timopieters6-spec/Autonome-zepplin-BLIMP-/README.md

# Autonome Zeppelin BLIMP

This repository serves as the central knowledge base for project-related files, reports, notes, and supporting materials connected to the Autonome Zeppelin BLIMP work.

## Purpose

The goal of this repository is to provide a single organized location for:
- project reports and findings
- supporting documentation
- reference files and templates
- notes and internal documentation
- data, assets, and related artifacts
- anything connected to the project’s development and documentation

## Repository Role

This repository is intended to act as a structured hub where all project information can be stored, reviewed, and accessed centrally. It helps keep materials organized and easy to find as the project evolves.

## Suggested Structure

A clean project structure may look like this:

```text
.
├── README.md
├── docs/
│   ├── reports/
│   ├── notes/
│   └── references/
├── data/
├── assets/
├── scripts/
├── templates/
├── exports/
└── misc/
