timopieters6-spec/Autonome-zepplin-BLIMP-/Software/Readme

Blimp_Ws = pepper herman, autonoom systeem van de blimp
