timopieters6-spec/Autonome-zepplin-BLIMP-/3d print files (stl,3mf)/STL/V2/PLT_MAIN_TOT_V2_CF-LESS_2025-2-20.stl

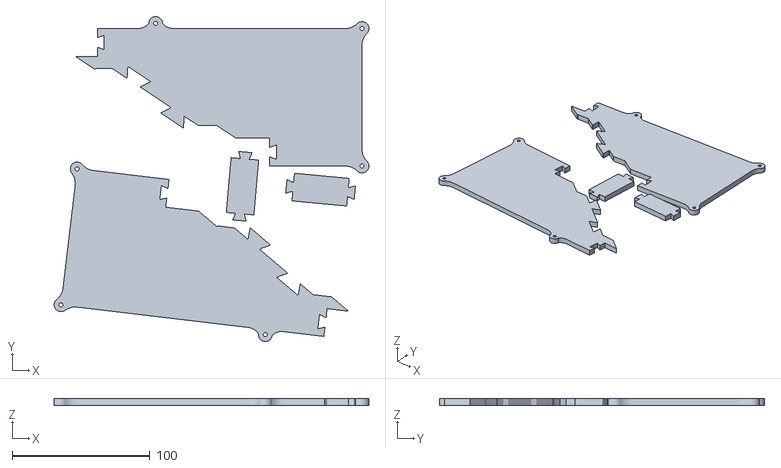
[picture p66: CAD file, 2026-09-20]
3d print files (stl,3mf)/STL/V2/PLT_MAIN_TOT_V2_CF-LESS_2025-2-20.stl
228.8 x 236.2 x 5.00
