timopieters6-spec/Autonome-zepplin-BLIMP-/3d print files (stl,3mf)/STL/V2/BLIMP_FULL_V2_3MF.3mf

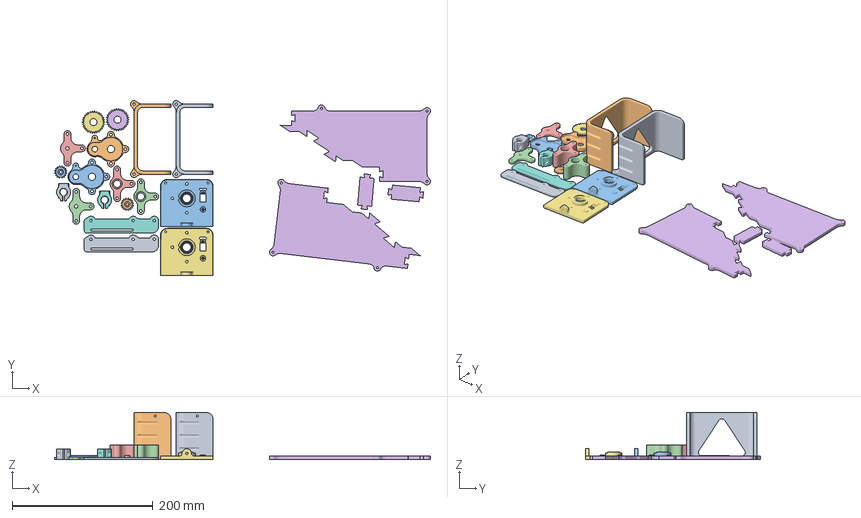
[picture p67: CAD file, 2026-09-20]
3d print files (stl,3mf)/STL/V2/BLIMP_FULL_V2_3MF.3mf
534.3 x 248.4 x 67.0 mm
BOX_FRONT_REAR_V4_CF_LESS_2025-2-20 - Copy.stl x 2
BOX_SIDE_V4_CF_LESS_2025-2-20 - Copy.stl x 2
BEAR_GEAR_HOUSING_SPACER_V1_2025-2-21 - Copy.stl x 2
PLT_MAIN_TOT_V2_CF-LESS_2025-2-20 - Copy.stl
ENV_ATTACH_V3_2025-2-20 - Copy.stl x 2
GEAR_HOUSING_SIDE_V1_2025-2-20 - Copy.stl x 2
GEAR_HOUSING_CAP_V1_2025-2-21 - Copy.stl x 2
GEAR_M1_Z30_FW3_V1_2025-2-20 - Copy.stl x 2
MNT_MOTOR_ARM_V2_2025-2-5.stl x 2
GEAR_M1_Z16_FW3_V1_2025-2-20 - Copy.stl x 2
