timopieters6-spec/Autonome-zepplin-BLIMP-/3d print files (stl,3mf)/3MF/BOX_TOT_v1_2025-02-01.3mf

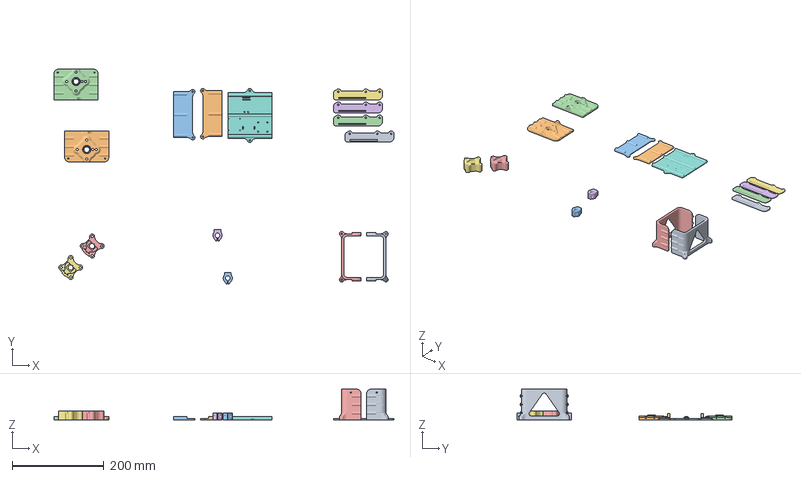
[picture p68: CAD file, 2026-09-20]
3d print files (stl,3mf)/3MF/BOX_TOT_v1_2025-02-01.3mf
739.7 x 467.2 x 67.0 mm
(1-2-25) Envelope attachments v2.STL x 4
(1-2-25) Box main v3.STL_A_B_B
(2-5-25) Motor mount v2.STL x 2
(1-2-25) Box main v3.STL_A_B_A
(1-2-25) inner bearings holder.STL x 2
(1-2-25) bottom plate v2.STL_B_A
(1-2-25) Box main v3.STL_A_A
(1-2-25) bottom plate v2.STL_B_B
(1-2-25) bottom plate v2.STL_A
(1-2-25) Box main v3.STL_B
