timopieters6-spec/Autonome-zepplin-BLIMP-/3d print files (stl,3mf)/STL/MNT_MOTOR_ARM_V2_2025-2-5.stl

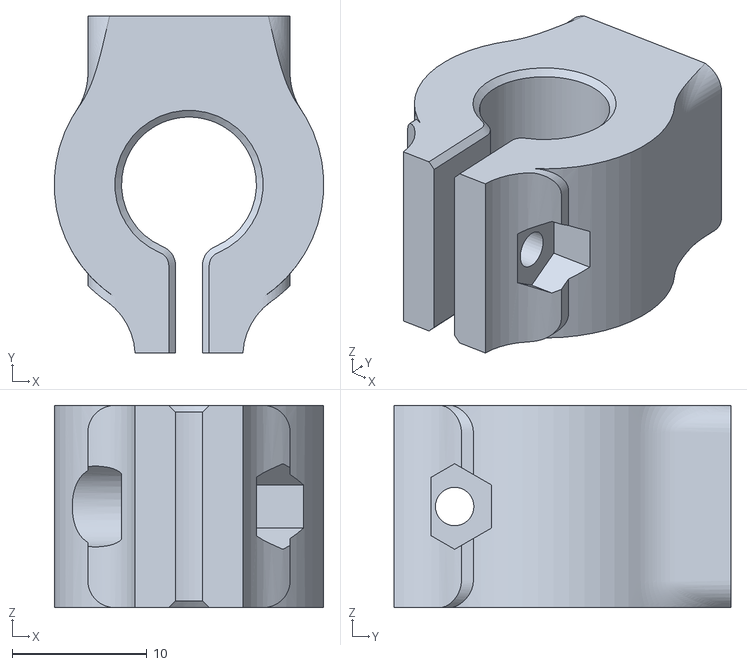
[picture p69: CAD file, 2026-09-20]
3d print files (stl,3mf)/STL/MNT_MOTOR_ARM_V2_2025-2-5.stl
20.0 x 25.0 x 15.0
