timopieters6-spec/Autonome-zepplin-BLIMP-/CAD files/Zepplin Frame v3.stl

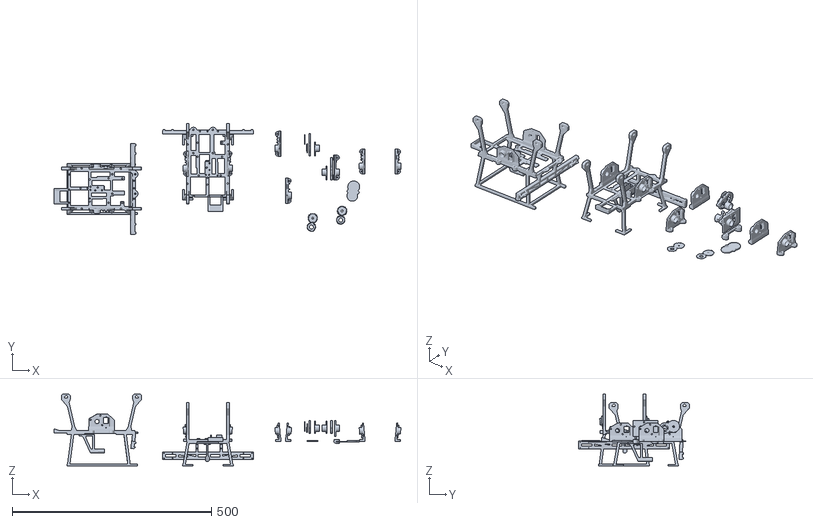
[picture p70: CAD file, 2026-09-20]
CAD files/Zepplin Frame v3.stl
871.8 x 278.4 x 180.7
