timopieters6-spec/Autonome-zepplin-BLIMP-/3d print files (stl,3mf)/3MF/BOX_TOT_v3_2025-04-09.3mf

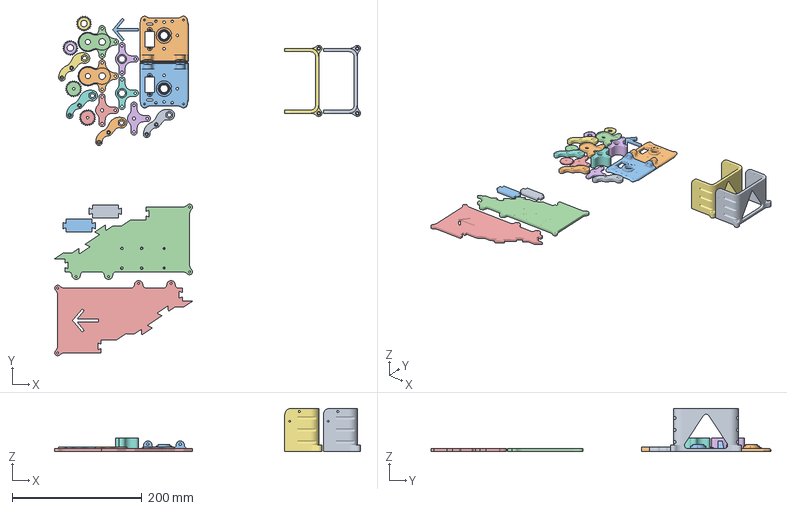
[picture p71: CAD file, 2026-09-20]
3d print files (stl,3mf)/3MF/BOX_TOT_v3_2025-04-09.3mf
472.1 x 524.1 x 67.0 mm
(2-24-25) Box main v4 front.stl x 2
(2-24-25) Box main v4_cf-less_MIR.stl
(2-24-25) Box main v4_cf-less.stl
(19-4-25) lower part bottom plate.stl
(19-4-25) Upper part bottom plate.stl
(2-22-25) Bearing spacer.STL x 2
Bowtie v3.stl x 2
(2-24-25) Gear housing side.STL x 2
(2-22-25) Bearing spacer cap.STL x 2
(1-24-25) Envelope attachments v3.stl x 4
Arrow.stl
(2-22-25) Spur Gear z23 m1 fw3.STL x 2
(2-22-25) Spur Gear z21 m1 fw3.STL x 2
