timopieters6-spec/Autonome-zepplin-BLIMP-/3d print files (stl,3mf)/STL/PLT_MIDDLE_V2_2025-2-1.stl

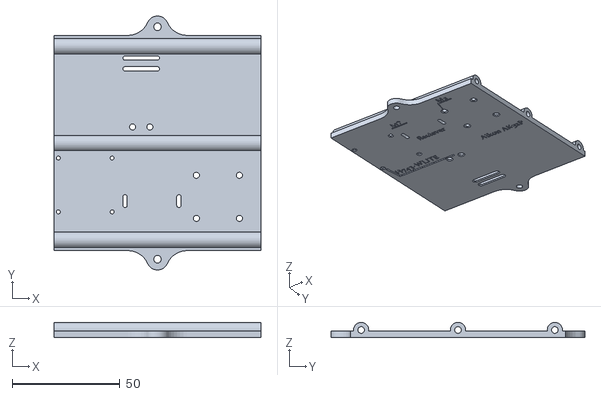
[picture p72: CAD file, 2026-09-20]
3d print files (stl,3mf)/STL/PLT_MIDDLE_V2_2025-2-1.stl
96.1 x 118.0 x 7.10
