timopieters6-spec/Autonome-zepplin-BLIMP-/3d print files (stl,3mf)/STL/V2/BEAR_HOUSING_CAP_V1_2025-2-21.stl

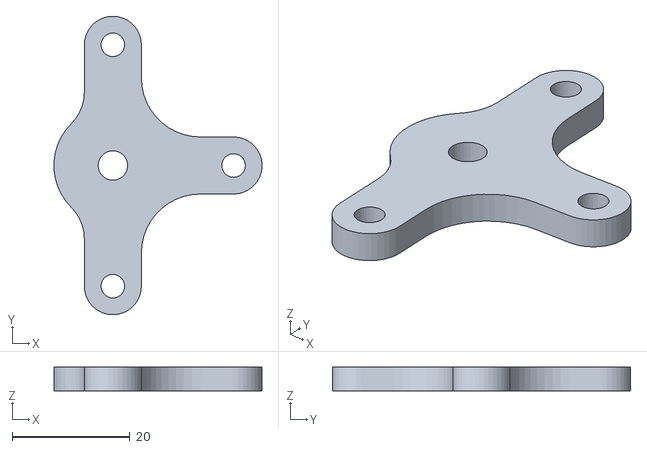
[picture p73: CAD file, 2026-09-20]
3d print files (stl,3mf)/STL/V2/BEAR_HOUSING_CAP_V1_2025-2-21.stl
35.3 x 50.7 x 4.00
