timopieters6-spec/Autonome-zepplin-BLIMP-/3d print files (stl,3mf)/3MF/BOX_TOT_v2_CF_2025-02-20.3mf

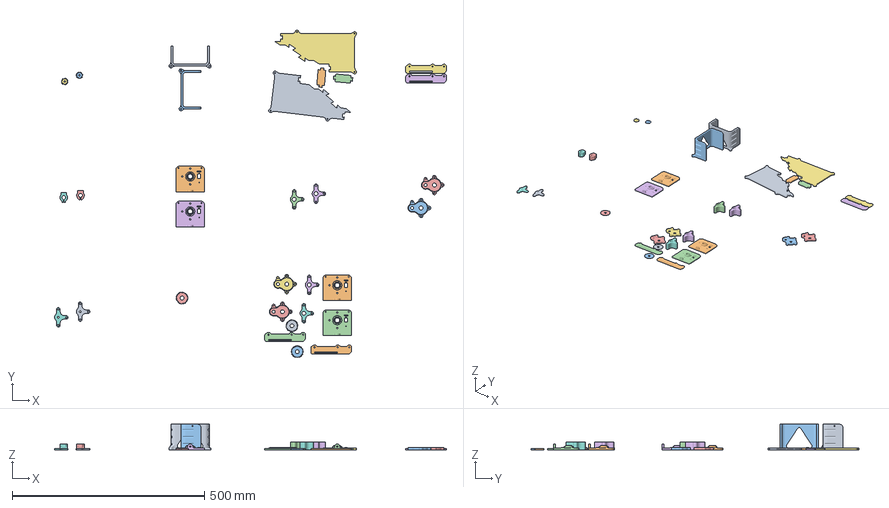
[picture p74: CAD file, 2026-09-20]
3d print files (stl,3mf)/3MF/BOX_TOT_v2_CF_2025-02-20.3mf
1020.0 x 852.3 x 67.0 mm
(20-2-25) Box main v4 cf-less.STL_A_A
(20-2-25) Box main v4 cf-less.STL_A_B_A x 4
Gear 1, m1 z16 fw3.STL x 2
(2-20-25) Gear housing side.STL x 4
(2-21-25) Bearing spacer.STL x 4
(2-21-25) Bearing spacer cap.STL x 2
(1-24-25) Envelope attachments v2.STL x 4
Gear 2, m1 z30 fw3 hub 10.2.STL x 3
MNT_MOTOR_ARM_V2_2025-2-5.stl x 2
(2-23-25) Bottom platre v3.STL_B
(2-23-25) Bottom platre v3.STL_A_B_B
(2-23-25) Bottom platre v3.STL_A_B_A
(20-2-25) Box main v4 cf-less.STL_B
(2-23-25) Bottom platre v3.STL_A_A
