timopieters6-spec/Autonome-zepplin-BLIMP-/3d print files (stl,3mf)/STL/HOLD_BEAR_SERVO_V1_2025-2-1.stl

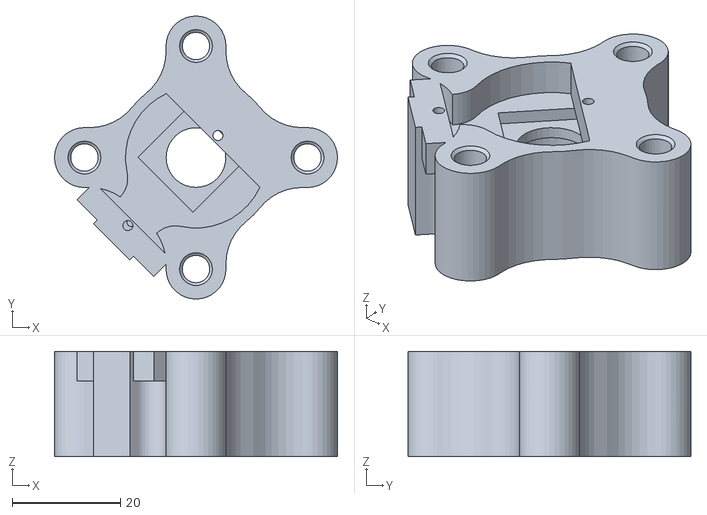
[picture p75: CAD file, 2026-09-20]
3d print files (stl,3mf)/STL/HOLD_BEAR_SERVO_V1_2025-2-1.stl
52.2 x 52.2 x 19.4
