timopieters6-spec/Autonome-zepplin-BLIMP-/3d print files (stl,3mf)/STL/V2/BOX_SIDE_V4_CF_LESS_2025-2-20.stl

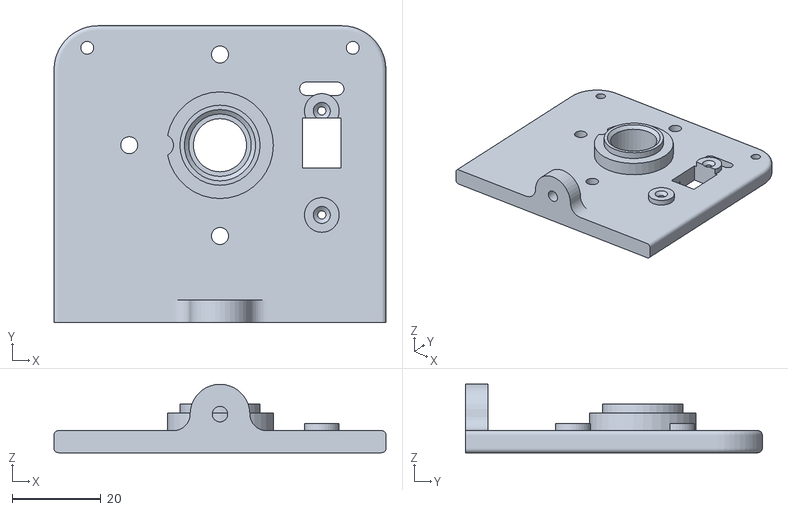
[picture p76: CAD file, 2026-09-20]
3d print files (stl,3mf)/STL/V2/BOX_SIDE_V4_CF_LESS_2025-2-20.stl
75.0 x 67.0 x 15.5
