timopieters6-spec/Autonome-zepplin-BLIMP-/3d print files (stl,3mf)/STL/PLT_OUTTER_V2_2025-2-1.stl

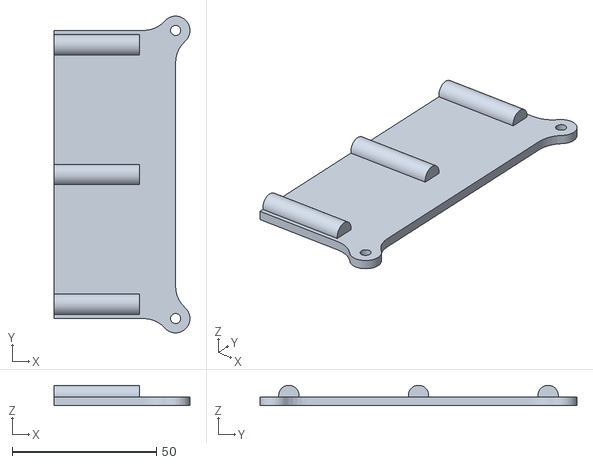
[picture p77: CAD file, 2026-09-20]
3d print files (stl,3mf)/STL/PLT_OUTTER_V2_2025-2-1.stl
47.2 x 110.0 x 7.10
