timopieters6-spec/Autonome-zepplin-BLIMP-/3d print files (stl,3mf)/STL/V2/GEAR_M1_Z30_FW3_V1_2025-2-20.stl

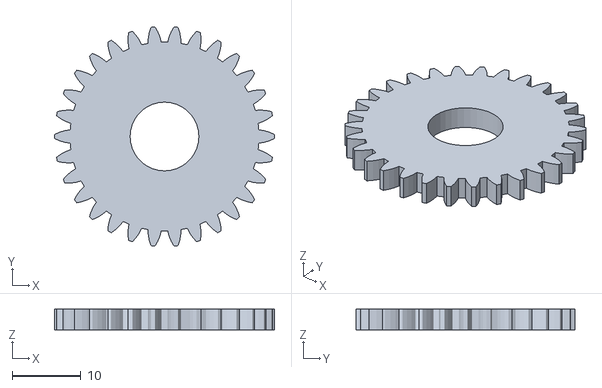
[picture p78: CAD file, 2026-09-20]
3d print files (stl,3mf)/STL/V2/GEAR_M1_Z30_FW3_V1_2025-2-20.stl
32.0 x 31.9 x 3.00
