timopieters6-spec/Autonome-zepplin-BLIMP-/3d print files (stl,3mf)/STL/ENV_ATTACH_V3_2025-2-20.stl

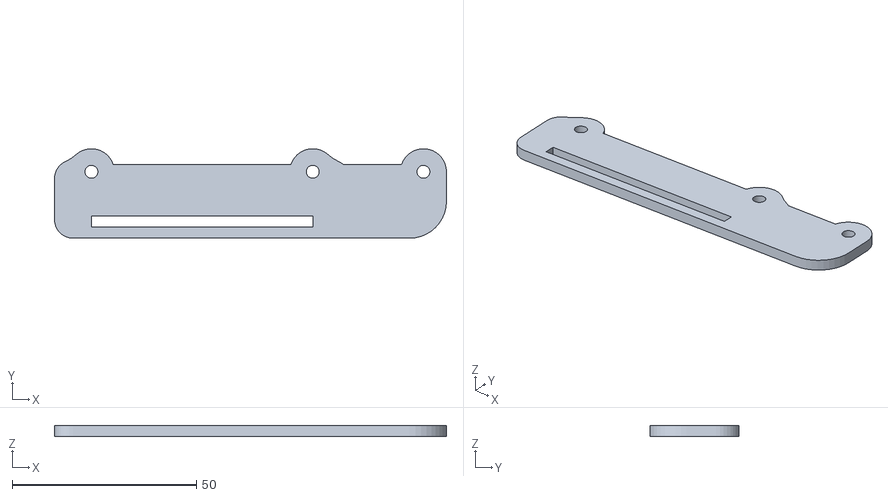
[picture p79: CAD file, 2026-09-20]
3d print files (stl,3mf)/STL/ENV_ATTACH_V3_2025-2-20.stl
106.2 x 24.2 x 3.00
