timopieters6-spec/Autonome-zepplin-BLIMP-/3d print files (stl,3mf)/STL/V2/GEAR_M1_Z16_FW3_V1_2025-2-20.stl

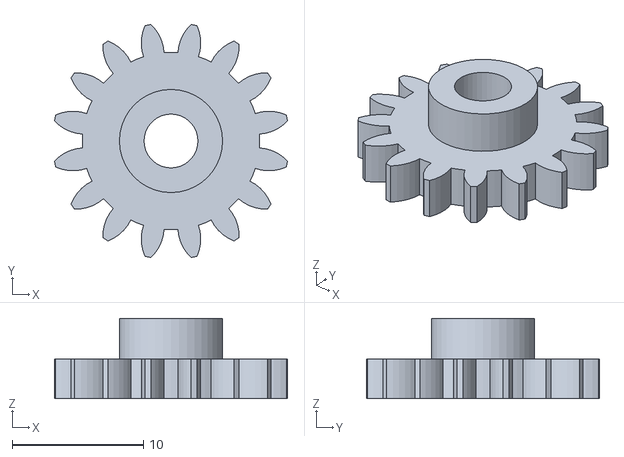
[picture p80: CAD file, 2026-09-20]
3d print files (stl,3mf)/STL/V2/GEAR_M1_Z16_FW3_V1_2025-2-20.stl
17.7 x 17.7 x 6.10
