timopieters6-spec/Autonome-zepplin-BLIMP-/3d print files (stl,3mf)/STL/PLT_BOTTOM_V2_2025-1-24.STL

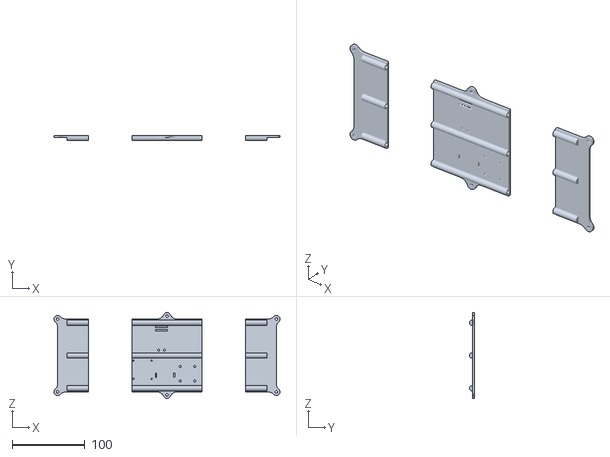
[picture p81: CAD file, 2026-09-20]
3d print files (stl,3mf)/STL/PLT_BOTTOM_V2_2025-1-24.STL
310.0 x 7.10 x 118.0
