timopieters6-spec/Autonome-zepplin-BLIMP-/3d print files (stl,3mf)/STL/BOX_SIDE_V3_2025-2-1.STL

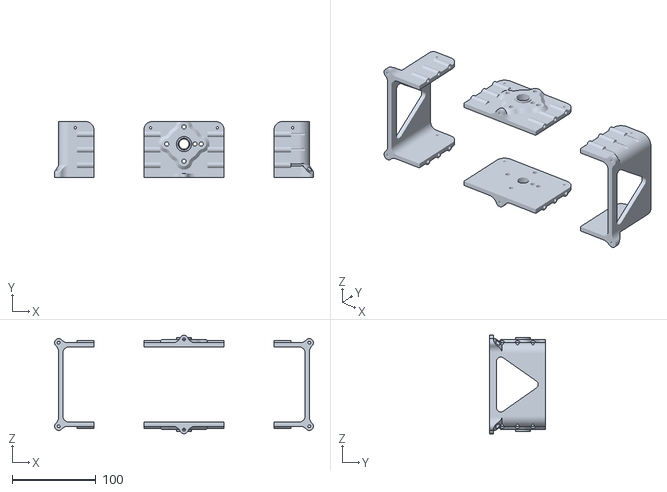
[picture p82: CAD file, 2026-09-20]
3d print files (stl,3mf)/STL/BOX_SIDE_V3_2025-2-1.STL
310.0 x 67.0 x 118.0
