timopieters6-spec/Autonome-zepplin-BLIMP-/3d print files (stl,3mf)/STL/V2/GEAR_HOUSING_SIDE_V1_2025-2-20.stl

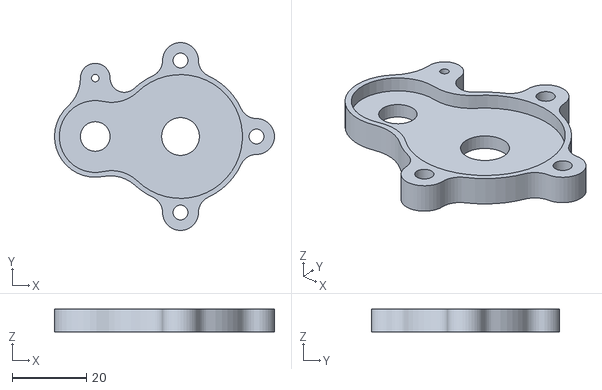
[picture p83: CAD file, 2026-09-20]
3d print files (stl,3mf)/STL/V2/GEAR_HOUSING_SIDE_V1_2025-2-20.stl
59.3 x 50.7 x 6.10
