timopieters6-spec/Autonome-zepplin-BLIMP-/3d print files (stl,3mf)/STL/V2/BOX_FRONT_REAR_V4_CF_LESS_2025-2-20.stl

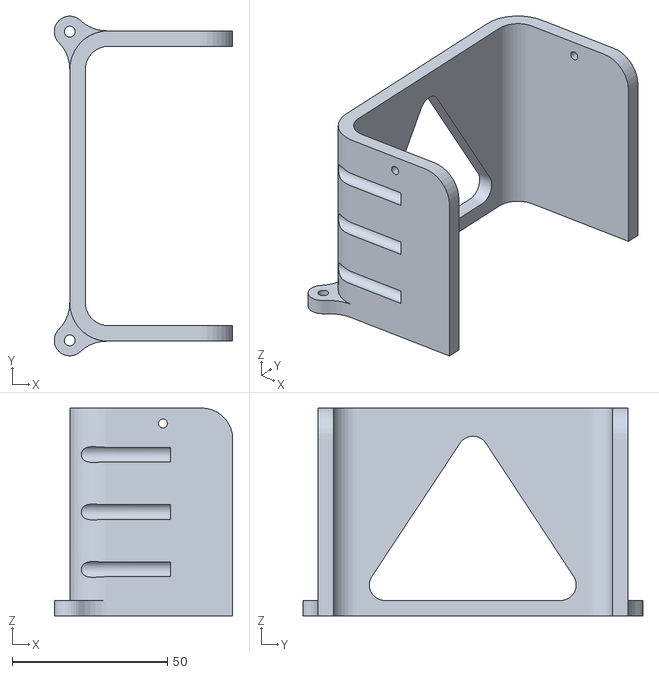
[picture p85: CAD file, 2026-09-20]
3d print files (stl,3mf)/STL/V2/BOX_FRONT_REAR_V4_CF_LESS_2025-2-20.stl
57.5 x 109.4 x 67.0
