timopieters6-spec/Autonome-zepplin-BLIMP-/(list of files, cad)

Other CAD files:
3d print files (stl,3mf)/STL/ENV_ATTACH_V2_2025-2-1.stl
3d print files (stl,3mf)/STL/V2/BEAR_GEAR_HOUSING_SPACER_V1_2025-2-21 - Copy.3mf
