timopieters6-spec/Autonome-zepplin-BLIMP-/Documentatie/HvAirship_Design_report.1pdf.pdf

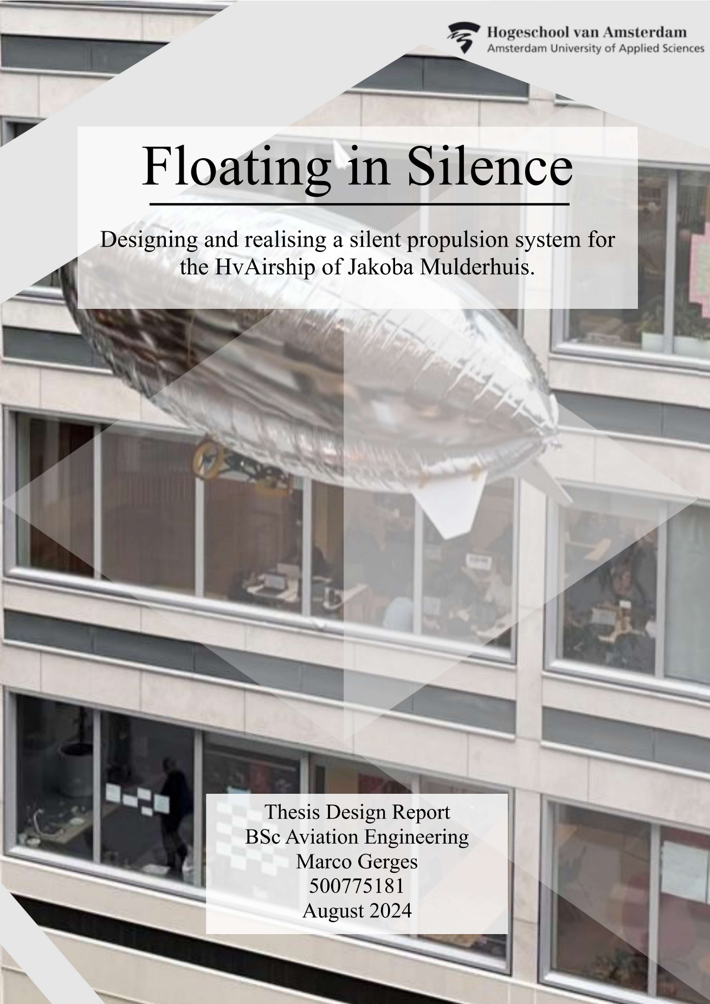
[picture p86: page 1]

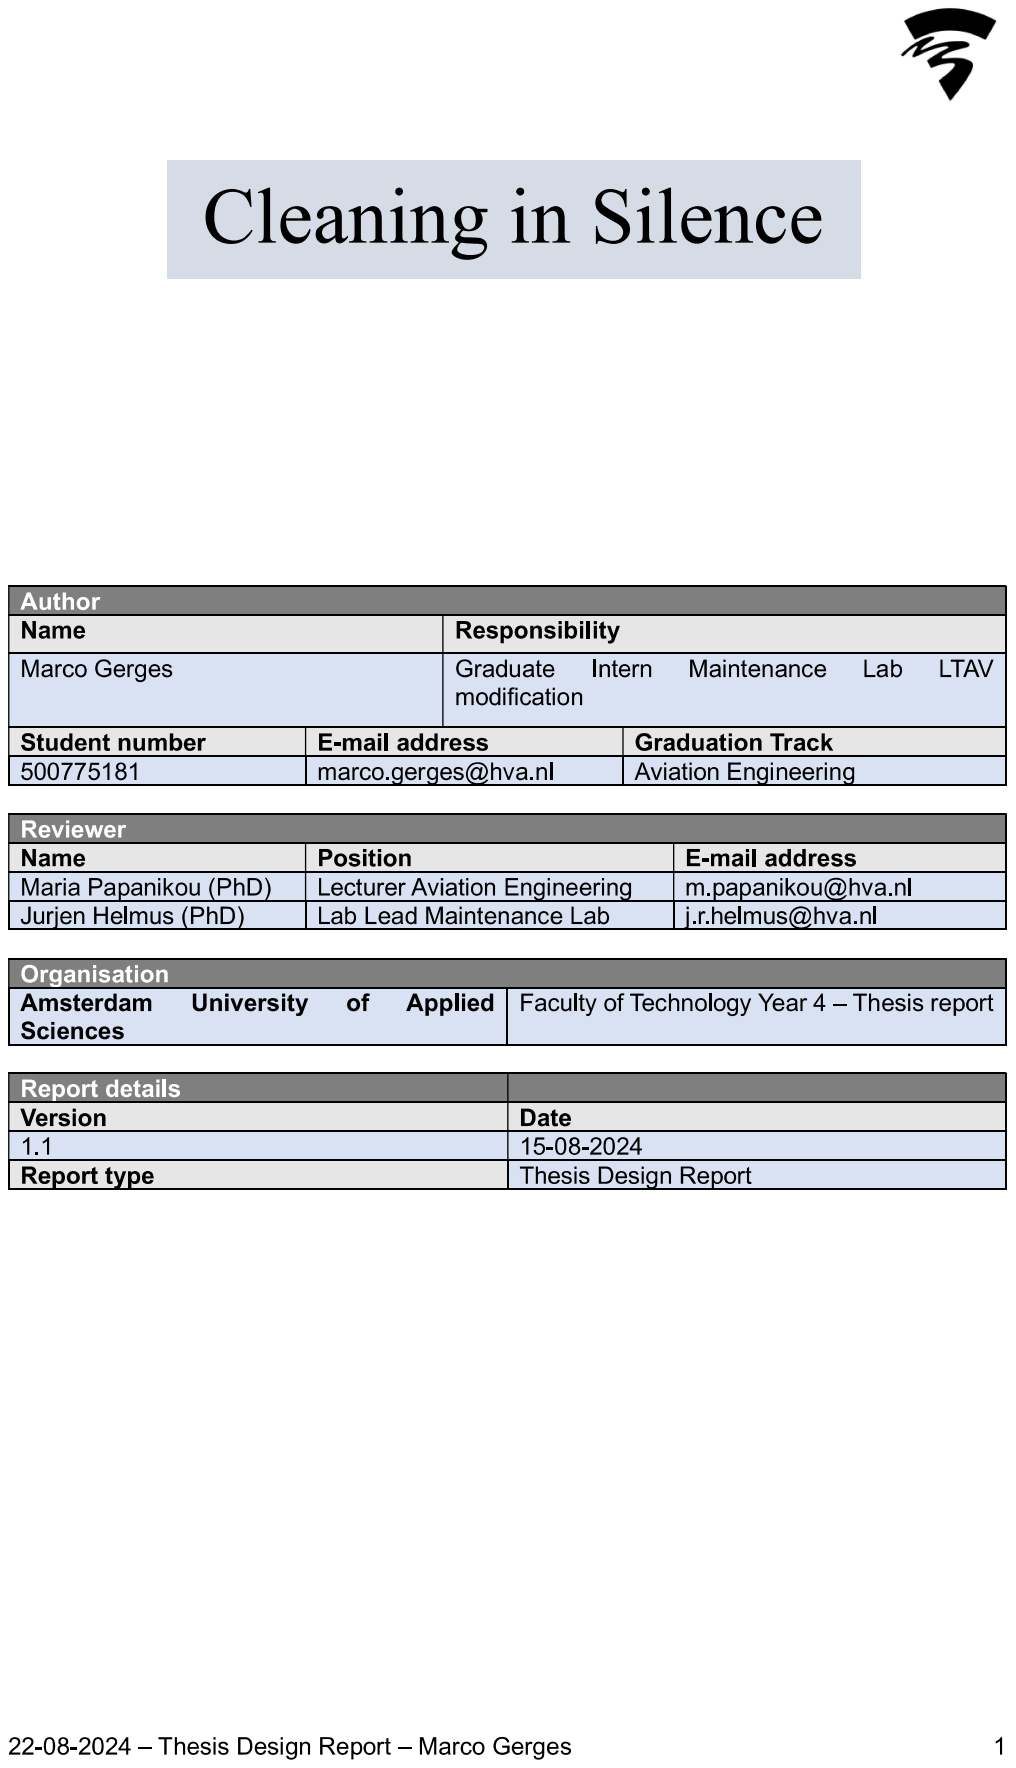
[picture p87: page 2]

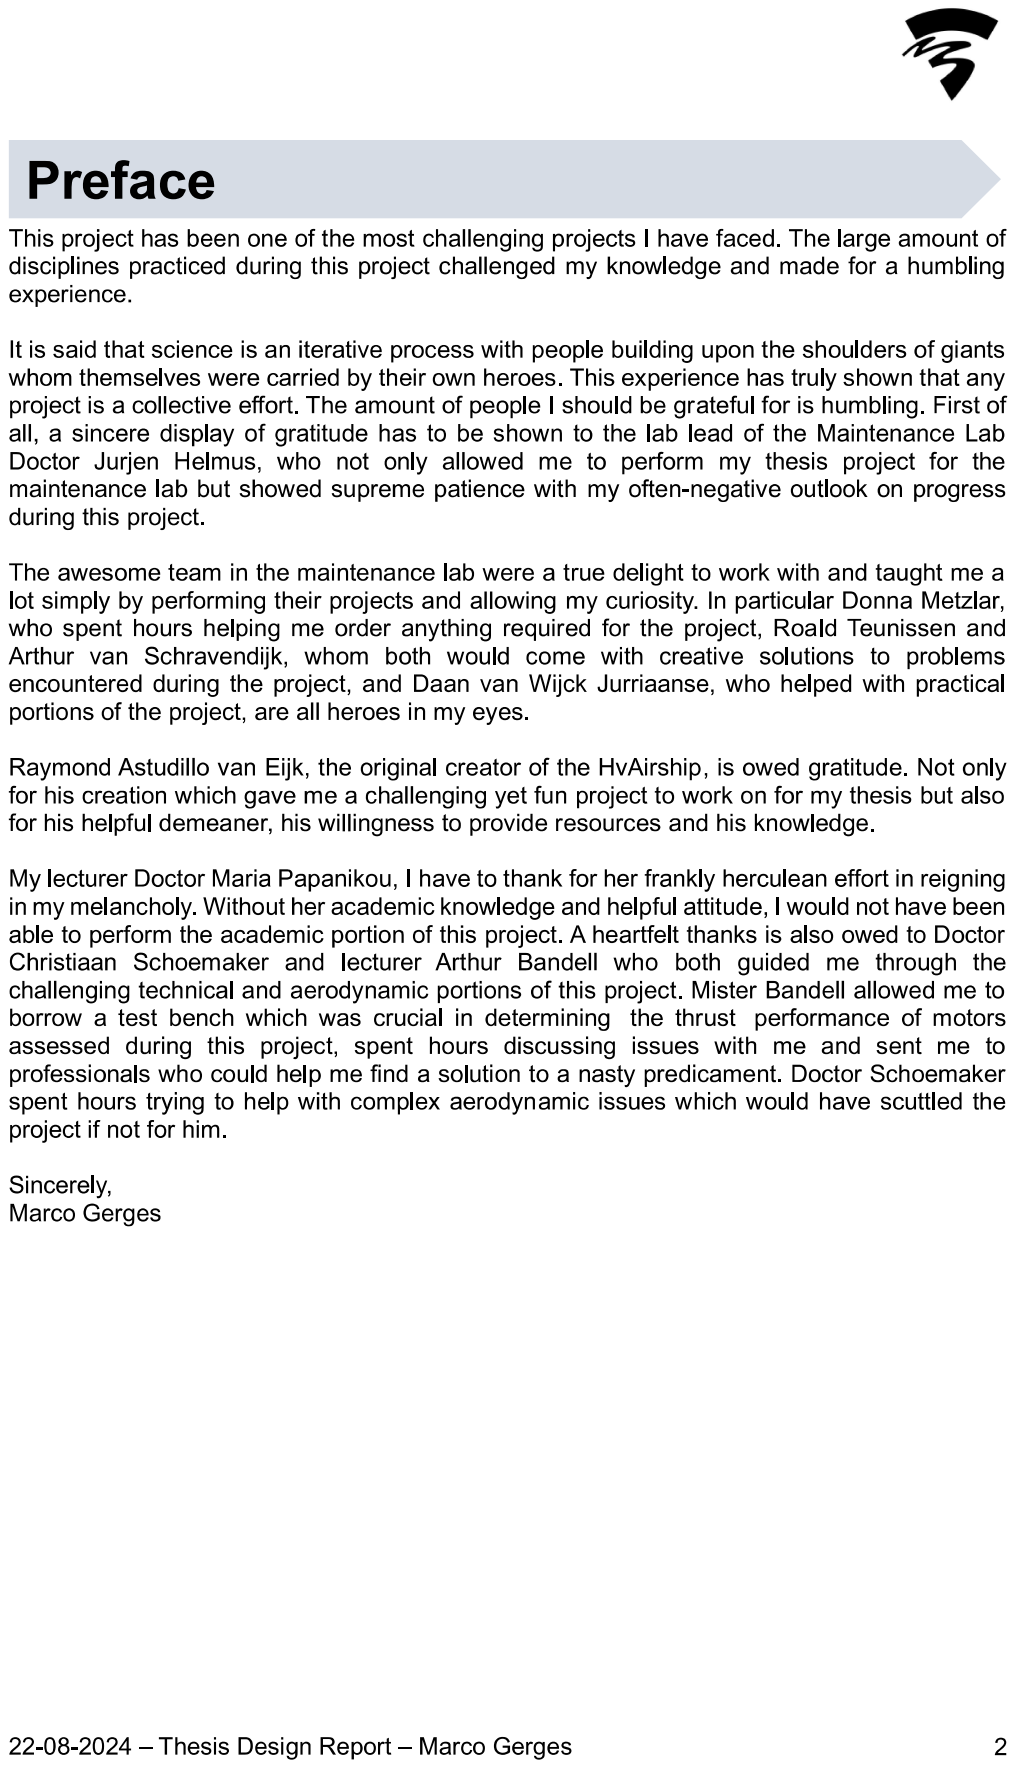
[picture p88: page 3]

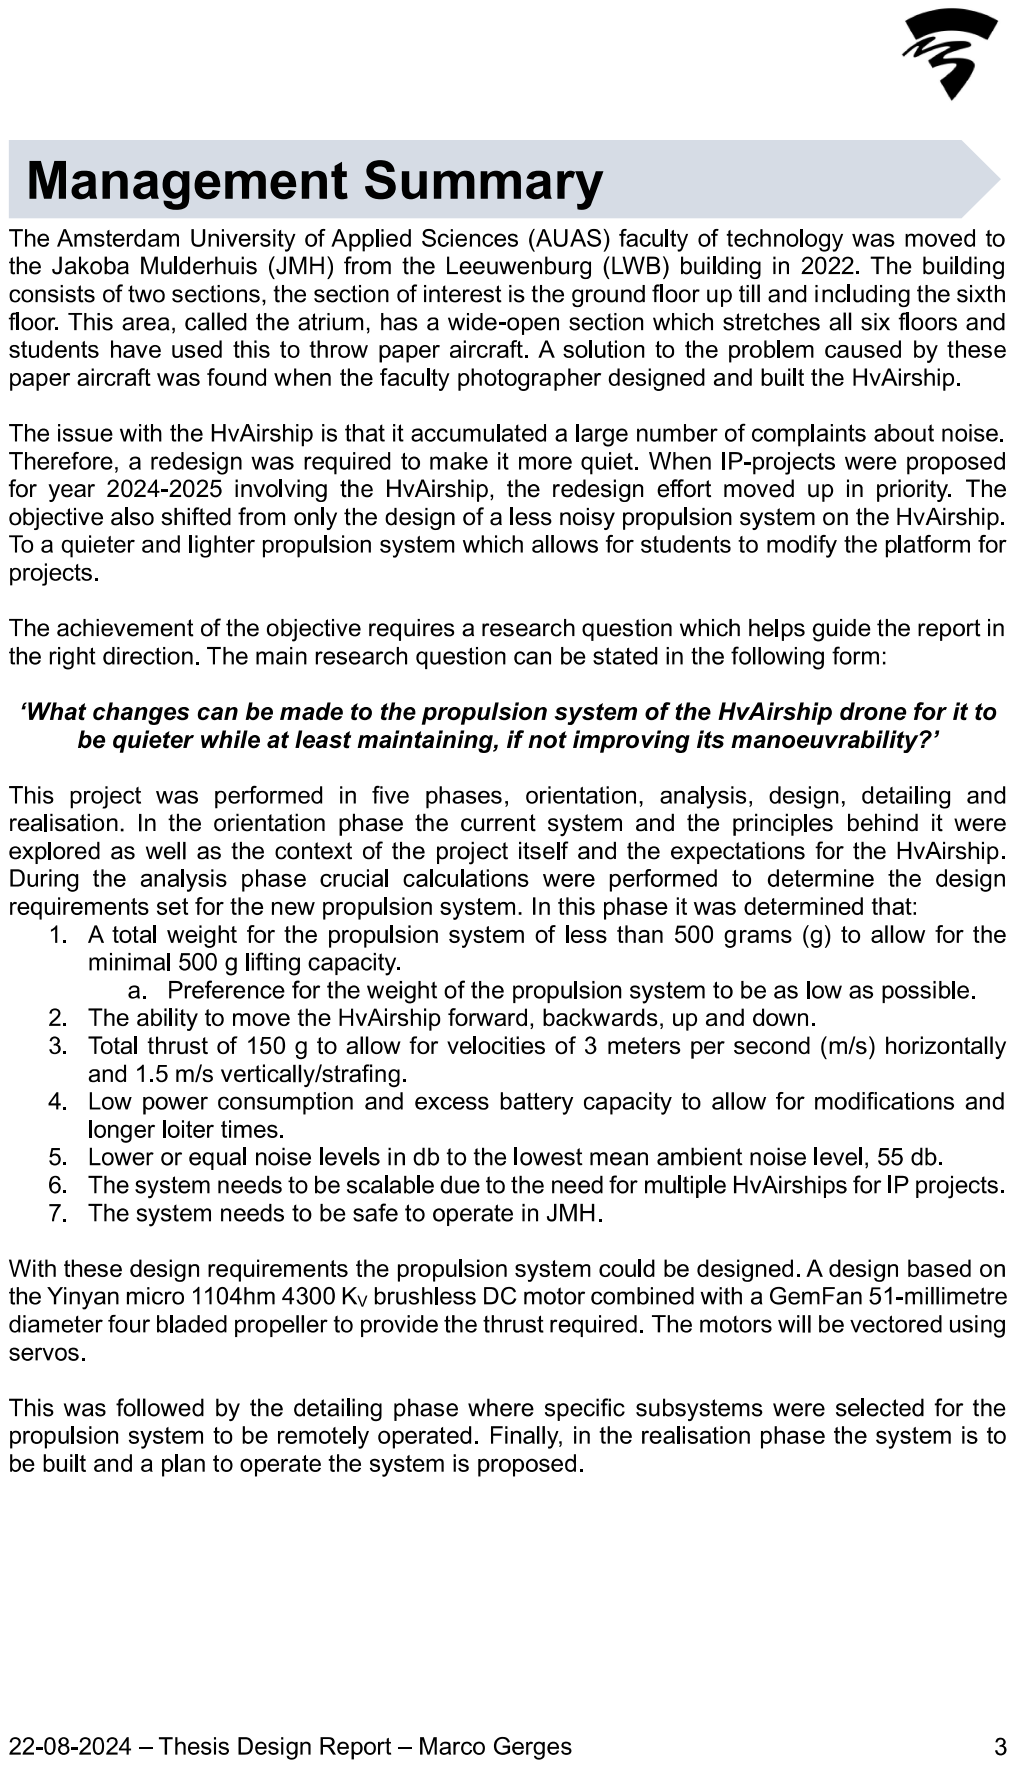
[picture p89: page 4]

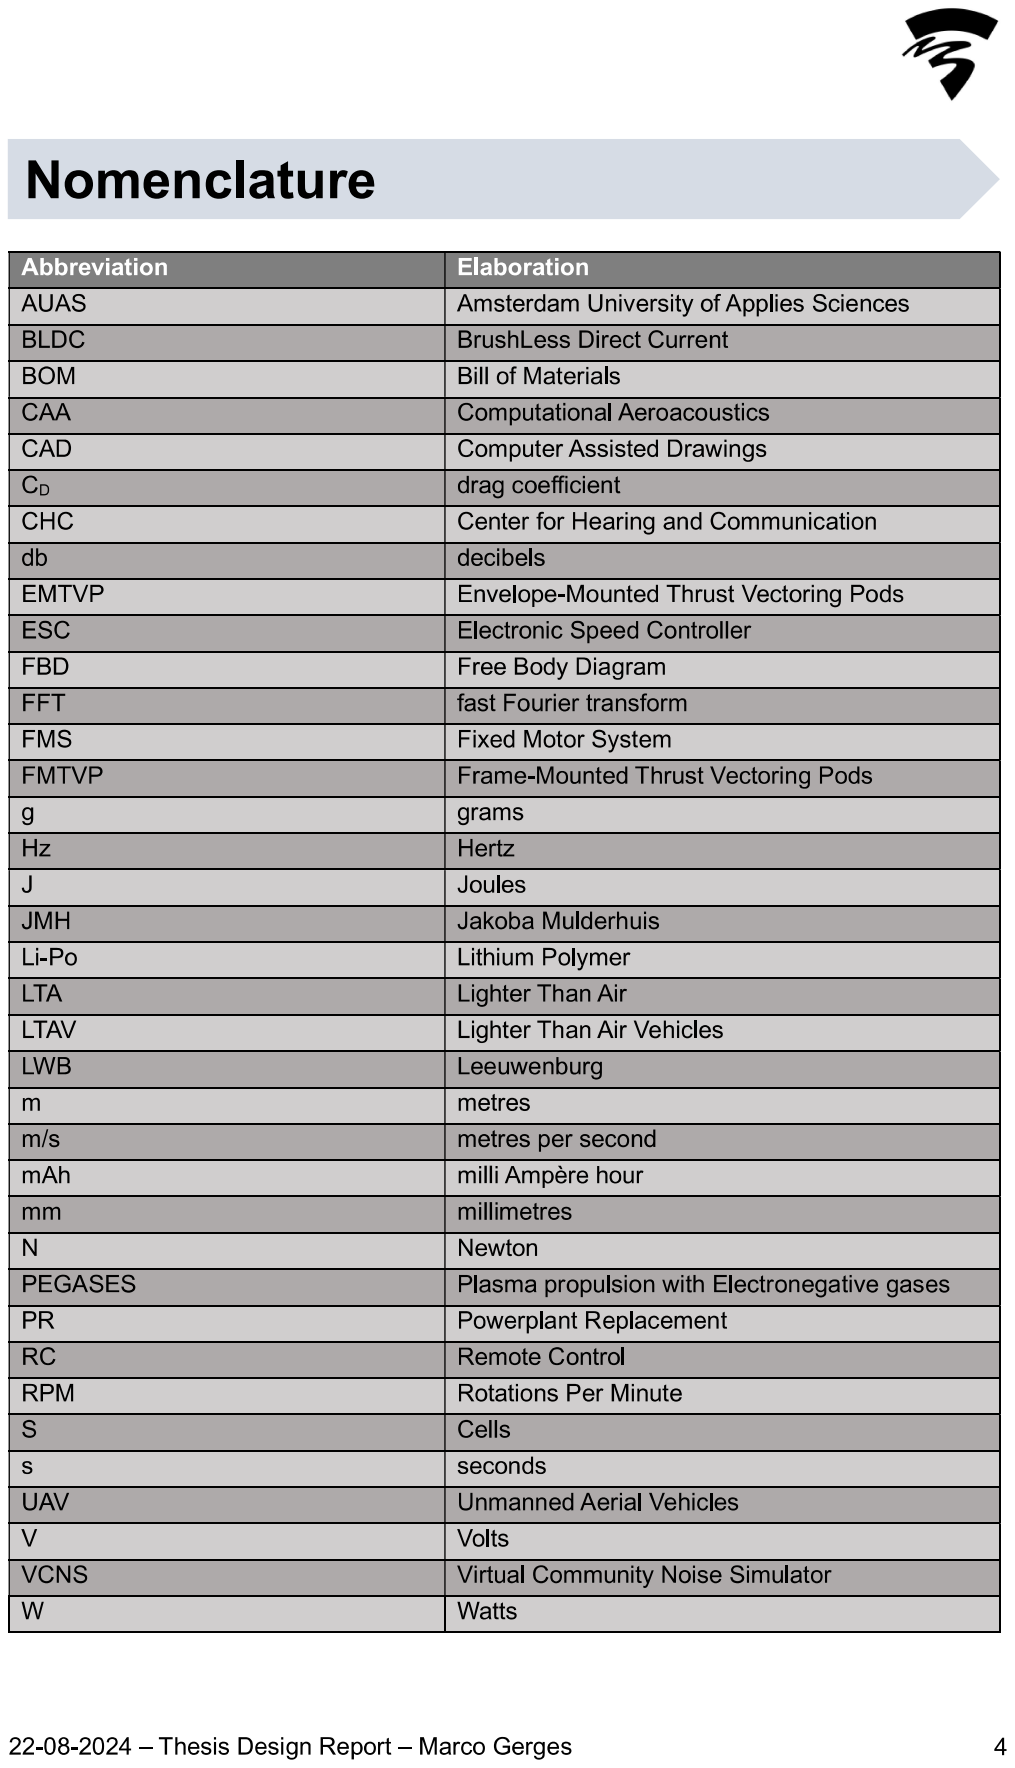
[picture p90: page 5]

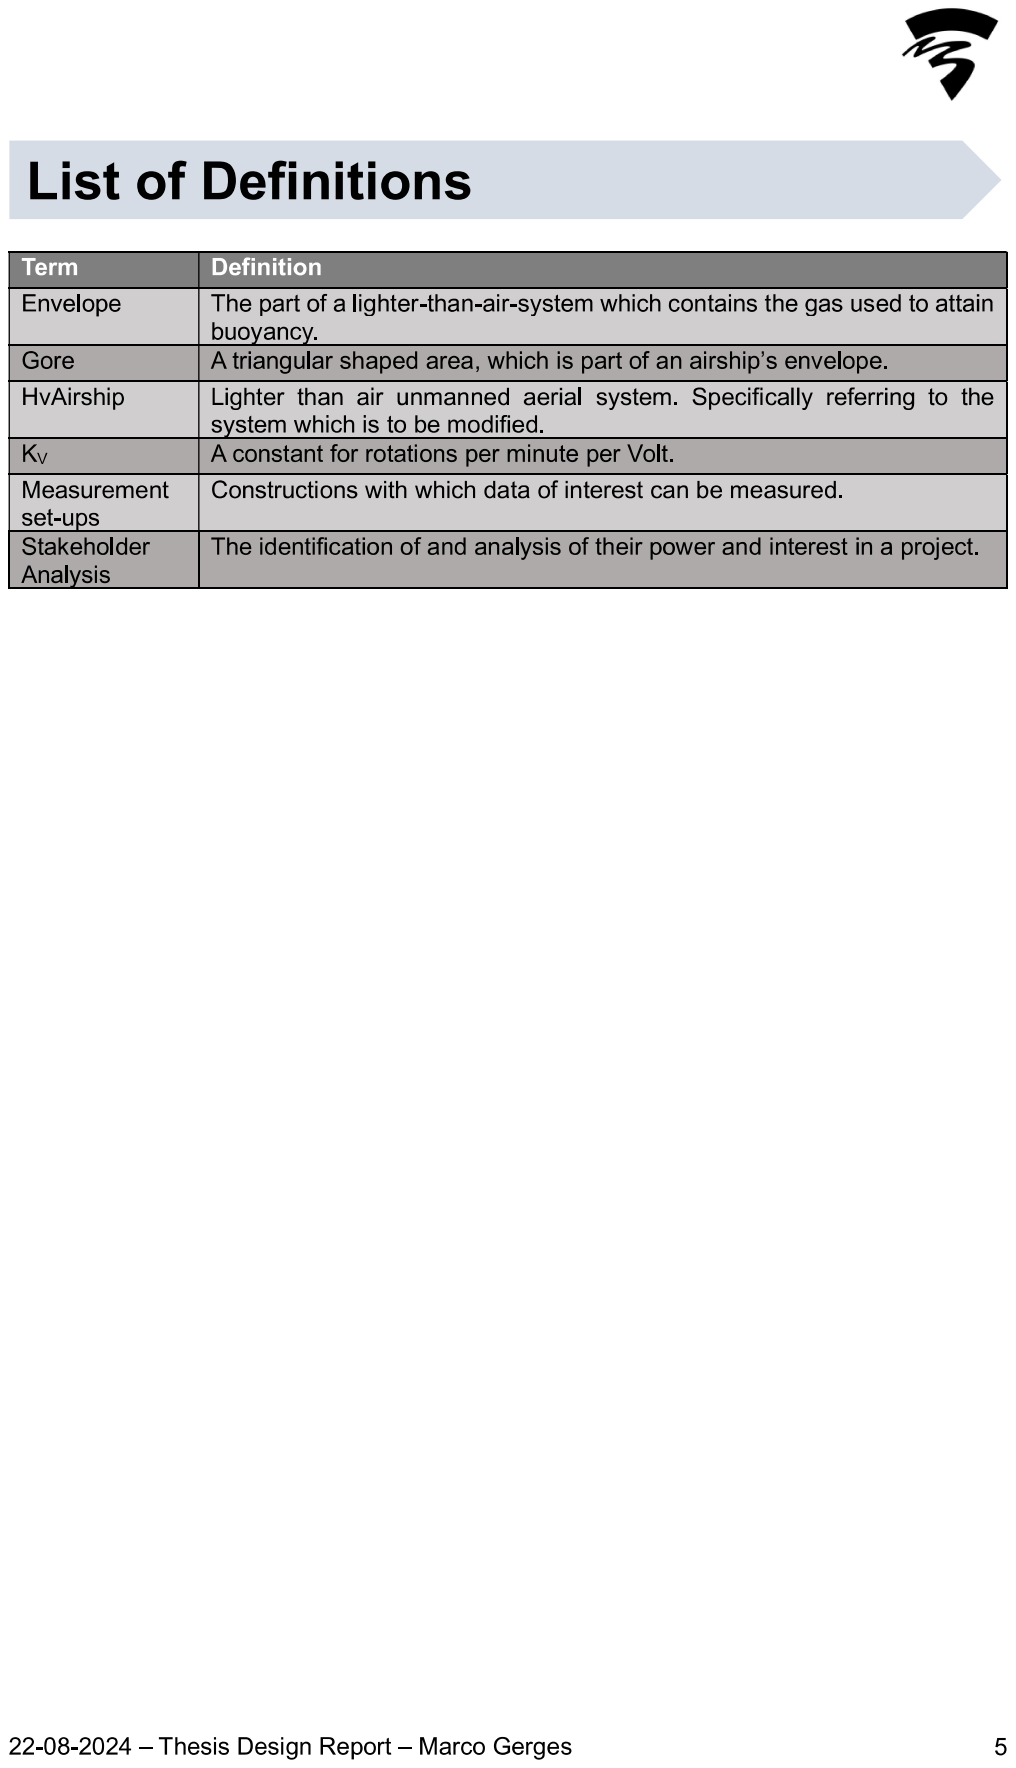
[picture p91: page 6]

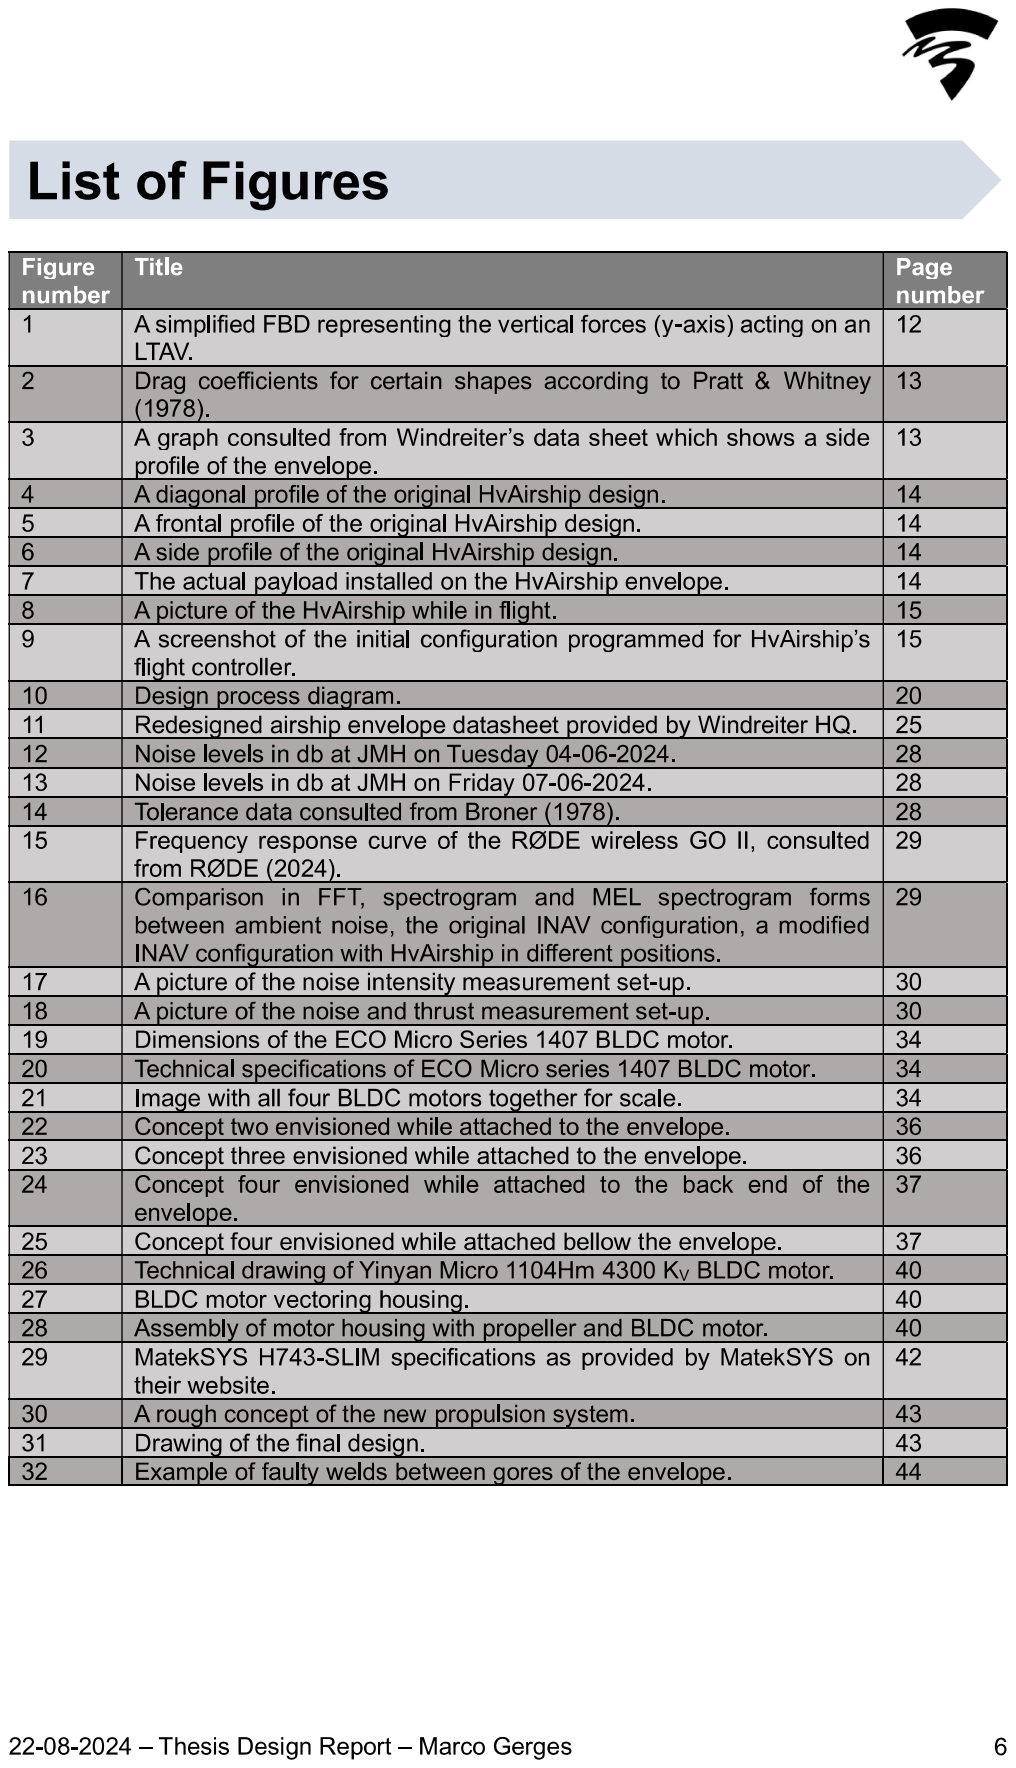
[picture p92: page 7]

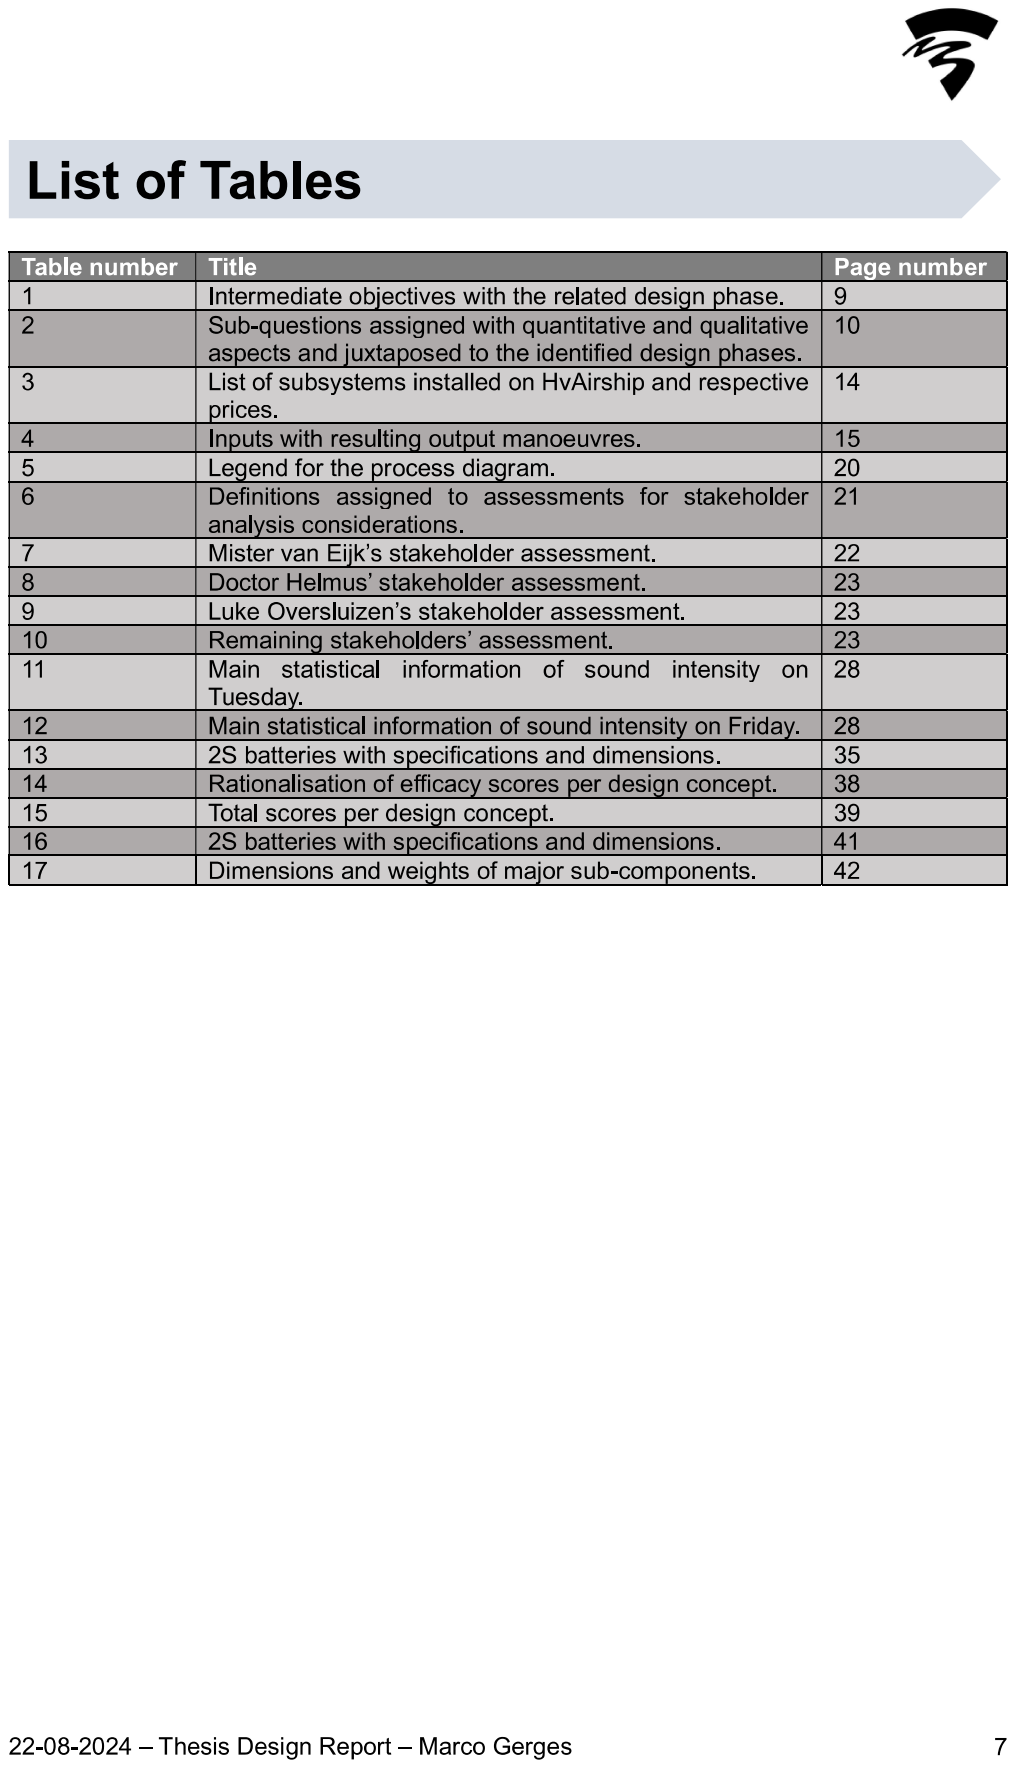
[picture p93: page 8]

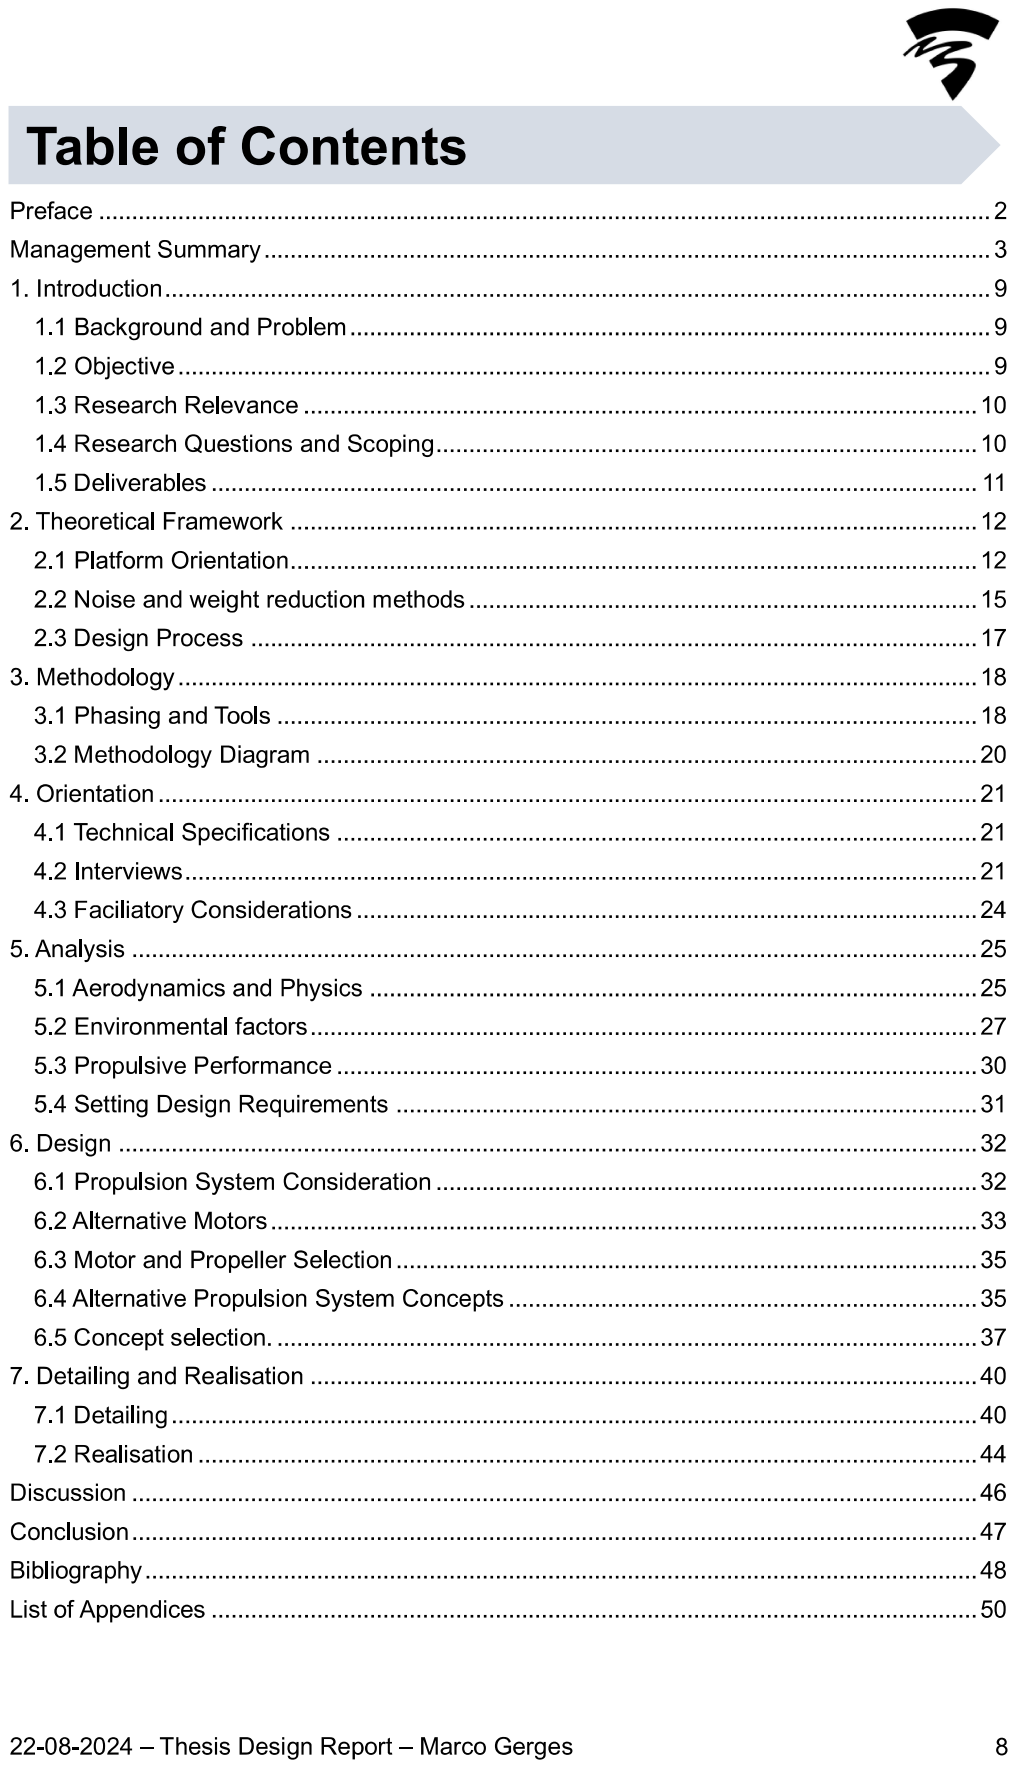
[picture p94: page 9]

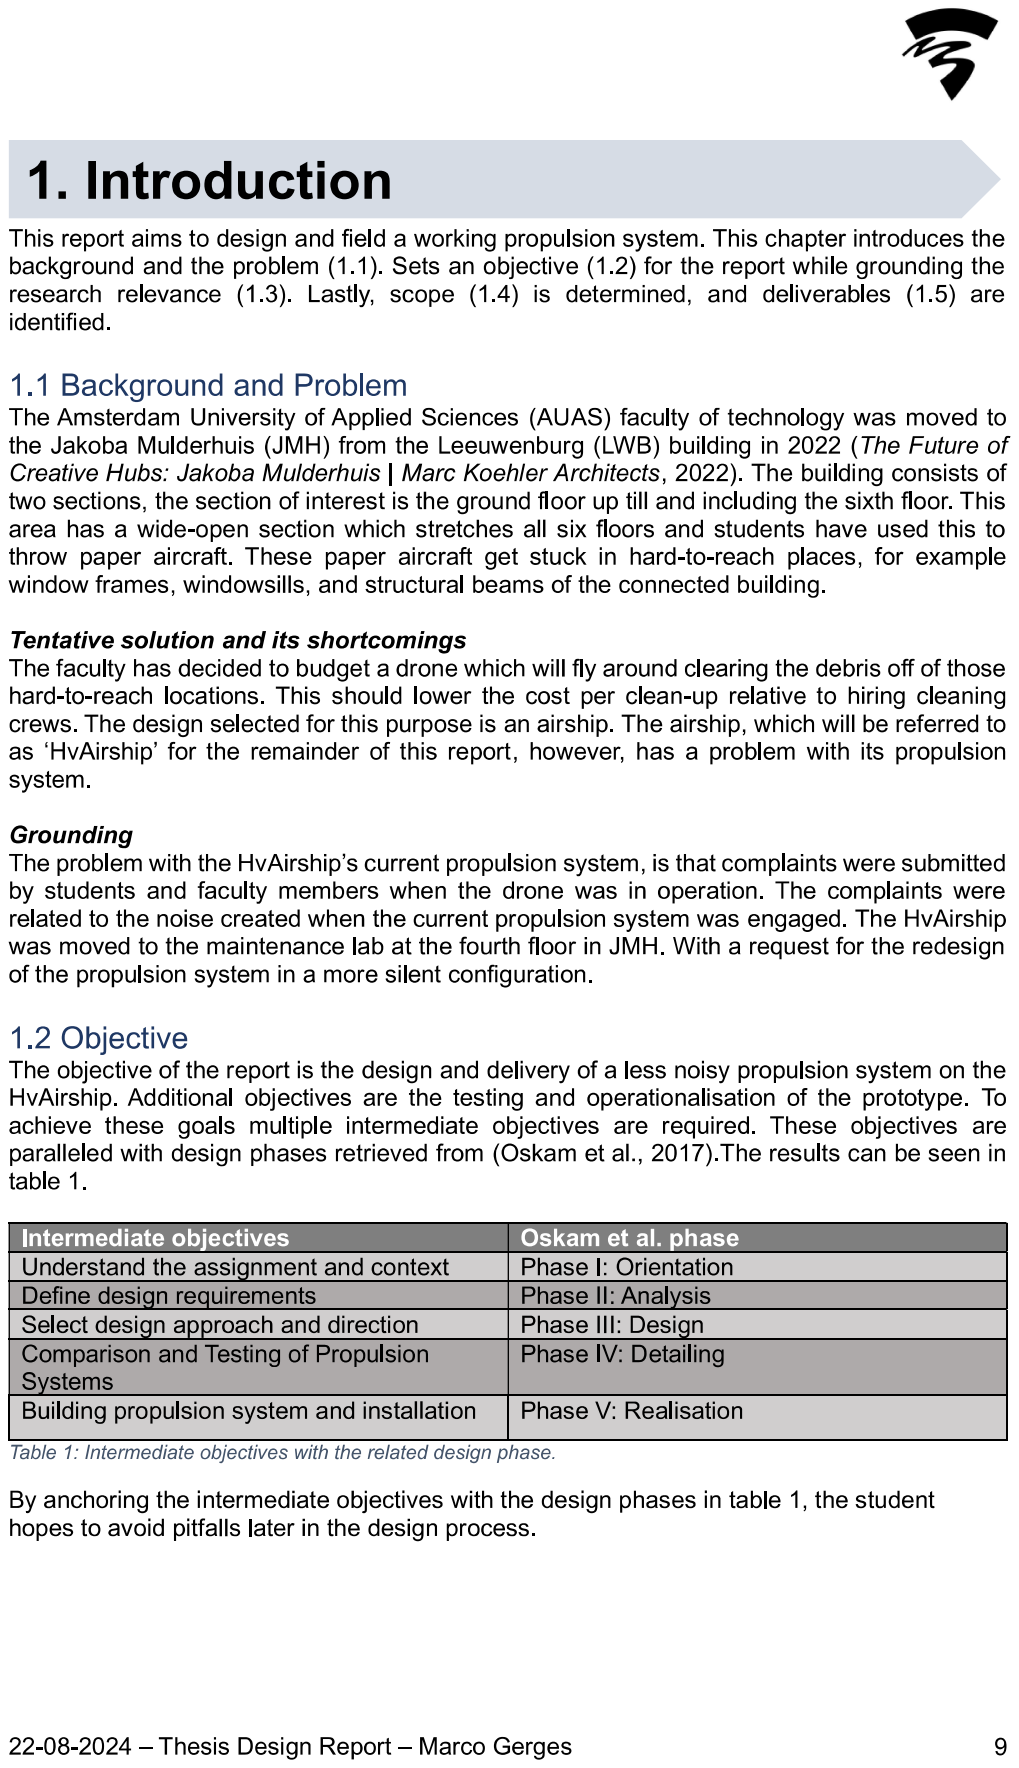
[picture p95: page 10]

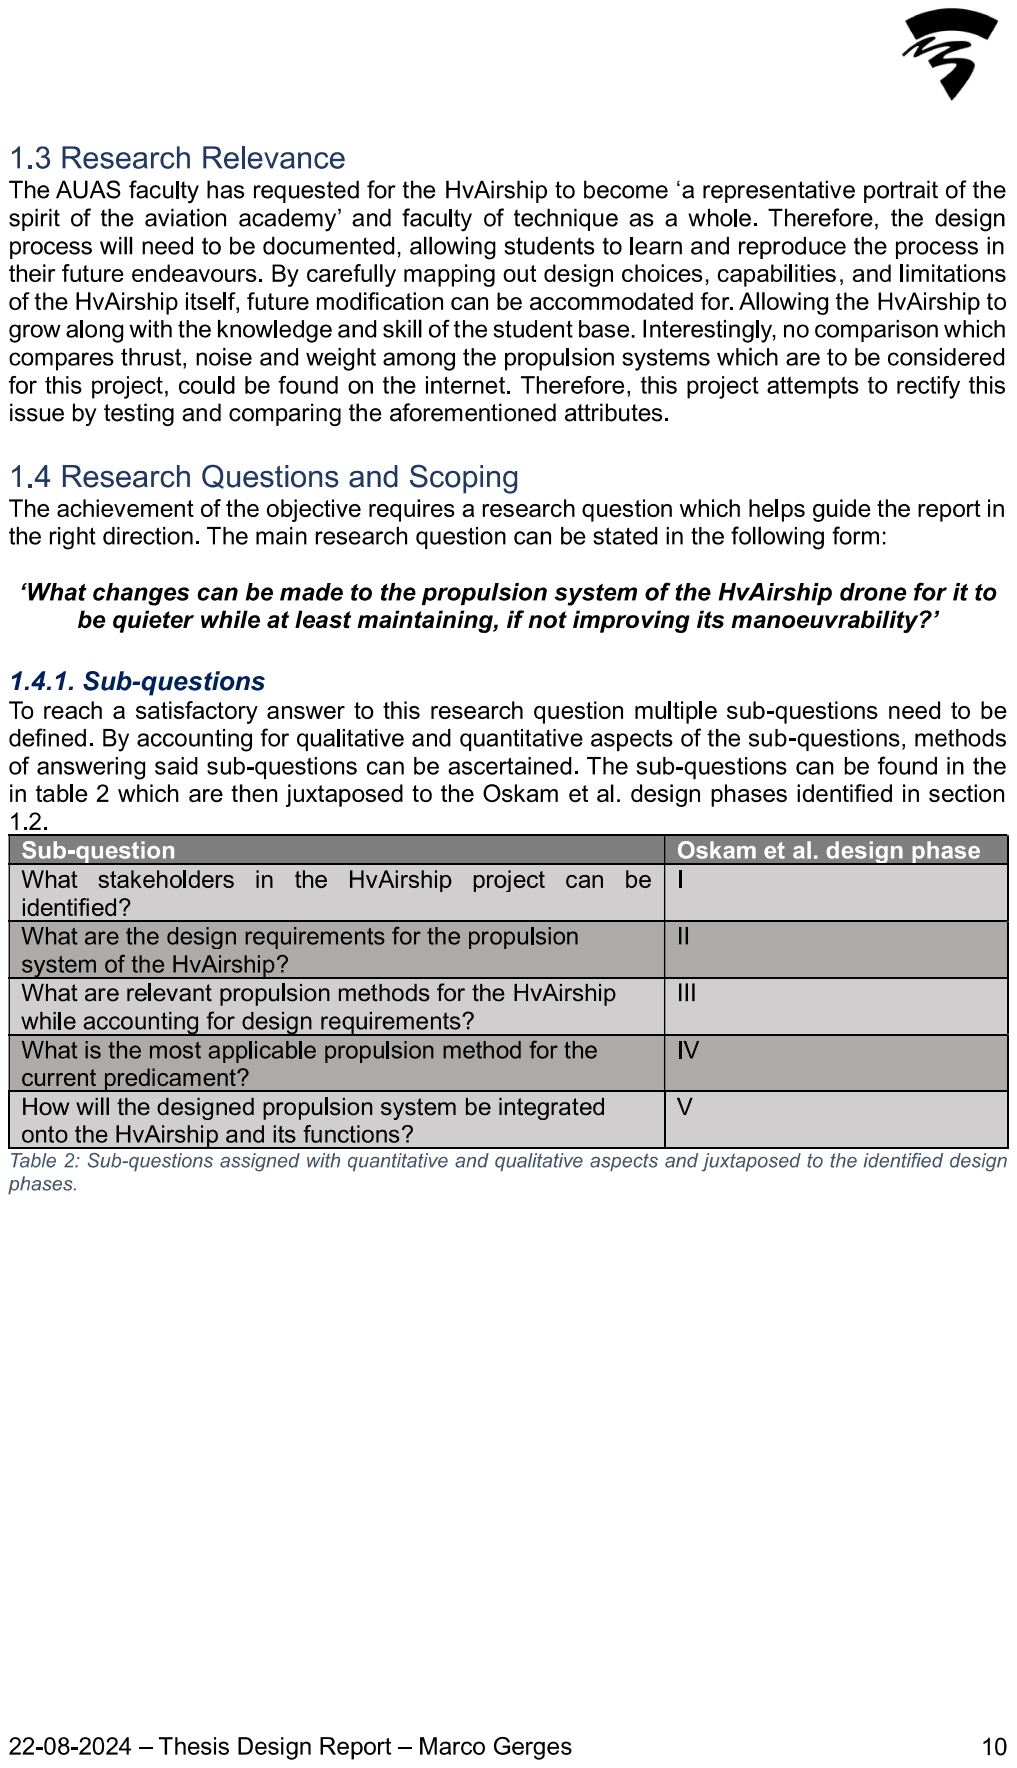
[picture p96: page 11]

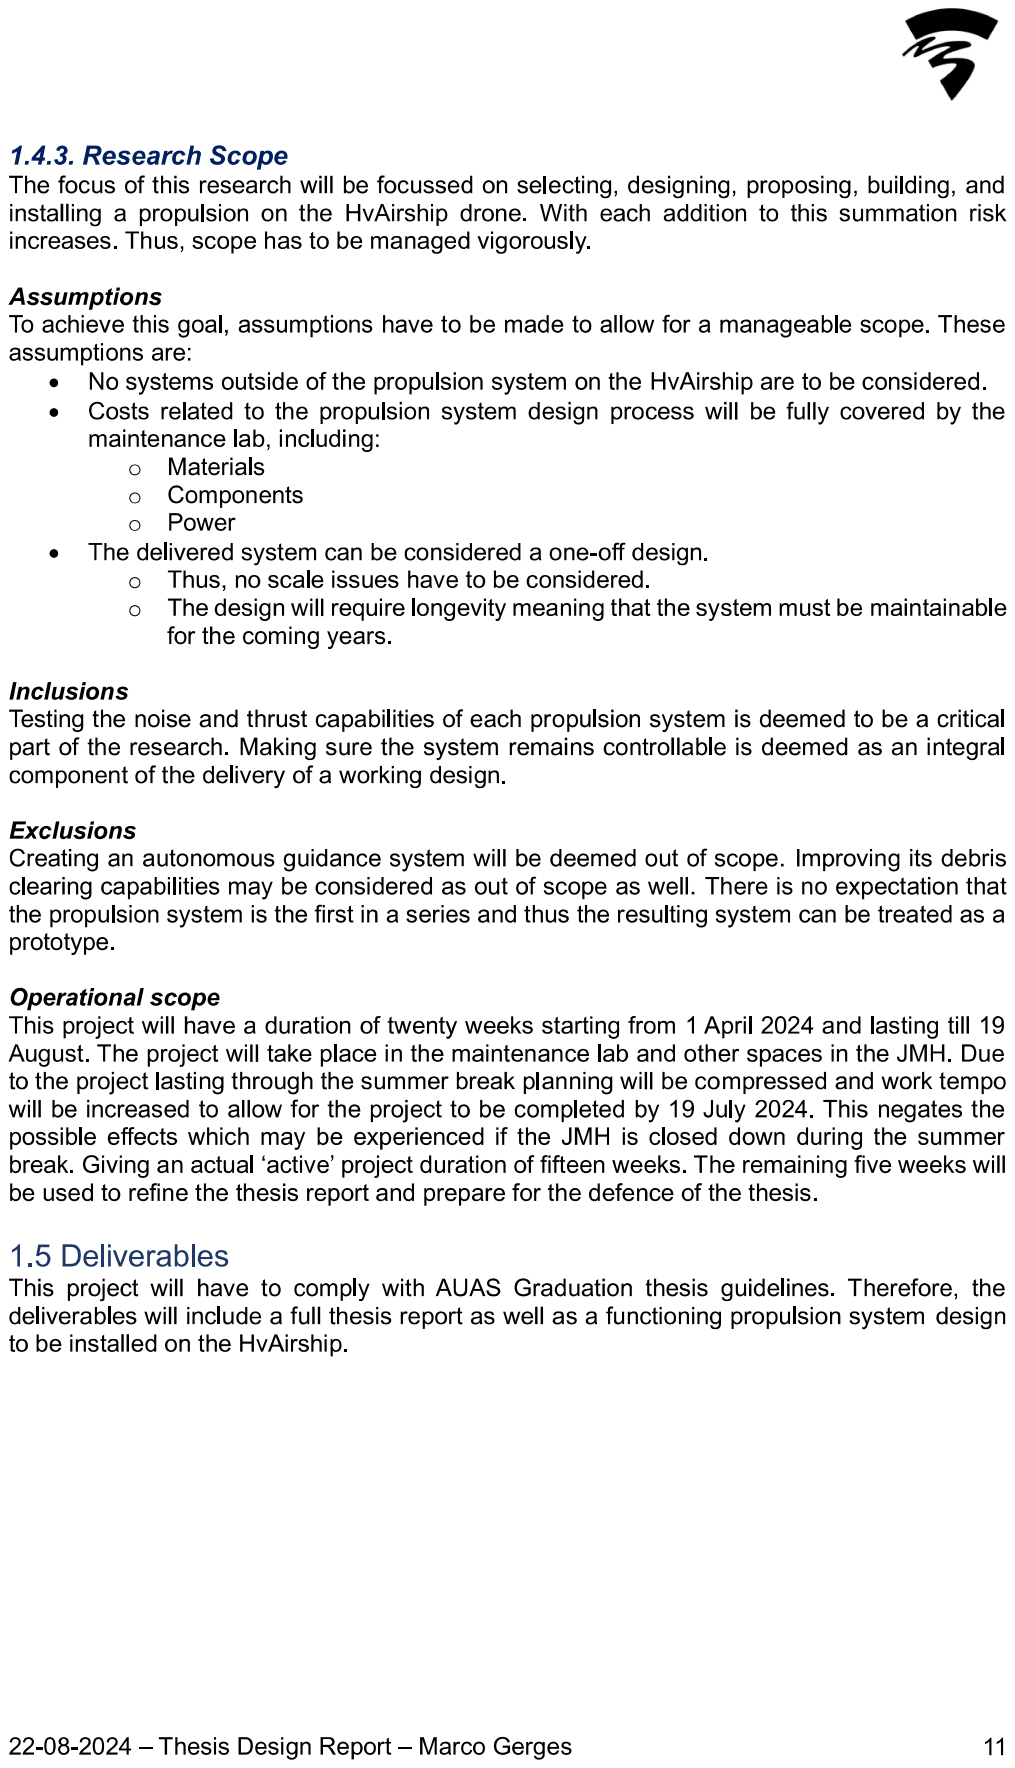
[picture p97: page 12]

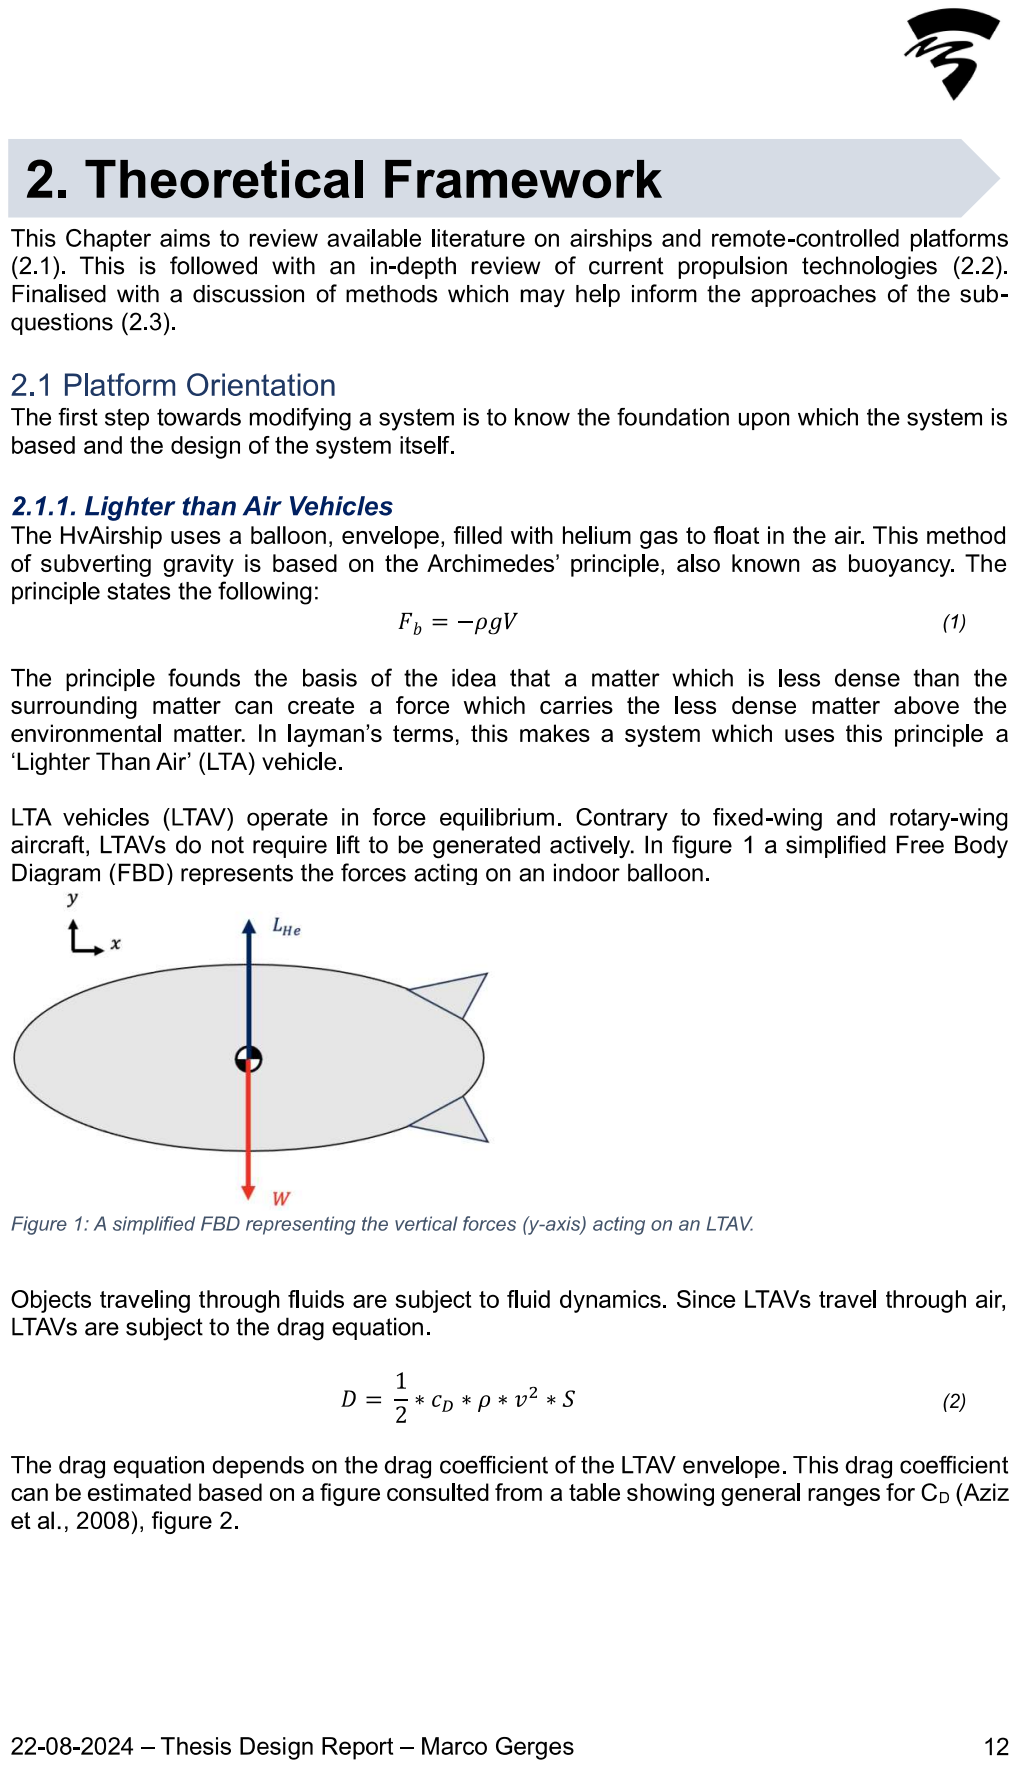
[picture p98: page 13]

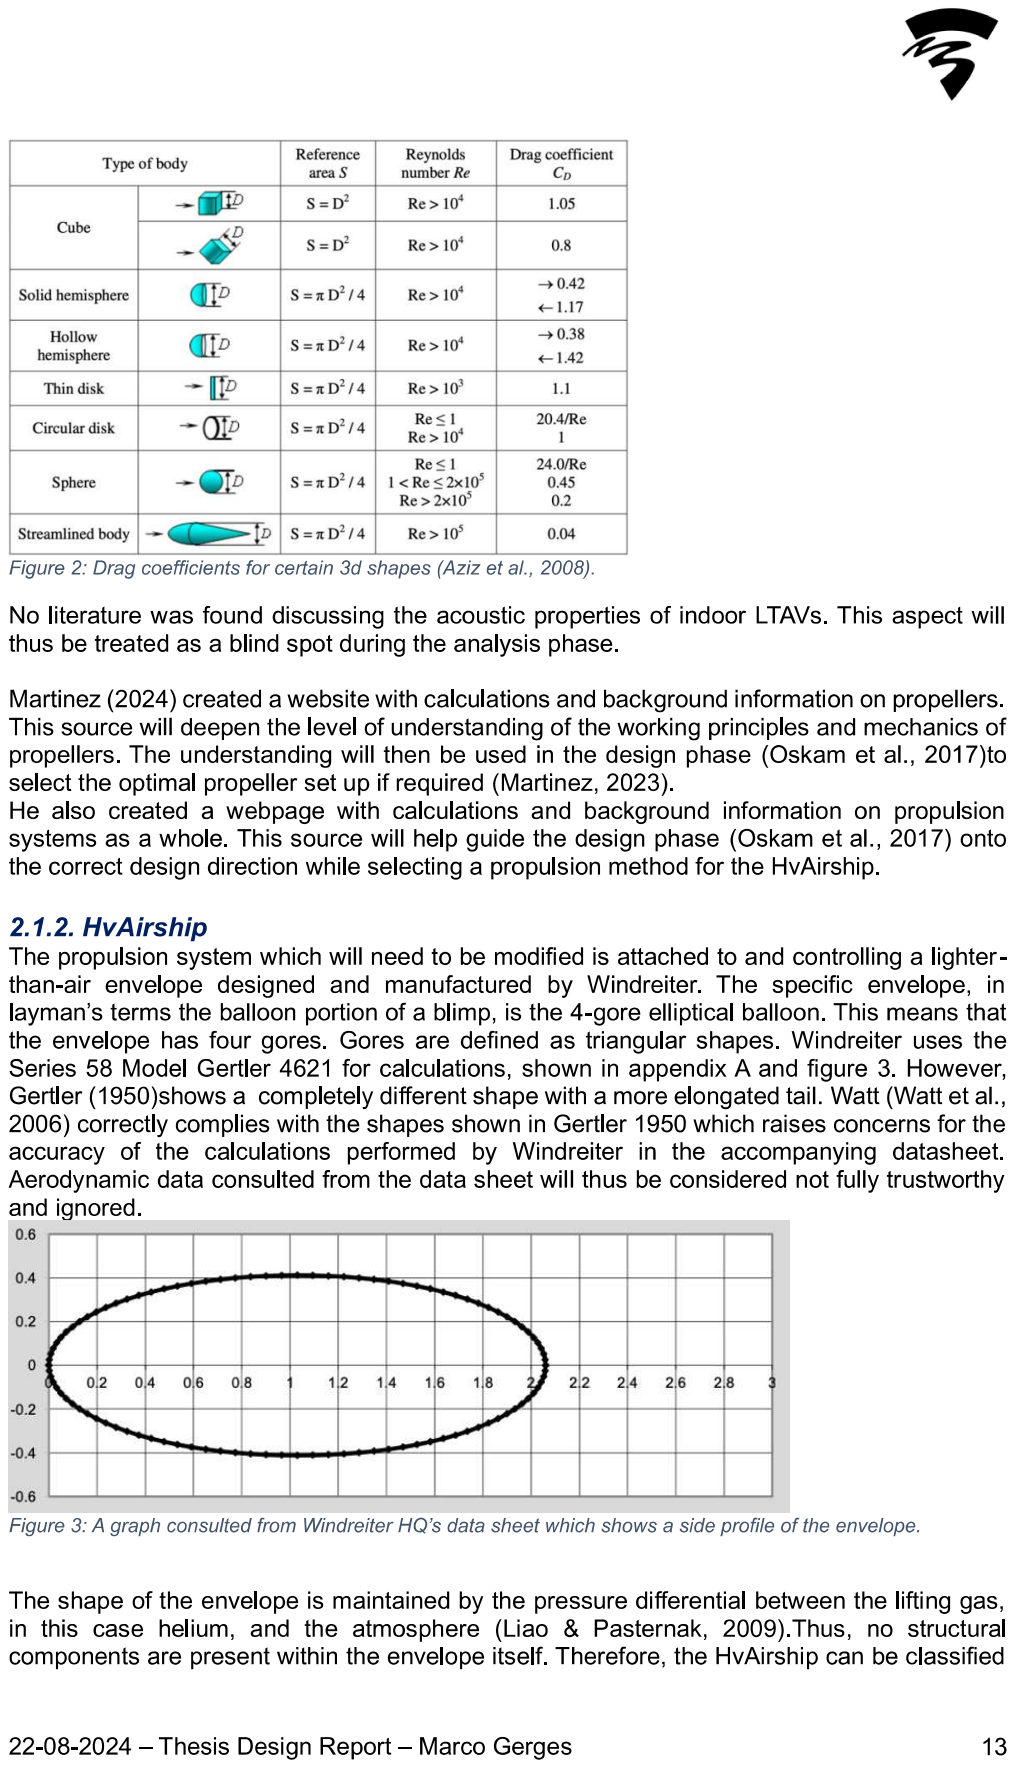
[picture p99: page 14]

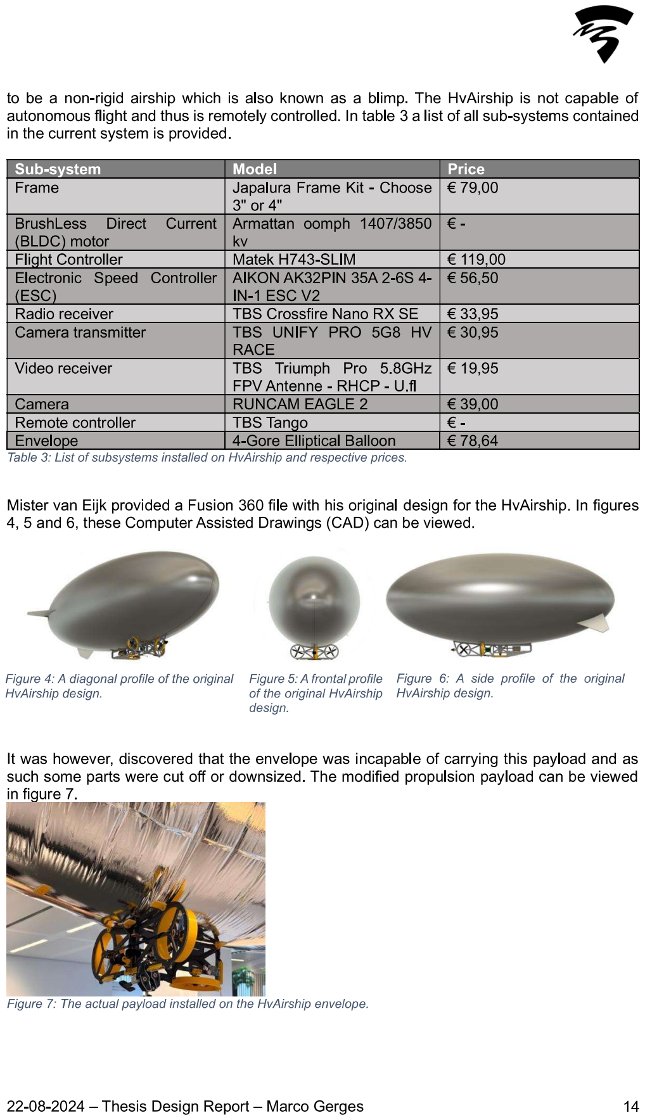
[picture p100: page 15]

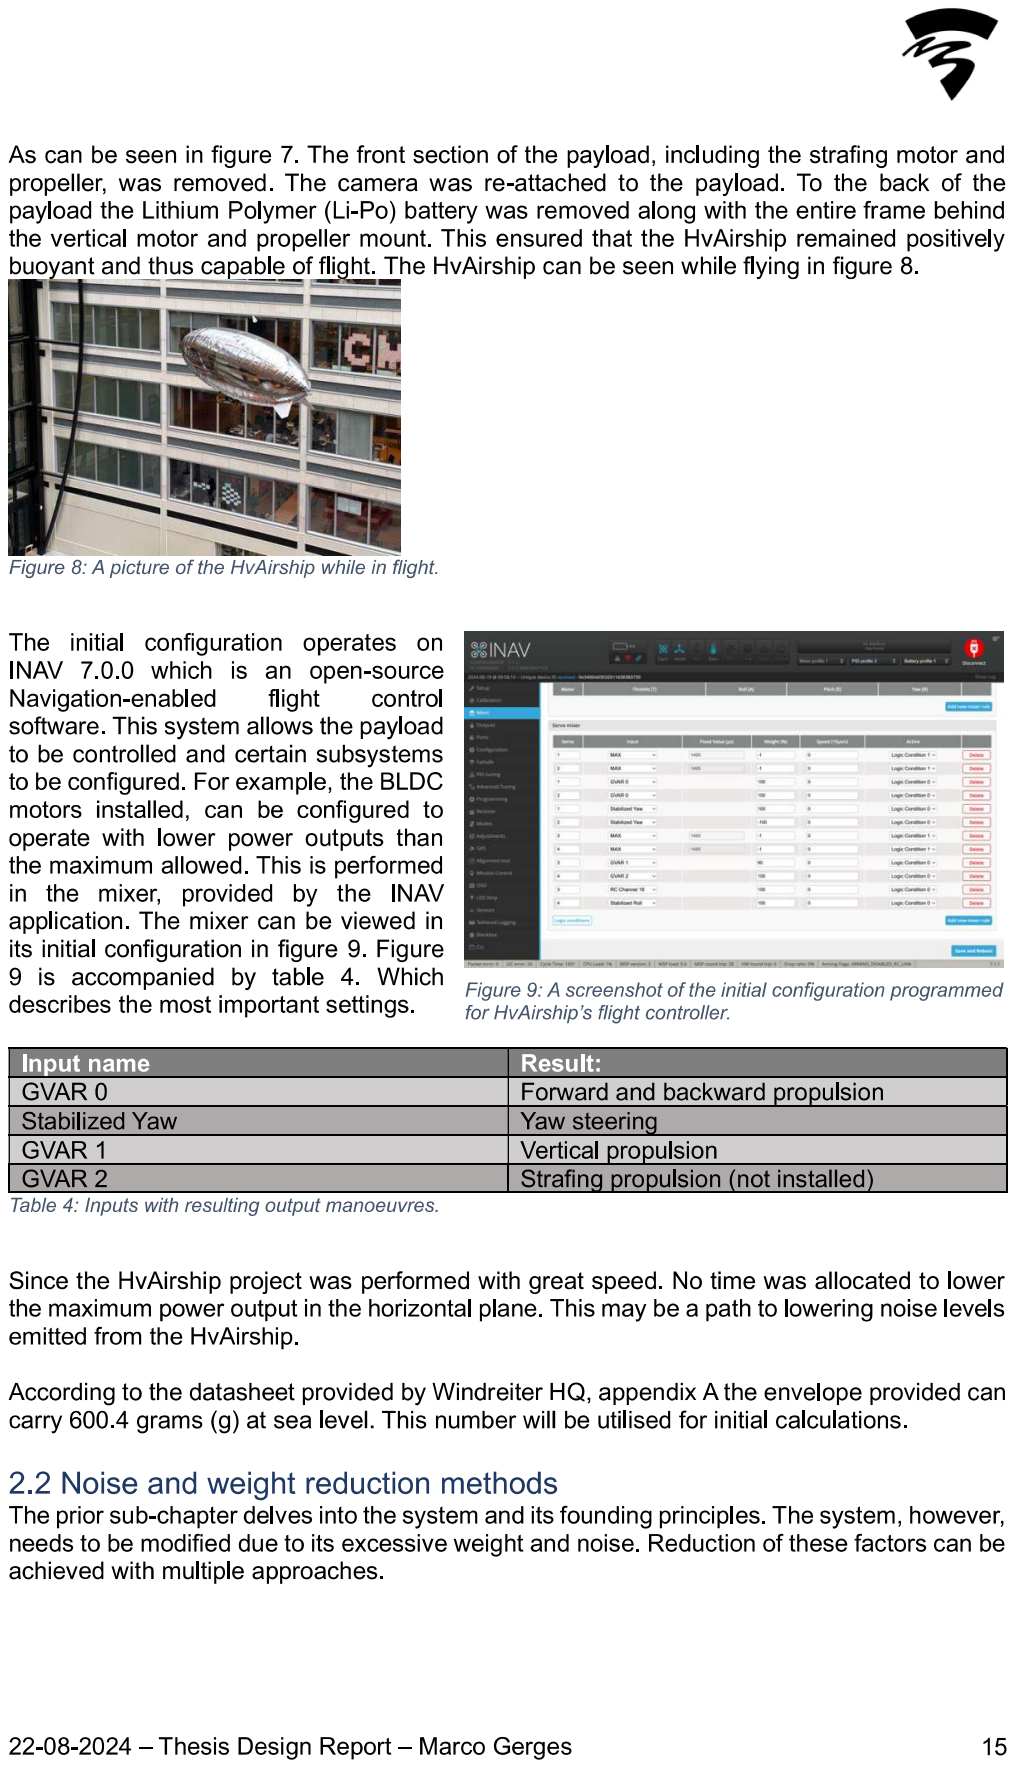
[picture p101: page 16]

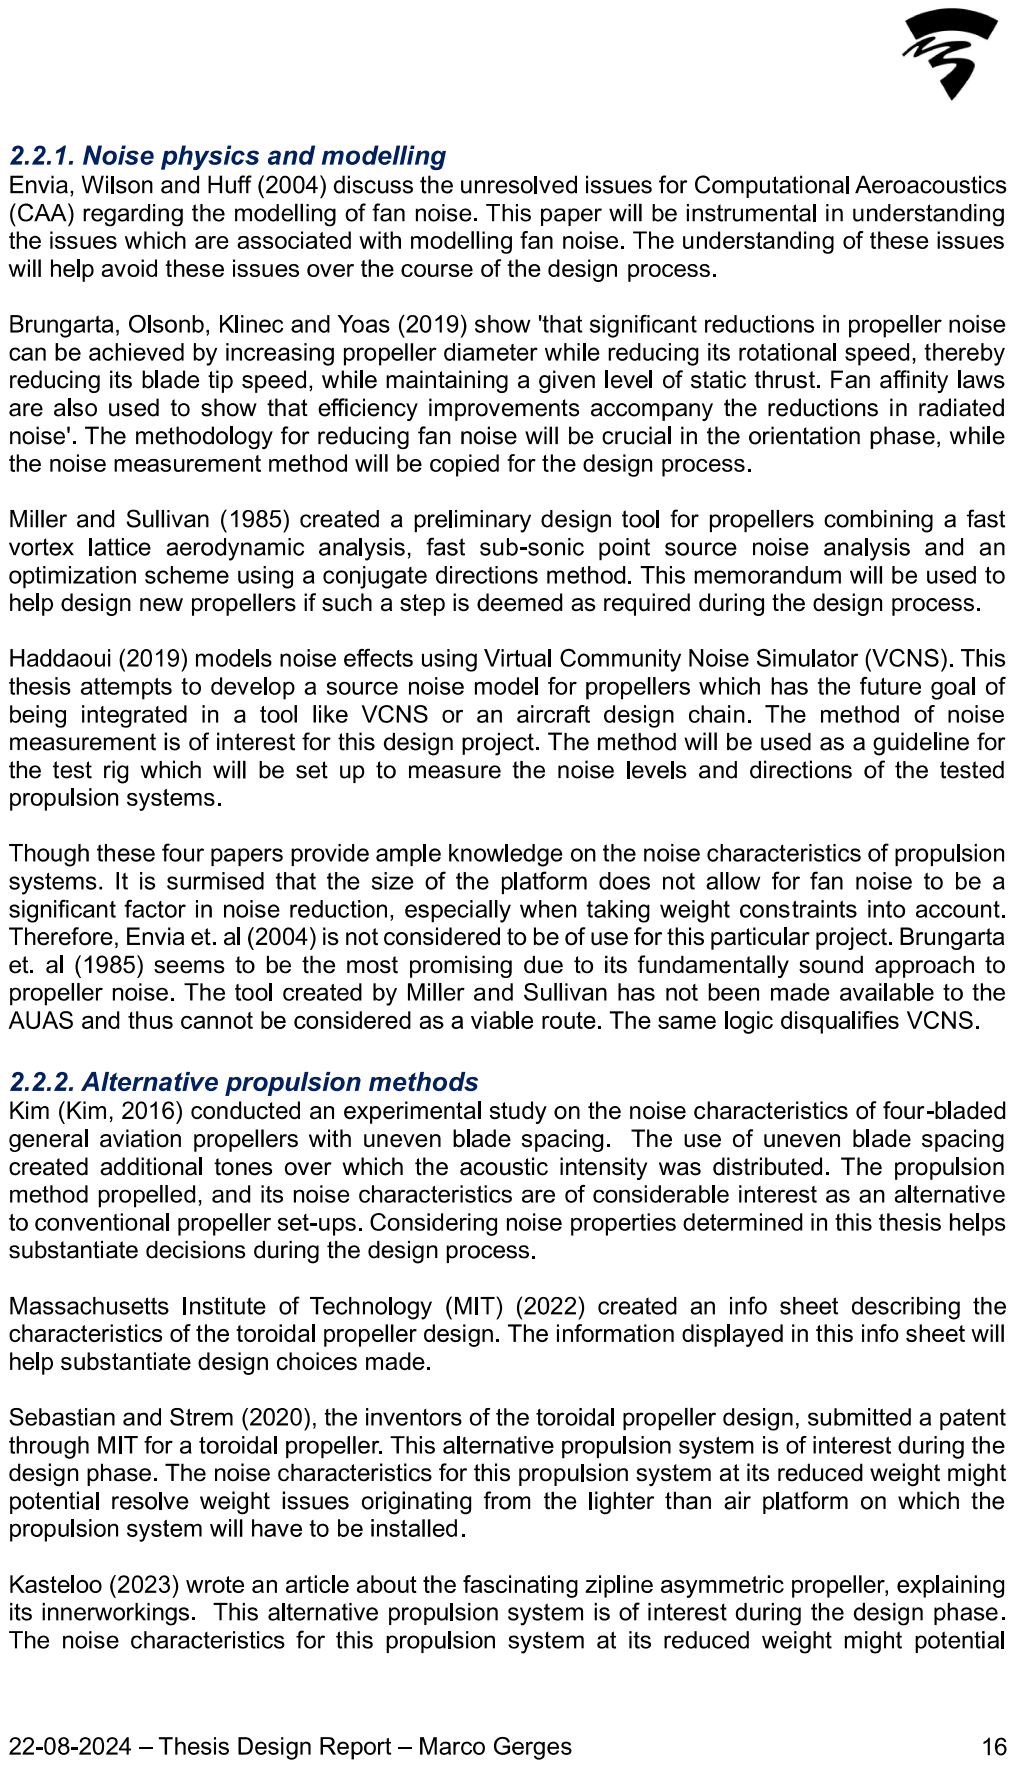
[picture p102: page 17]

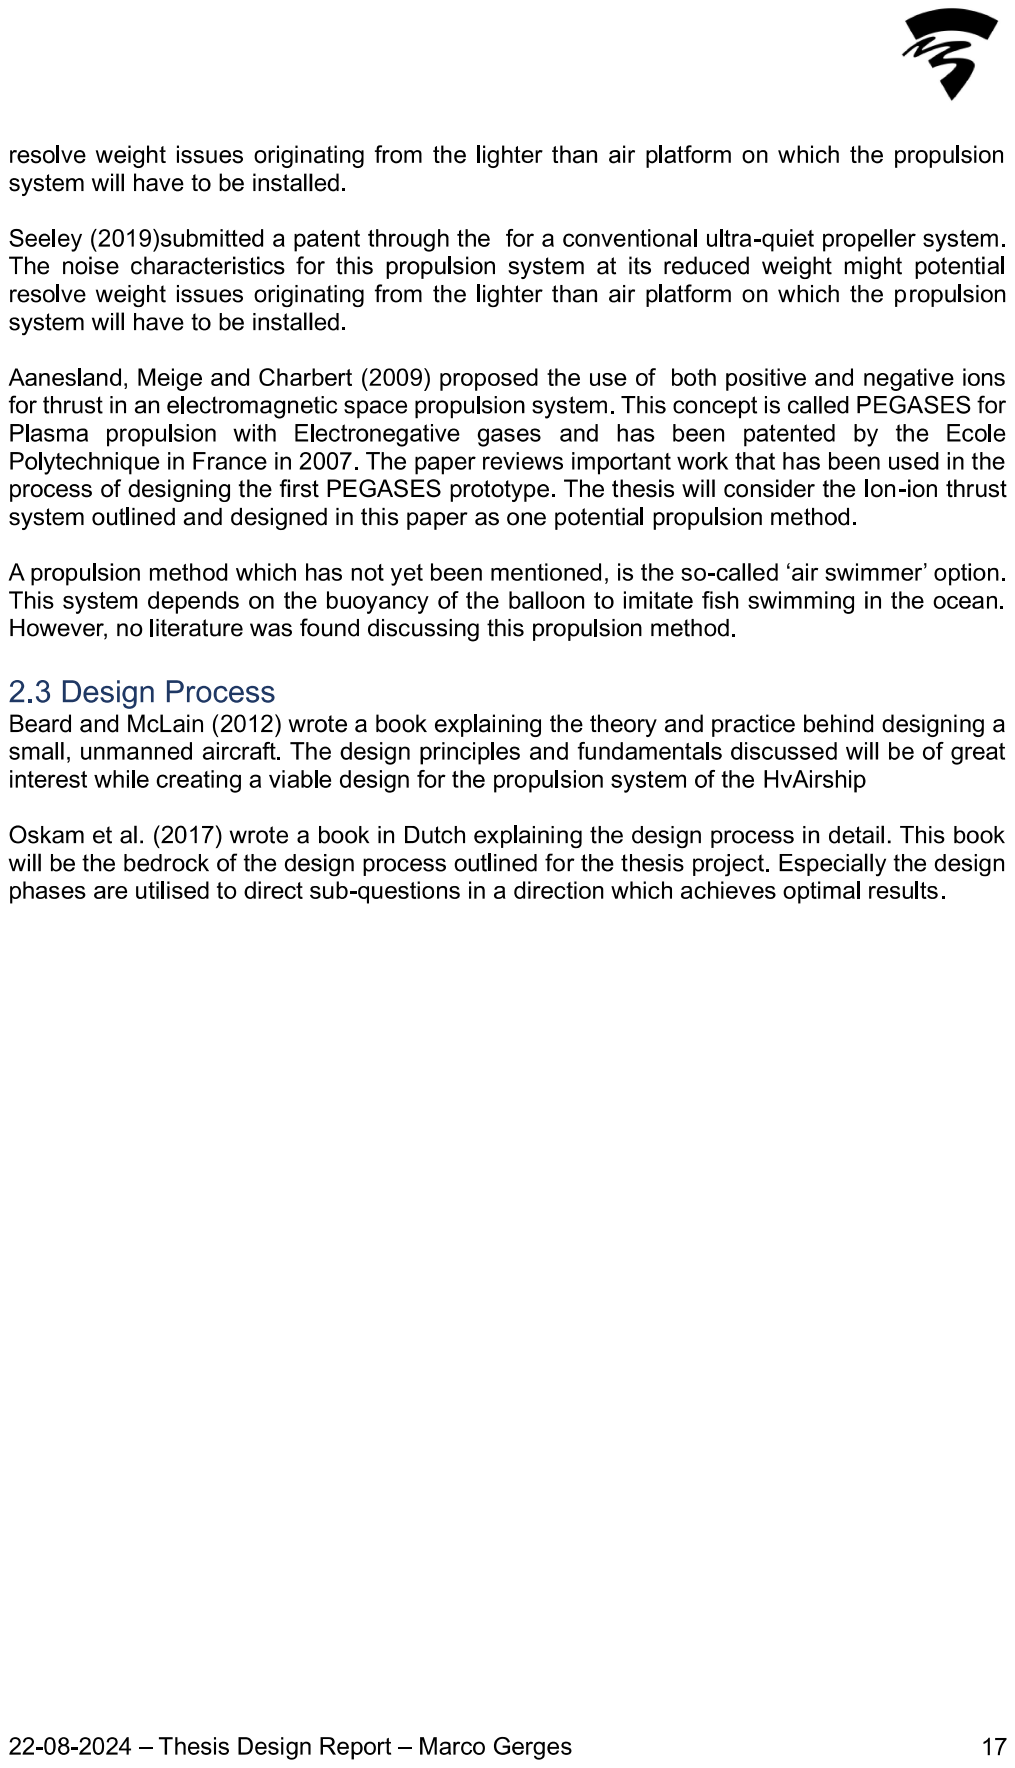
[picture p103: page 18]

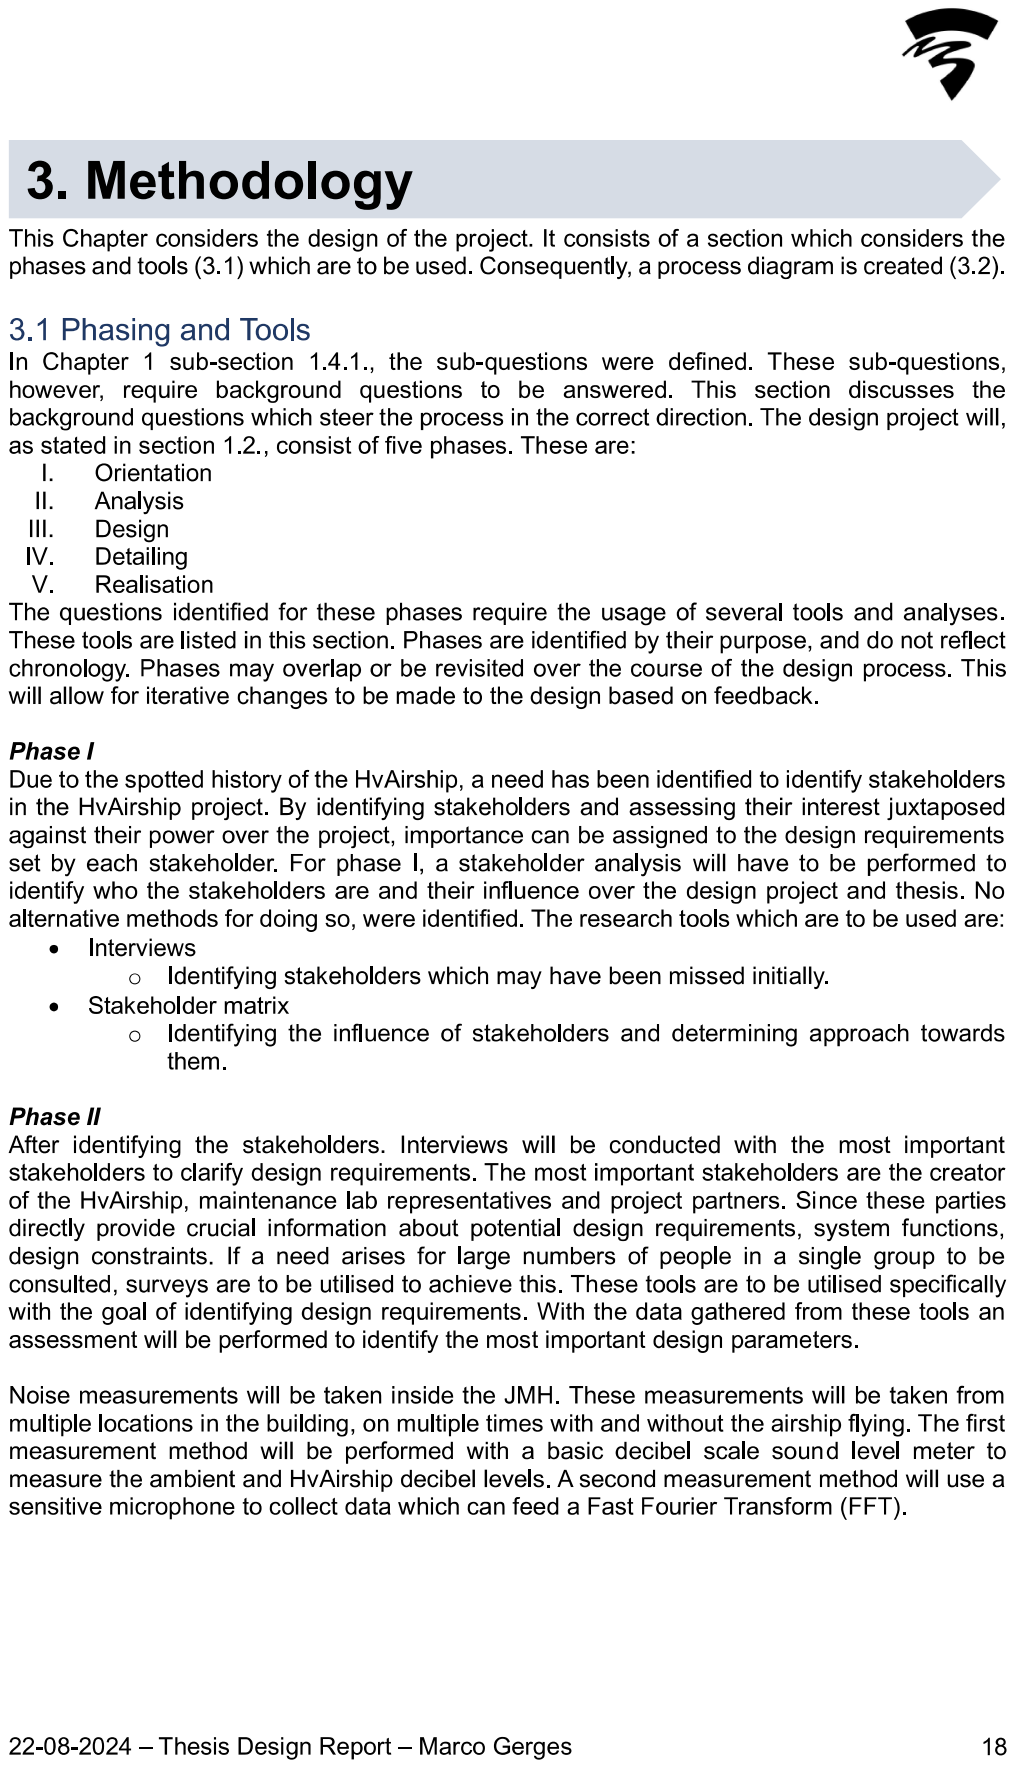
[picture p104: page 19]

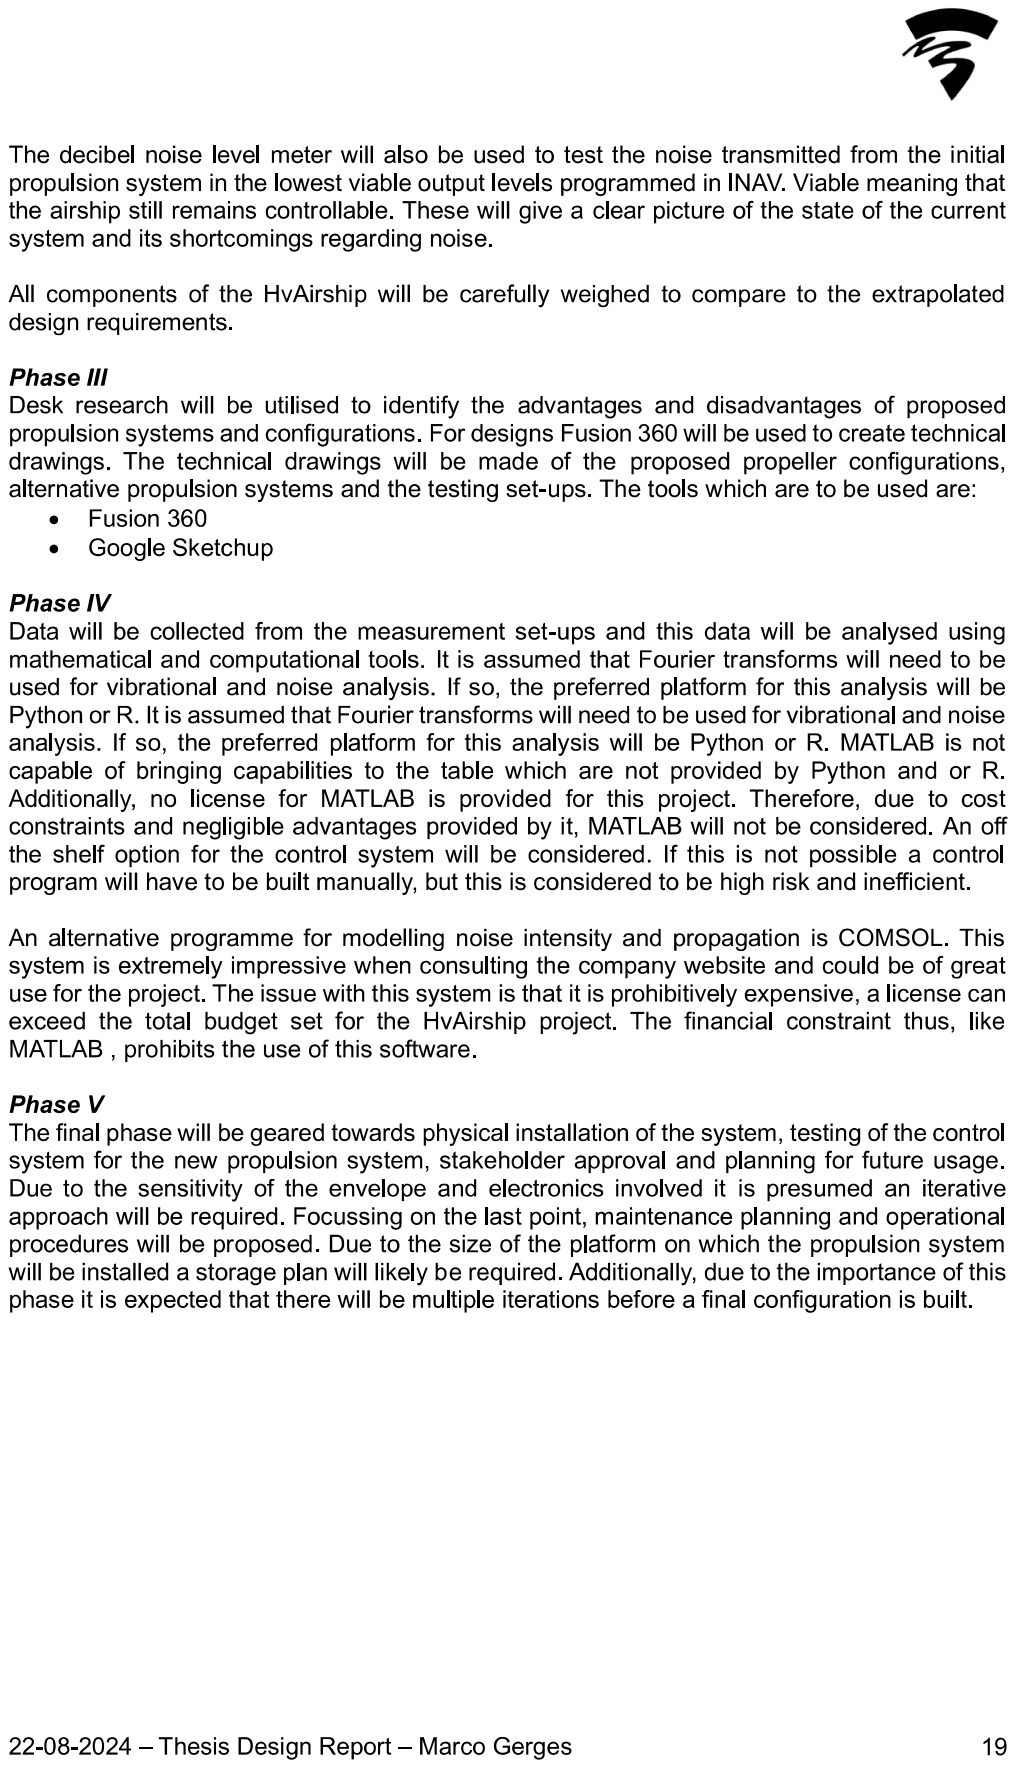
[picture p105: page 20]

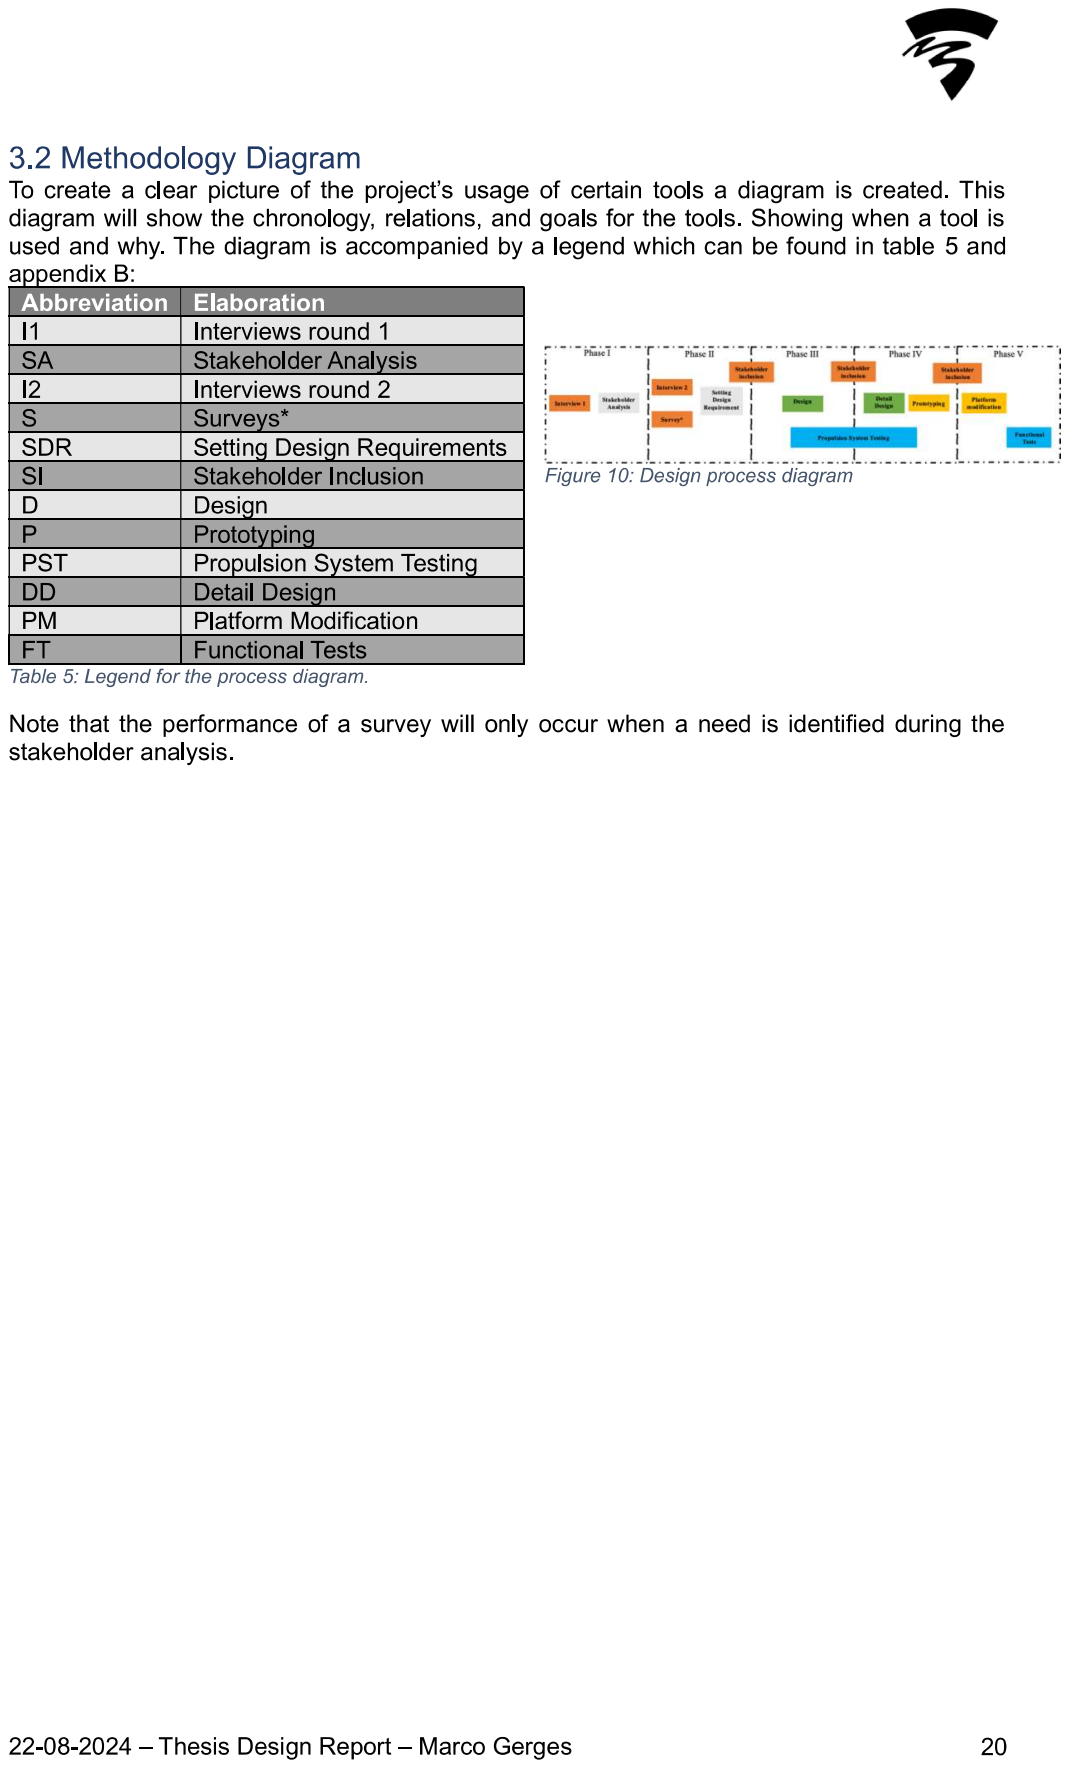
[picture p106: page 21]

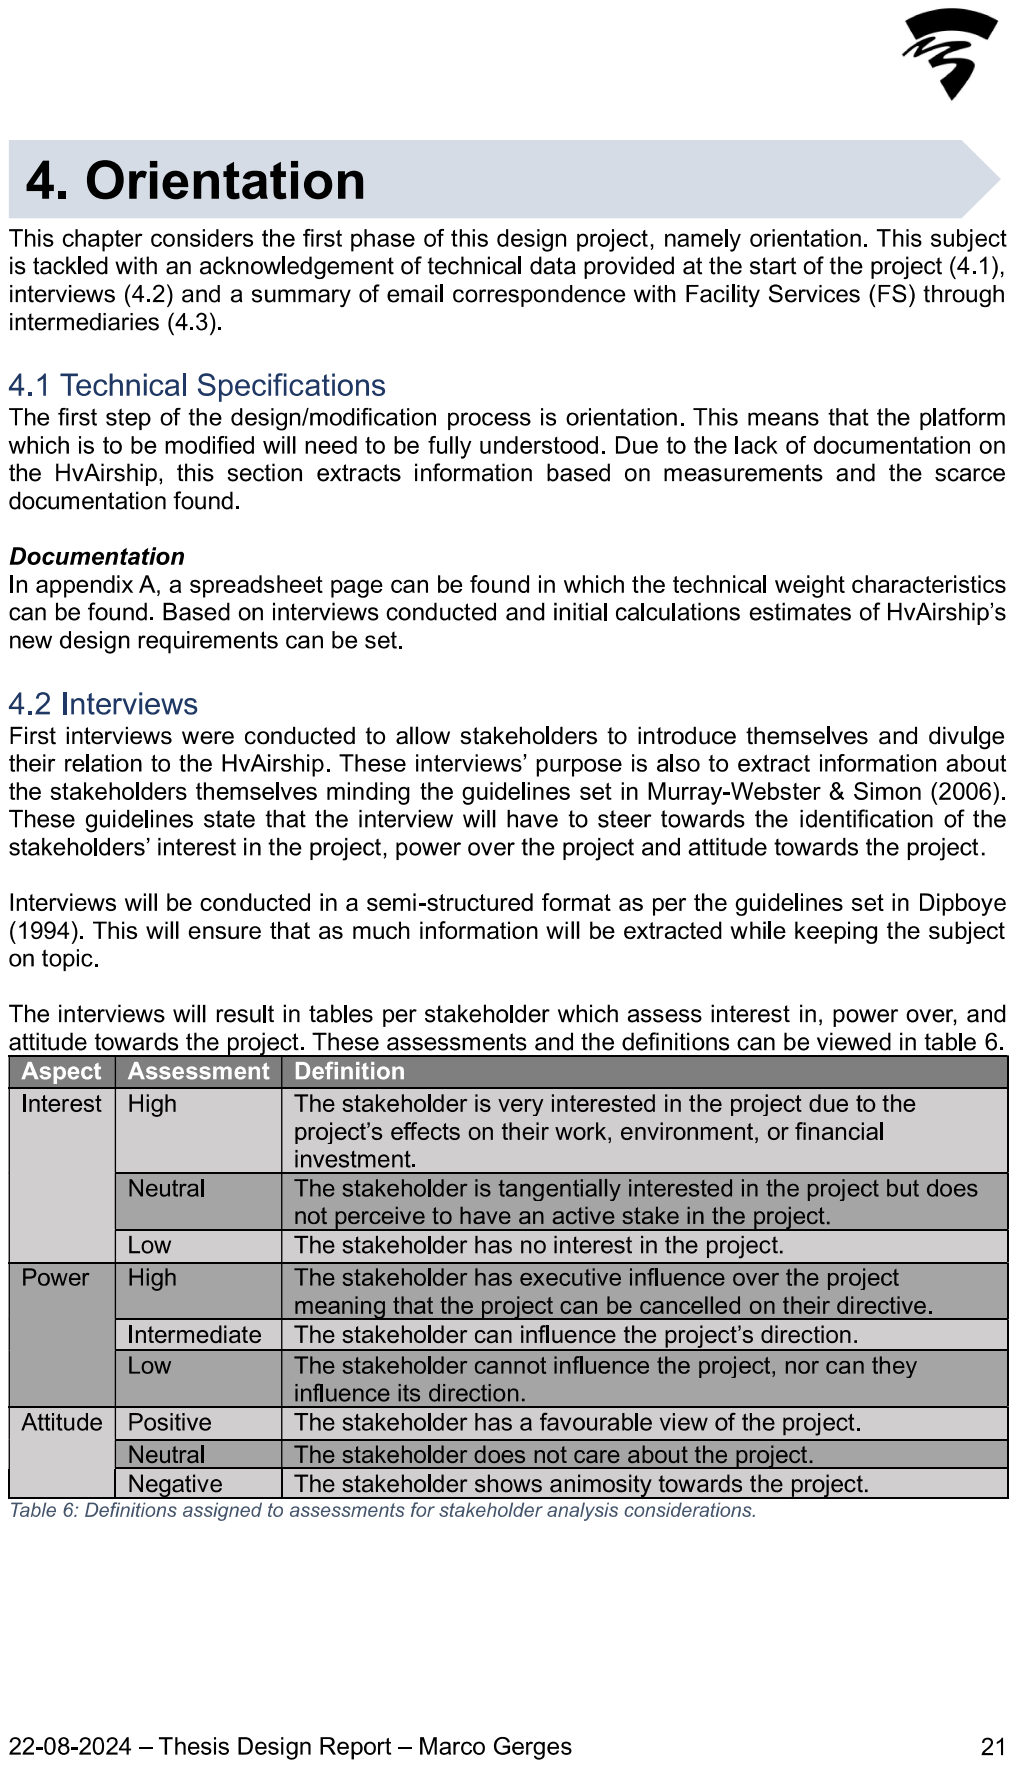
[picture p107: page 22]

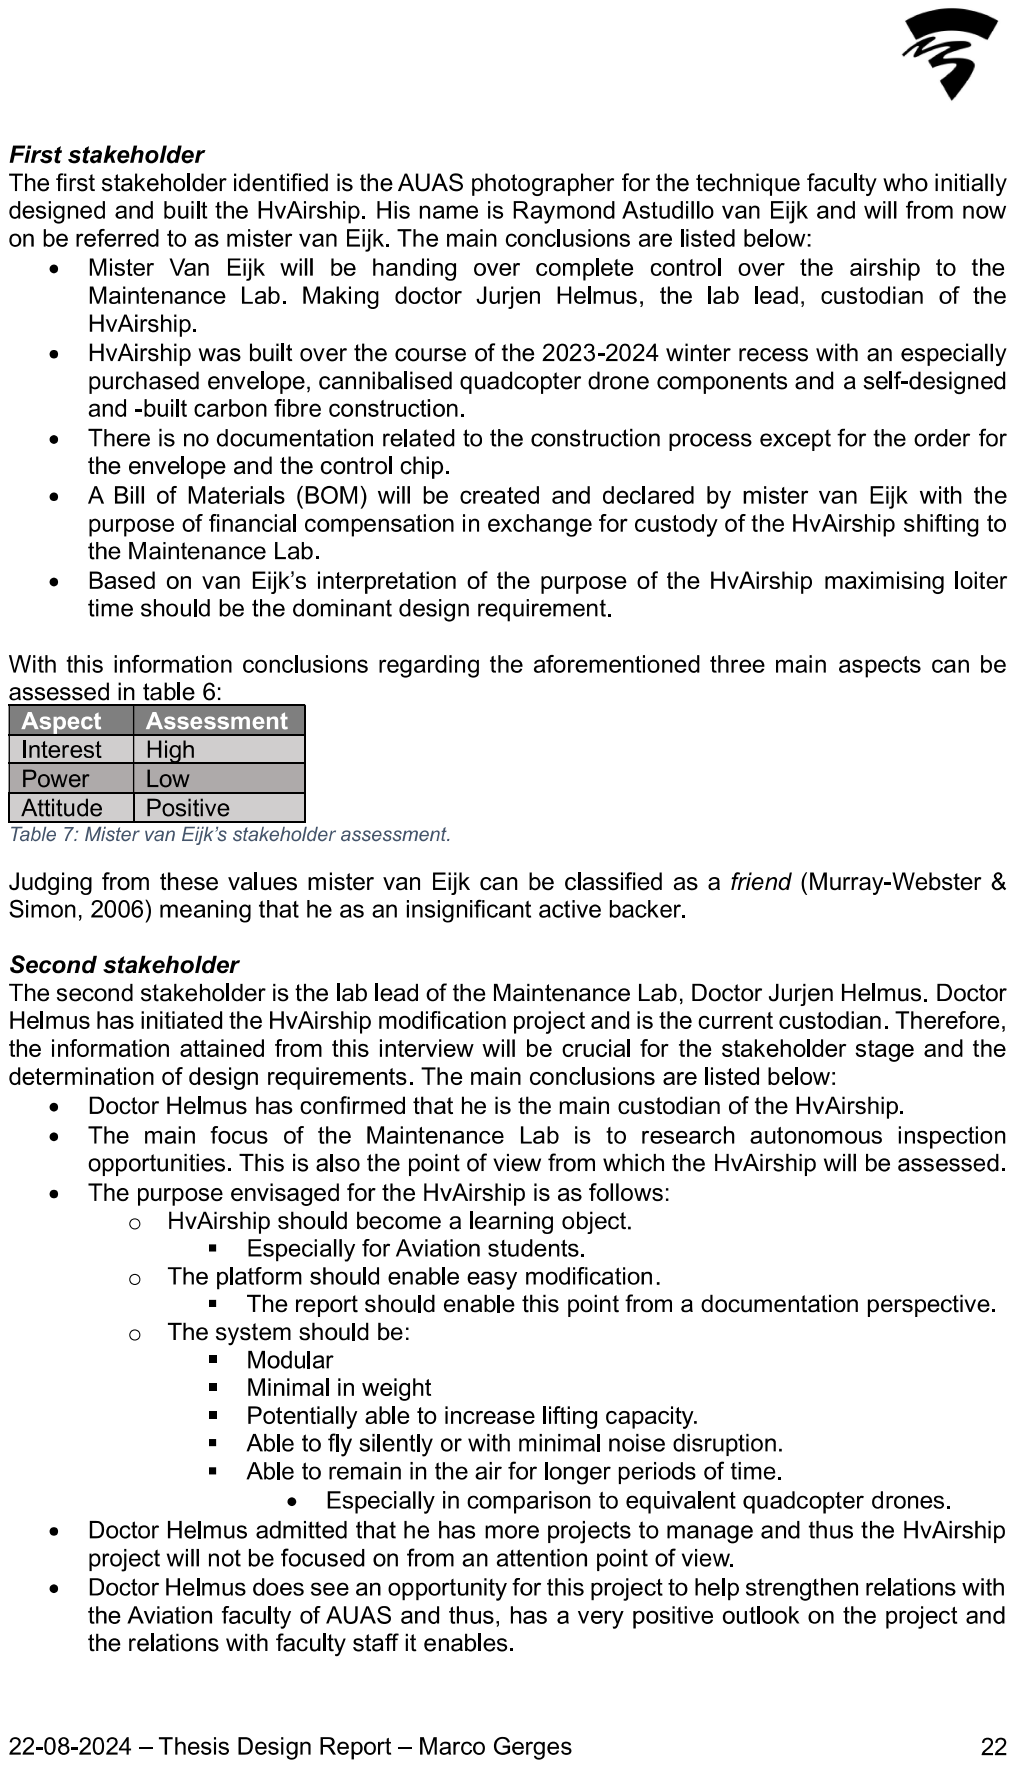
[picture p108: page 23]

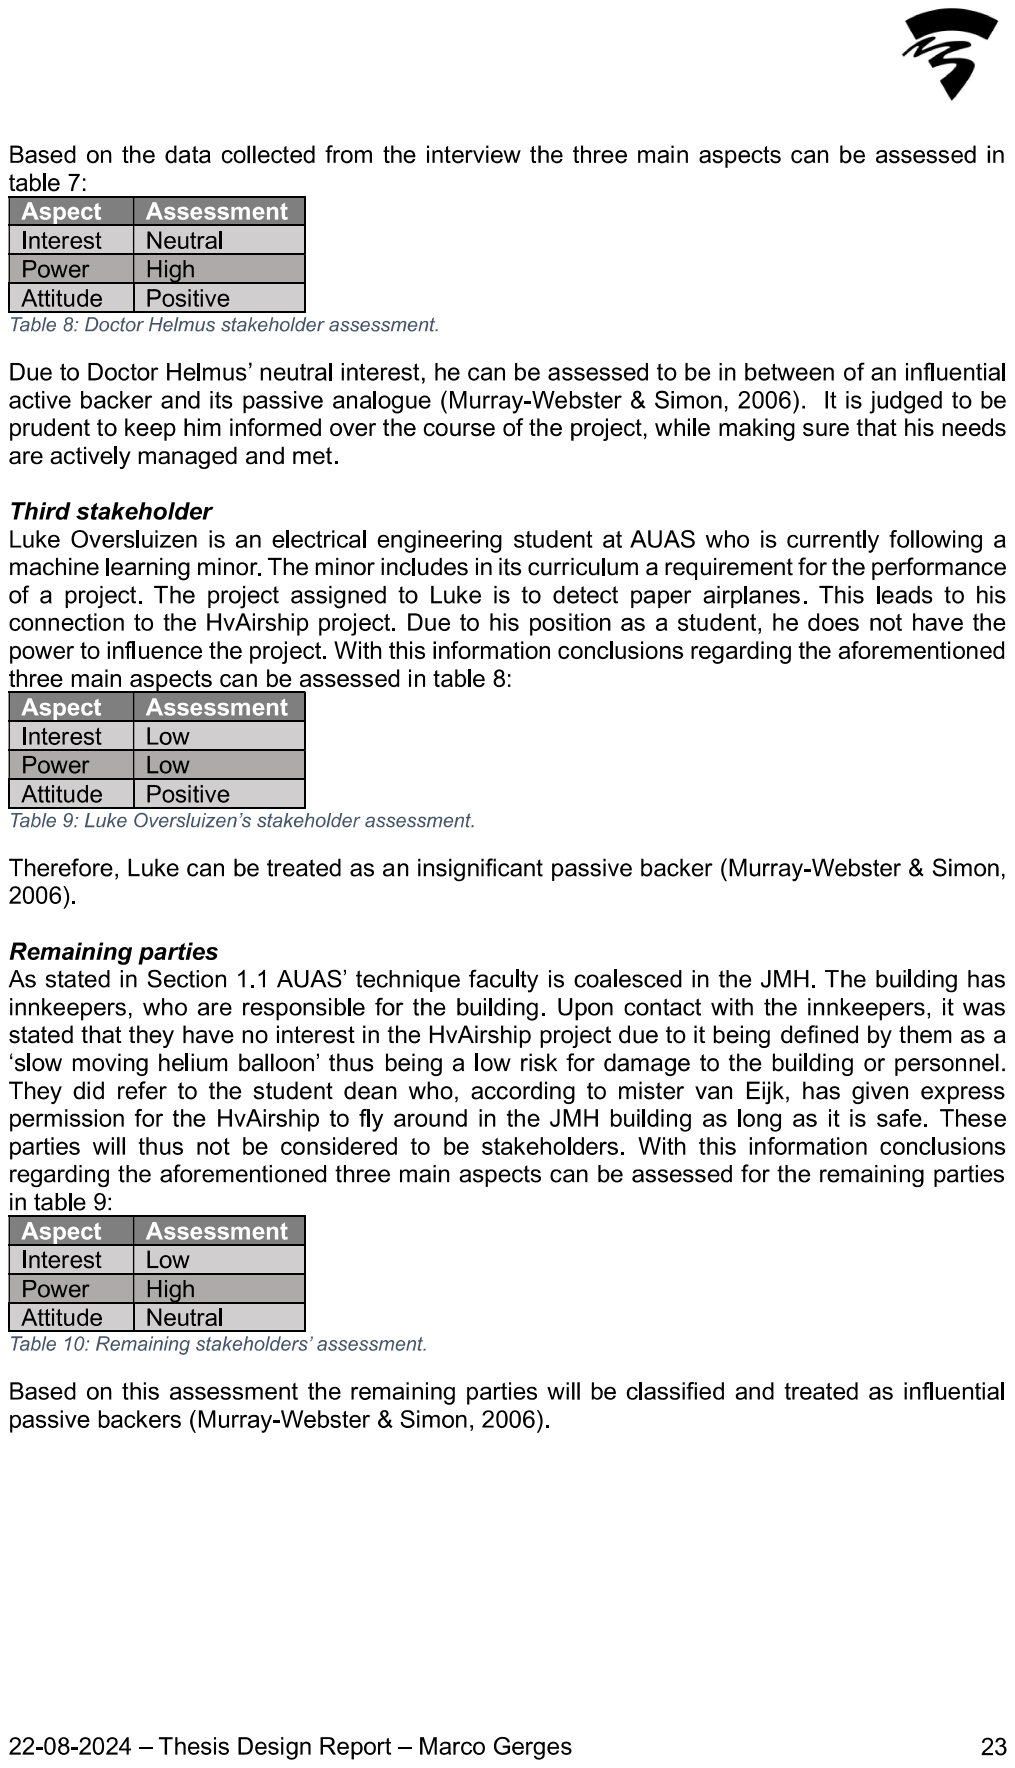
[picture p109: page 24]

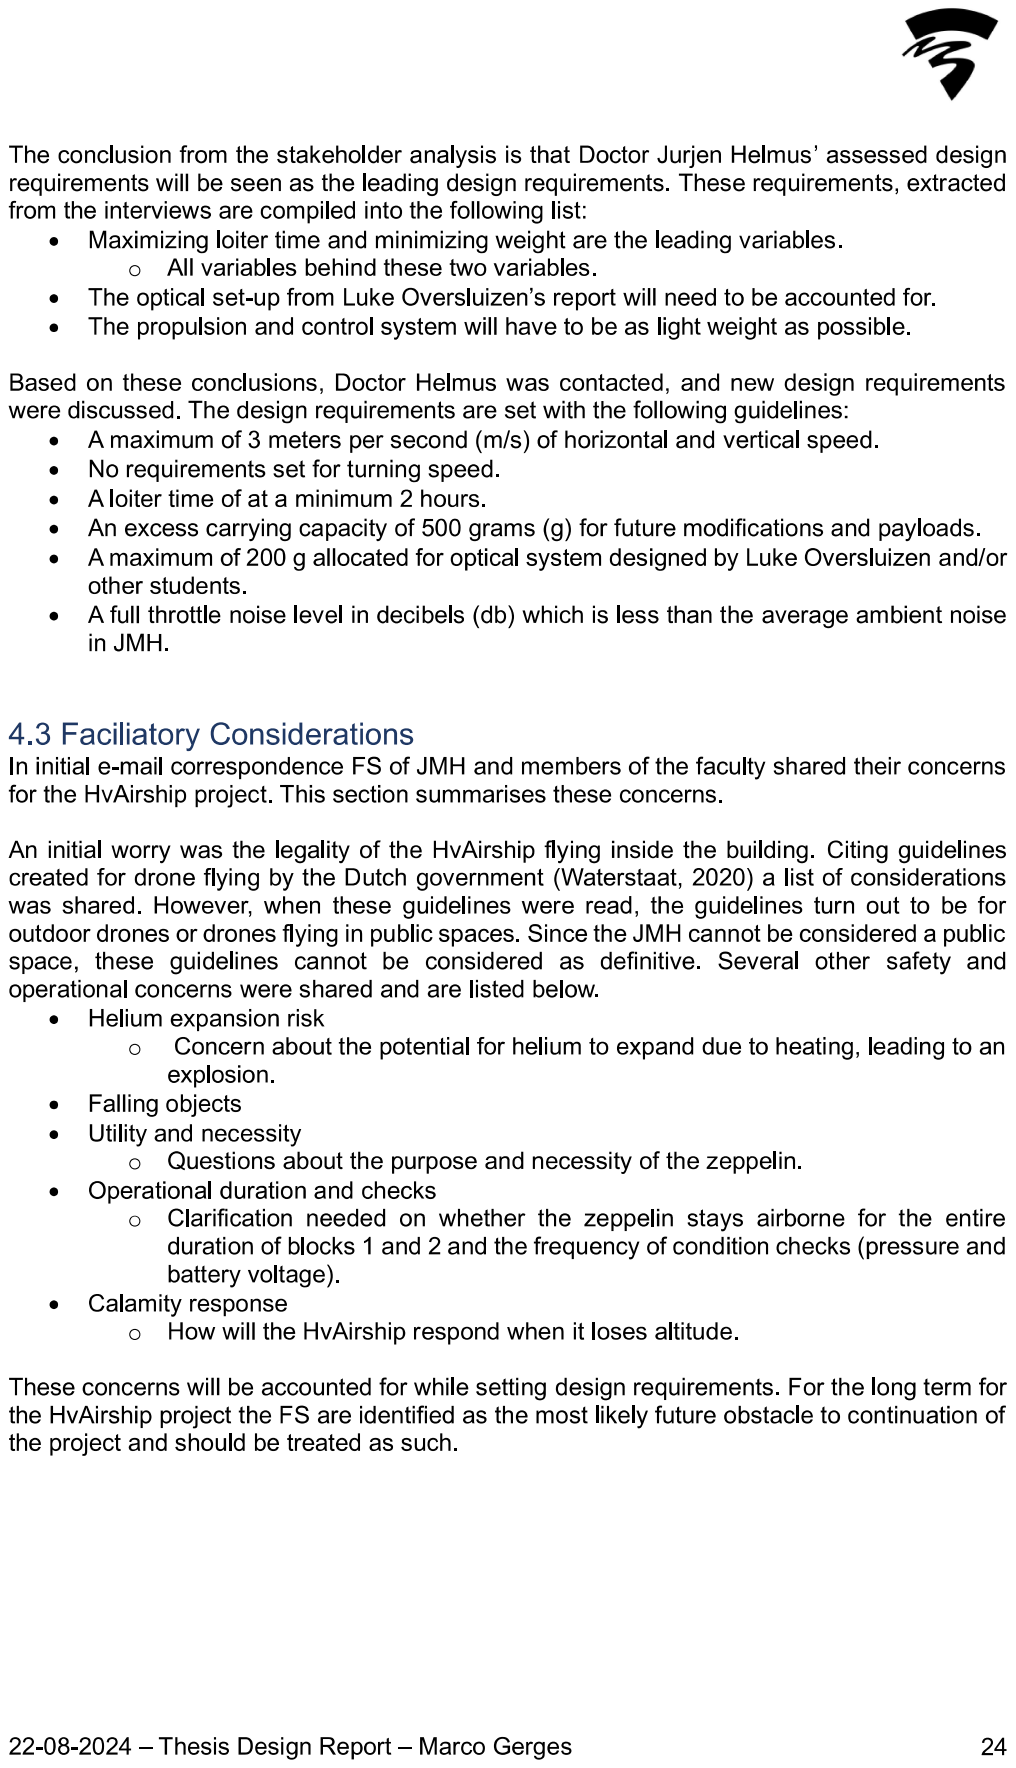
[picture p110: page 25]

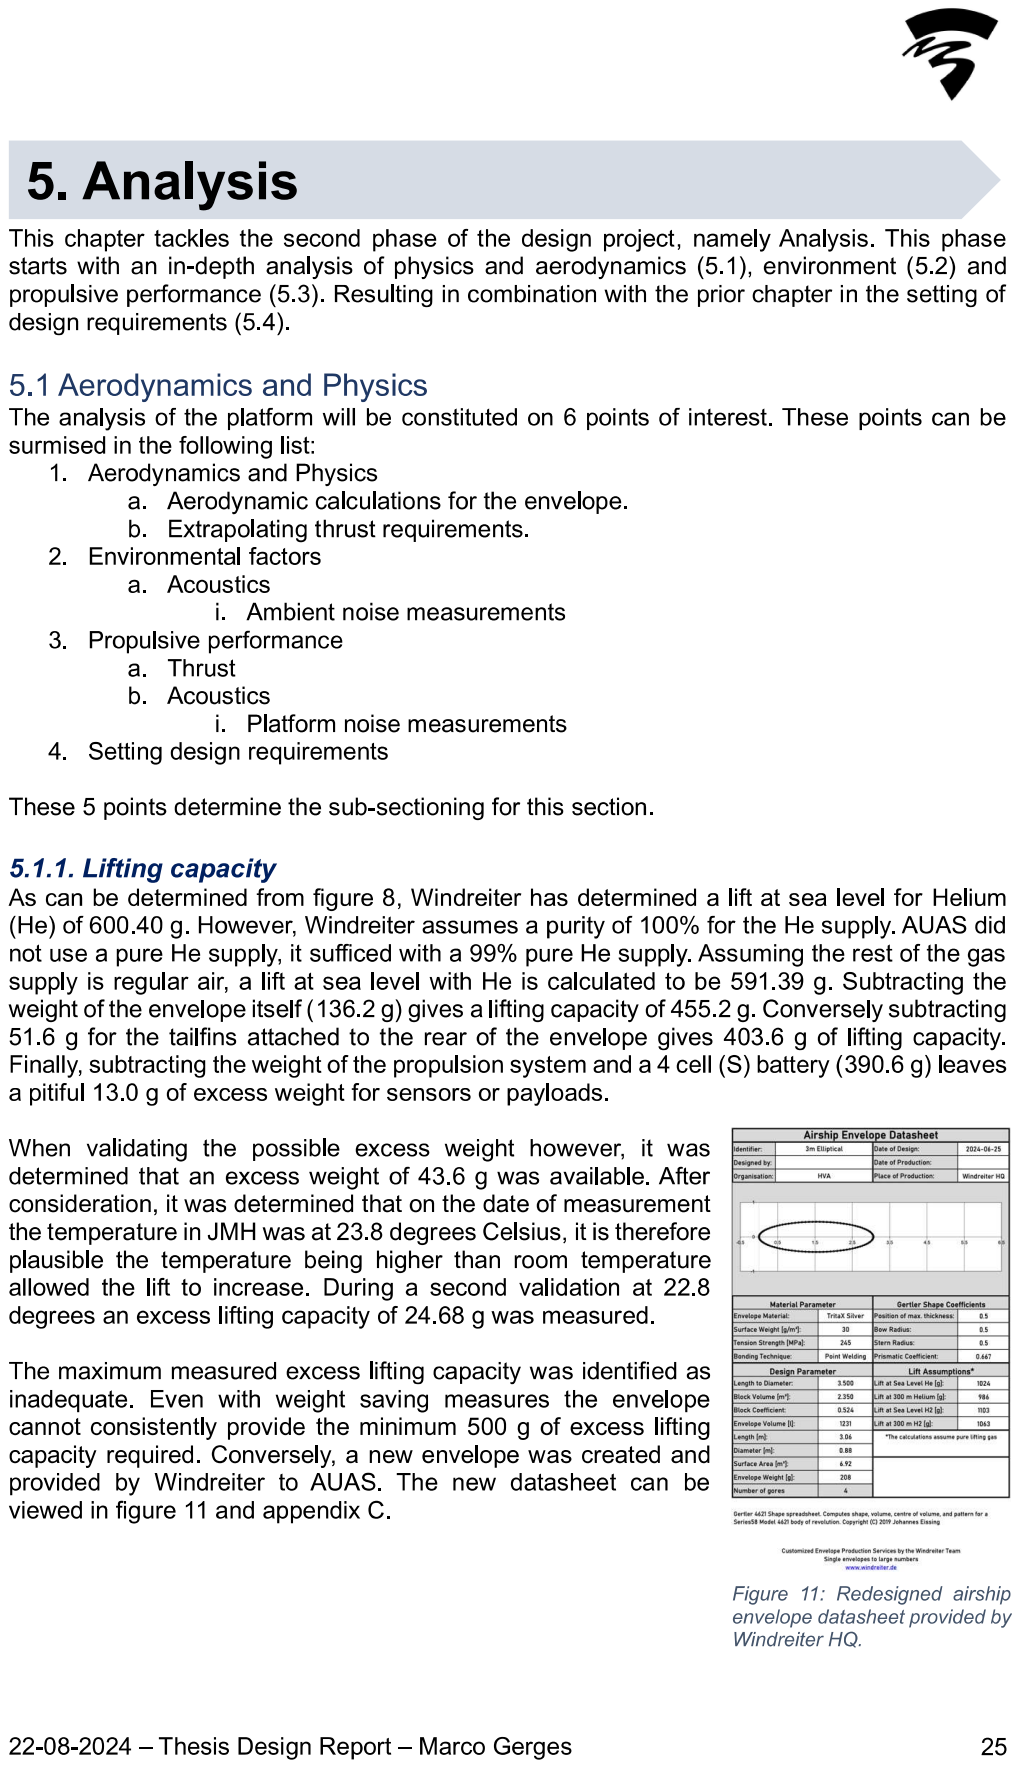
[picture p111: page 26]

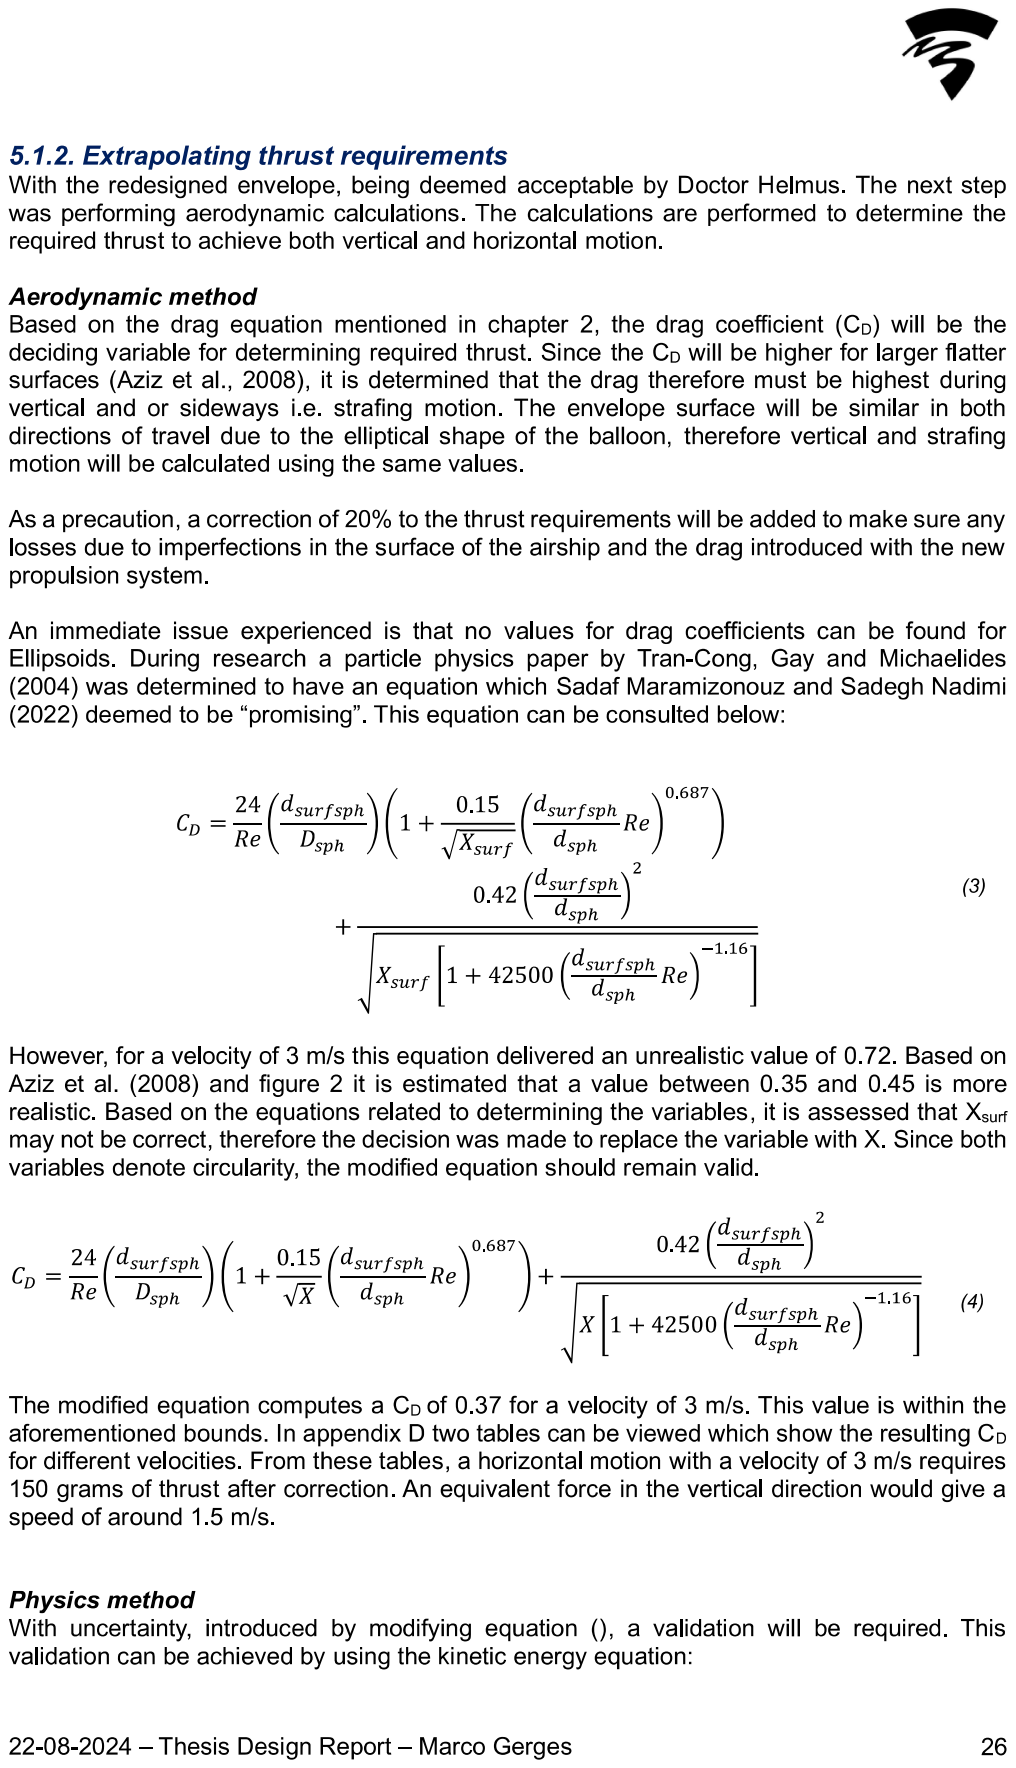
[picture p112: page 27]

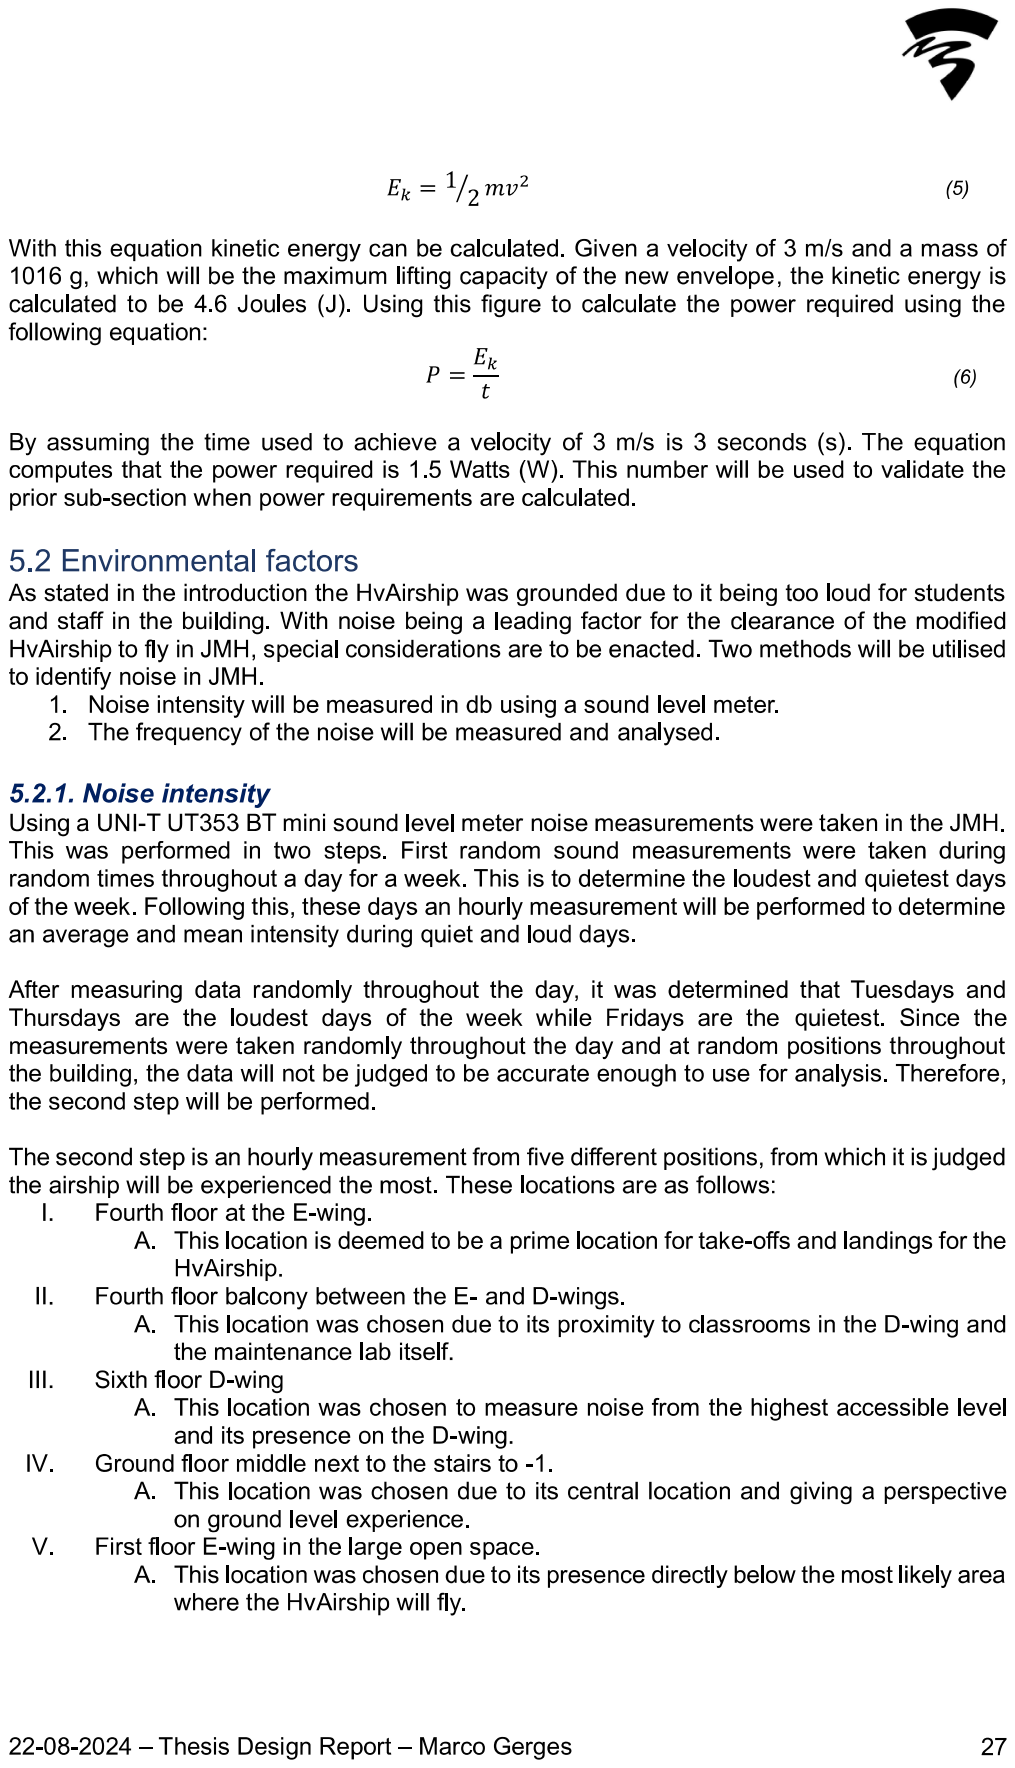
[picture p113: page 28]

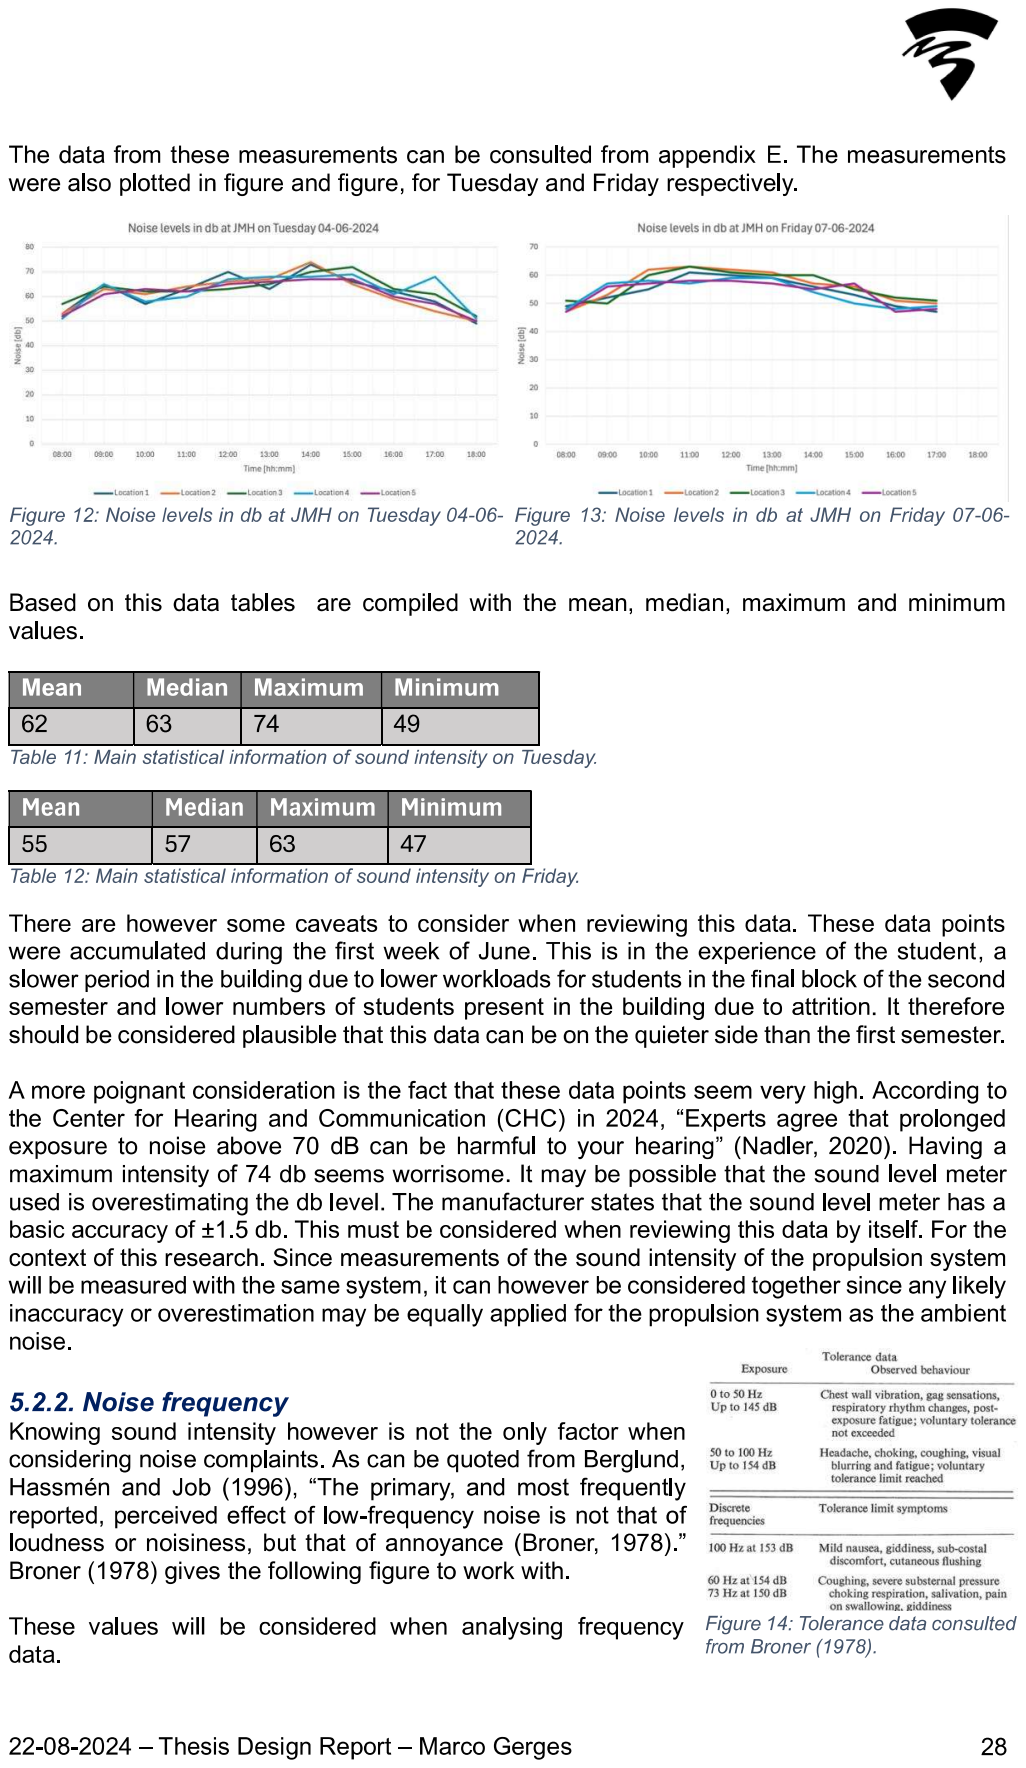
[picture p114: page 29]

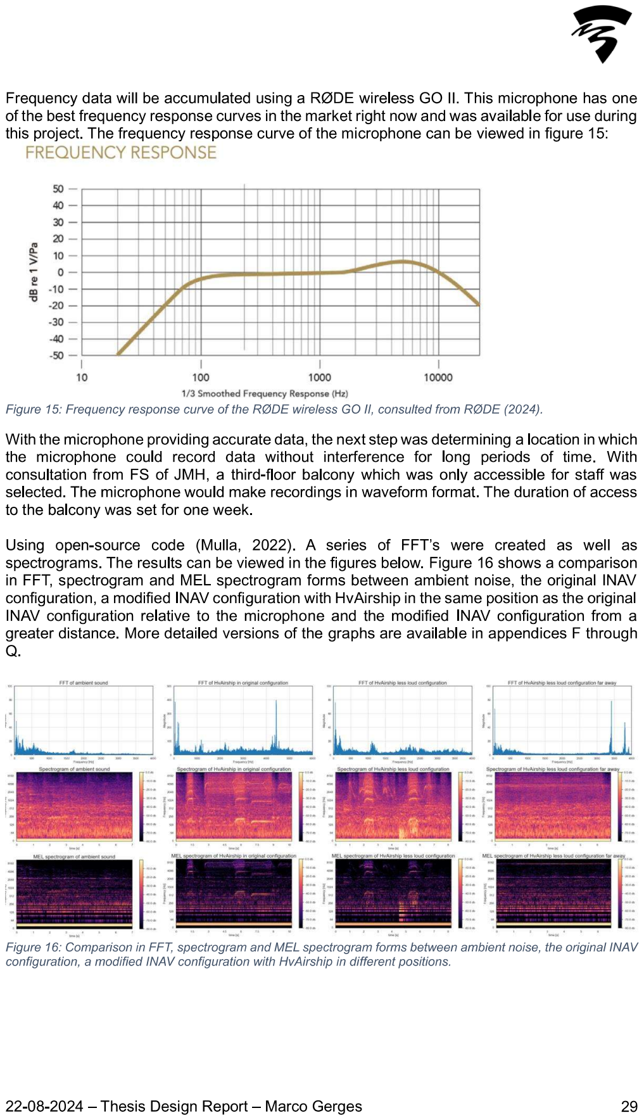
[picture p115: page 30]

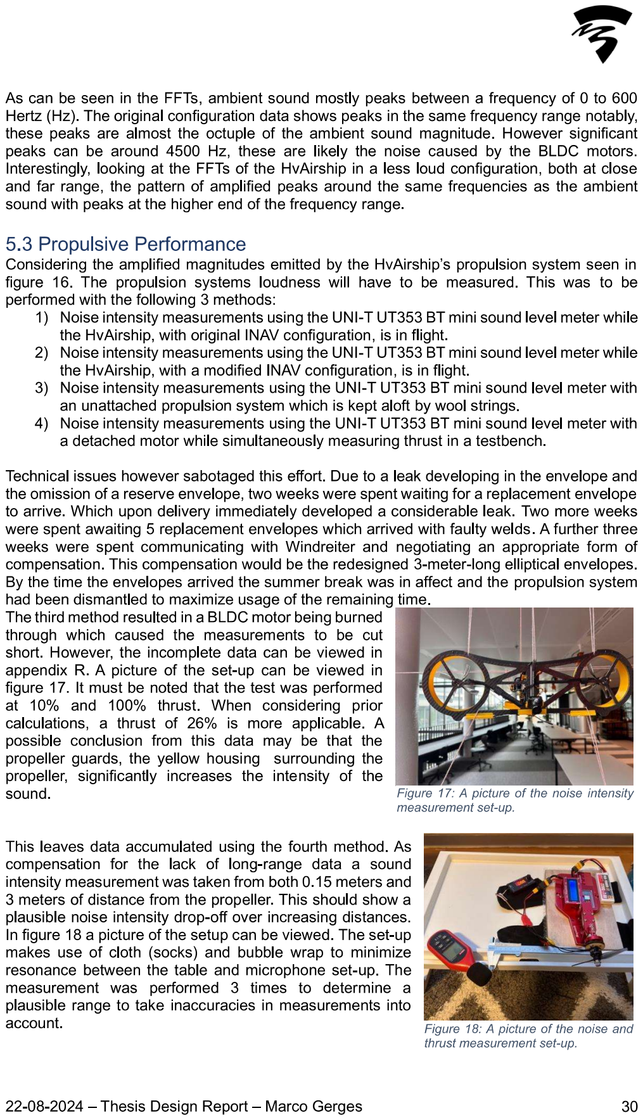
[picture p116: page 31]

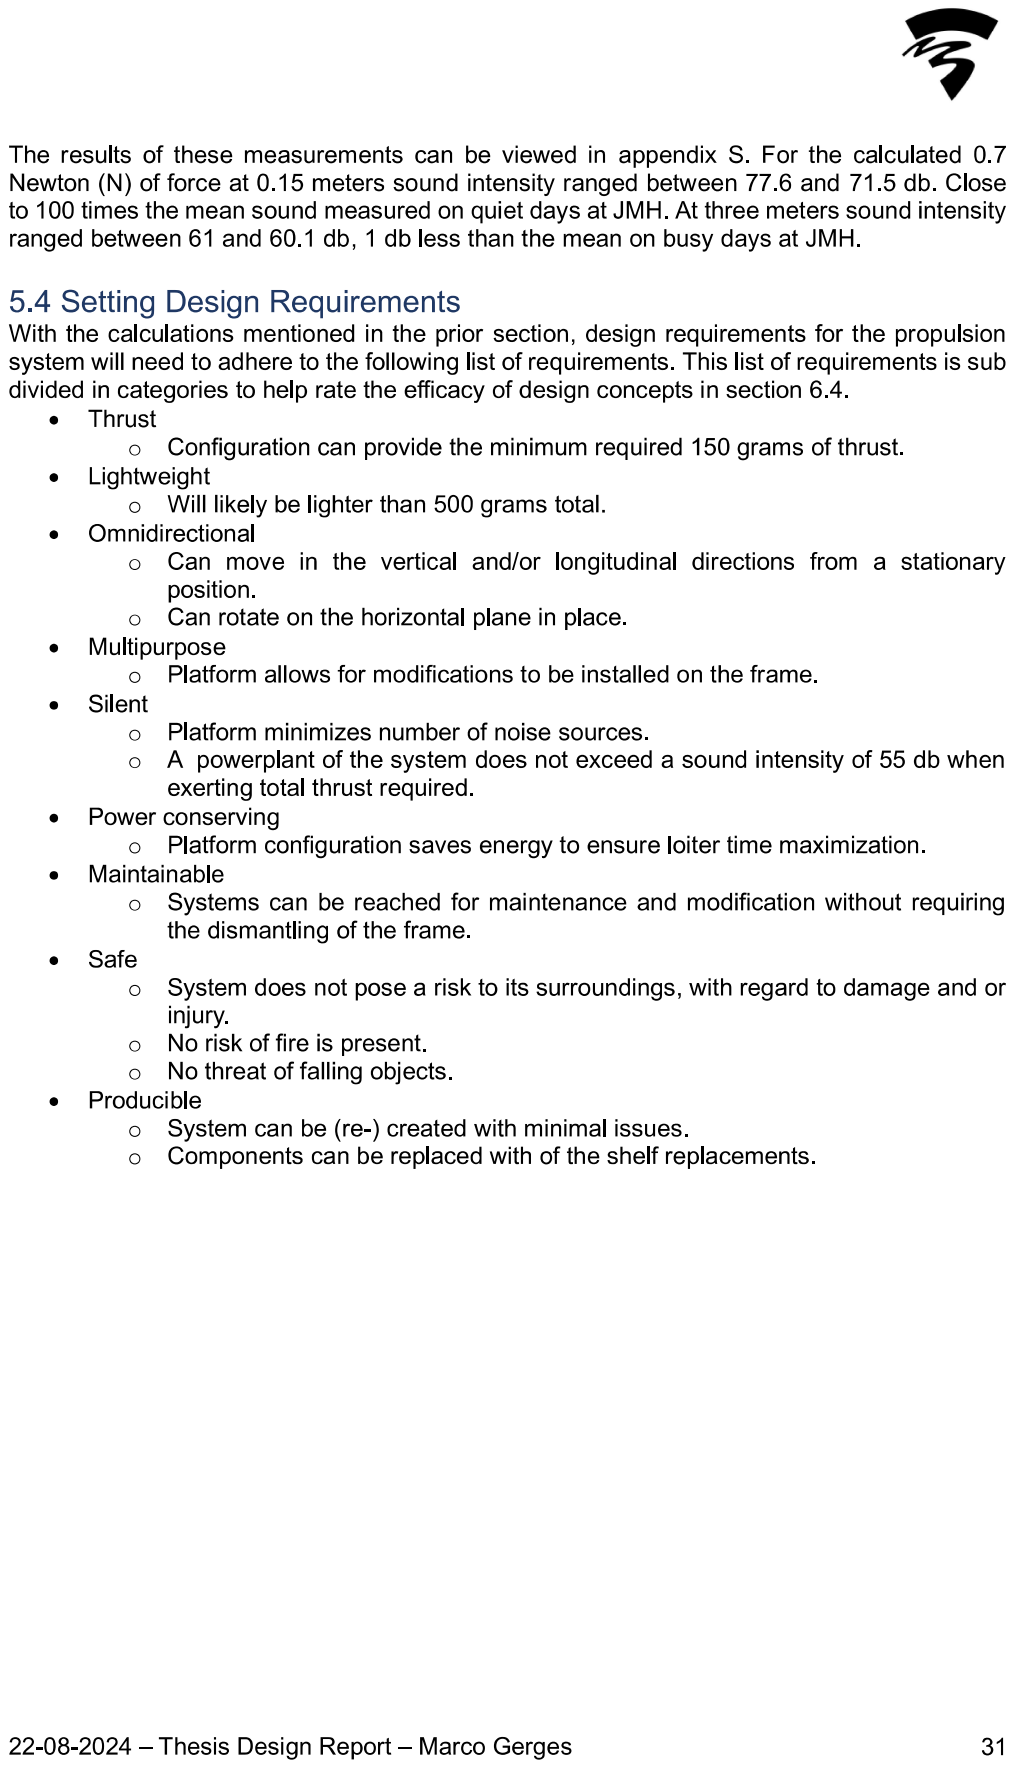
[picture p117: page 32]

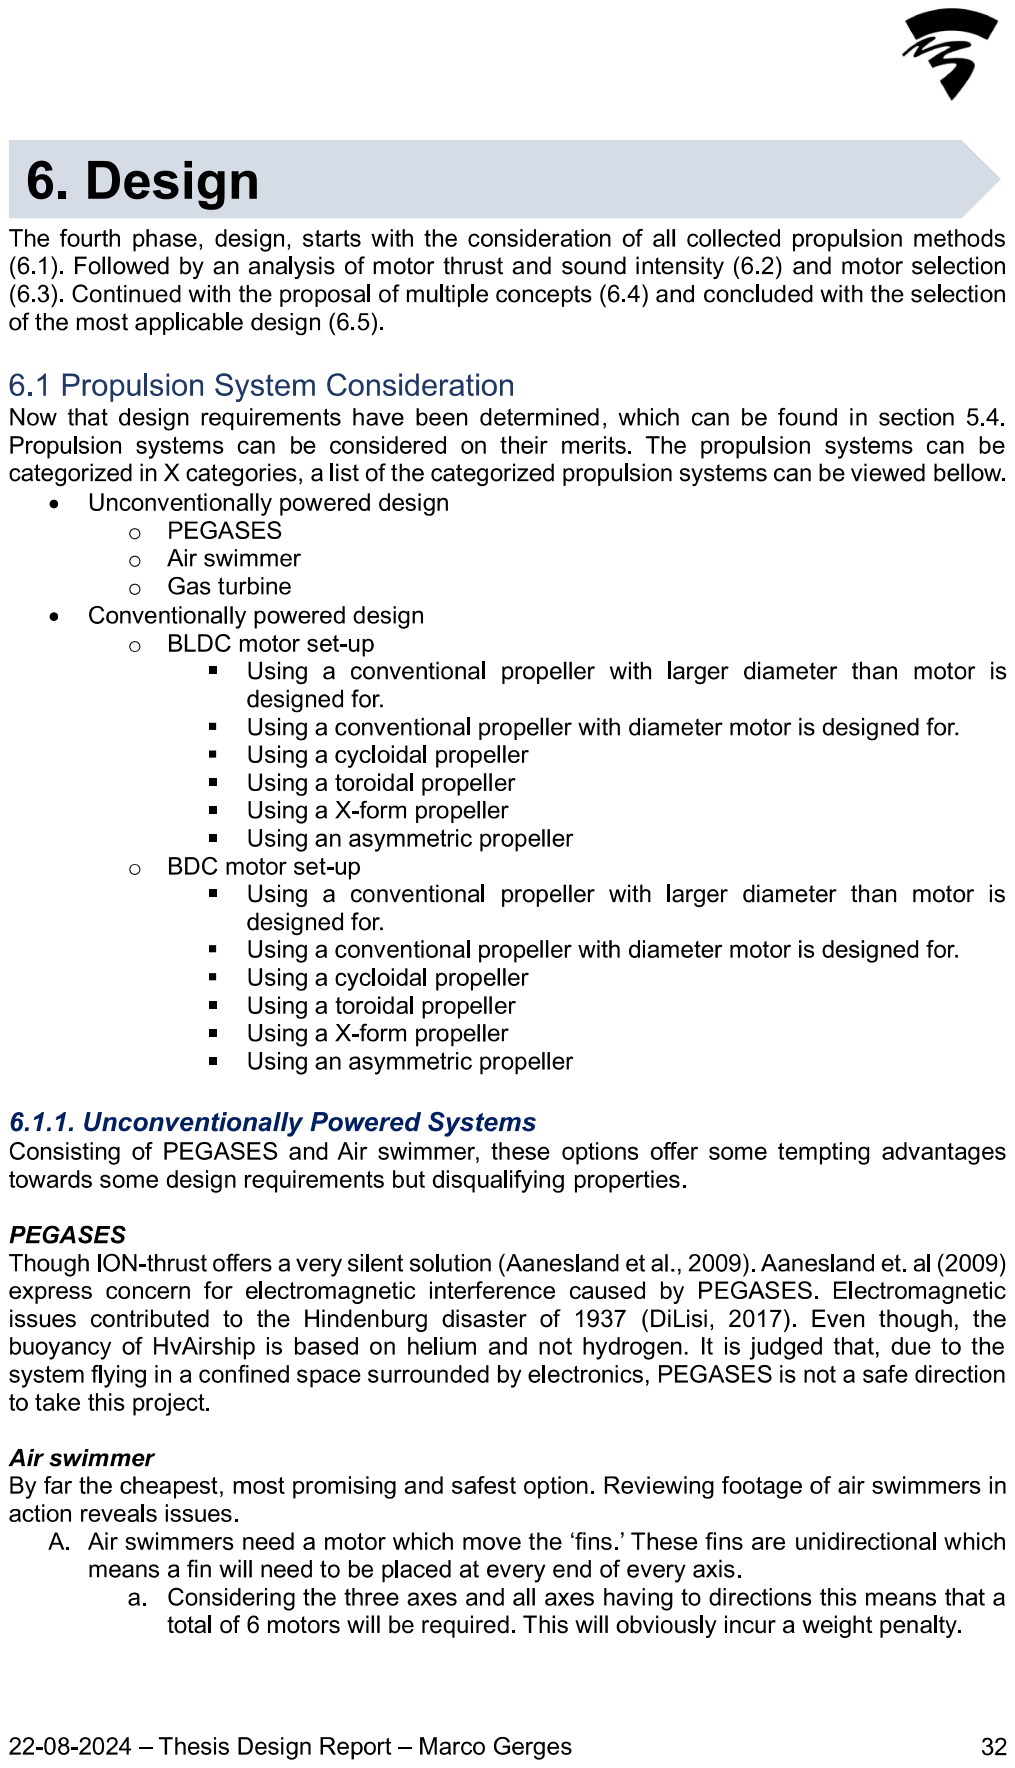
[picture p118: page 33]

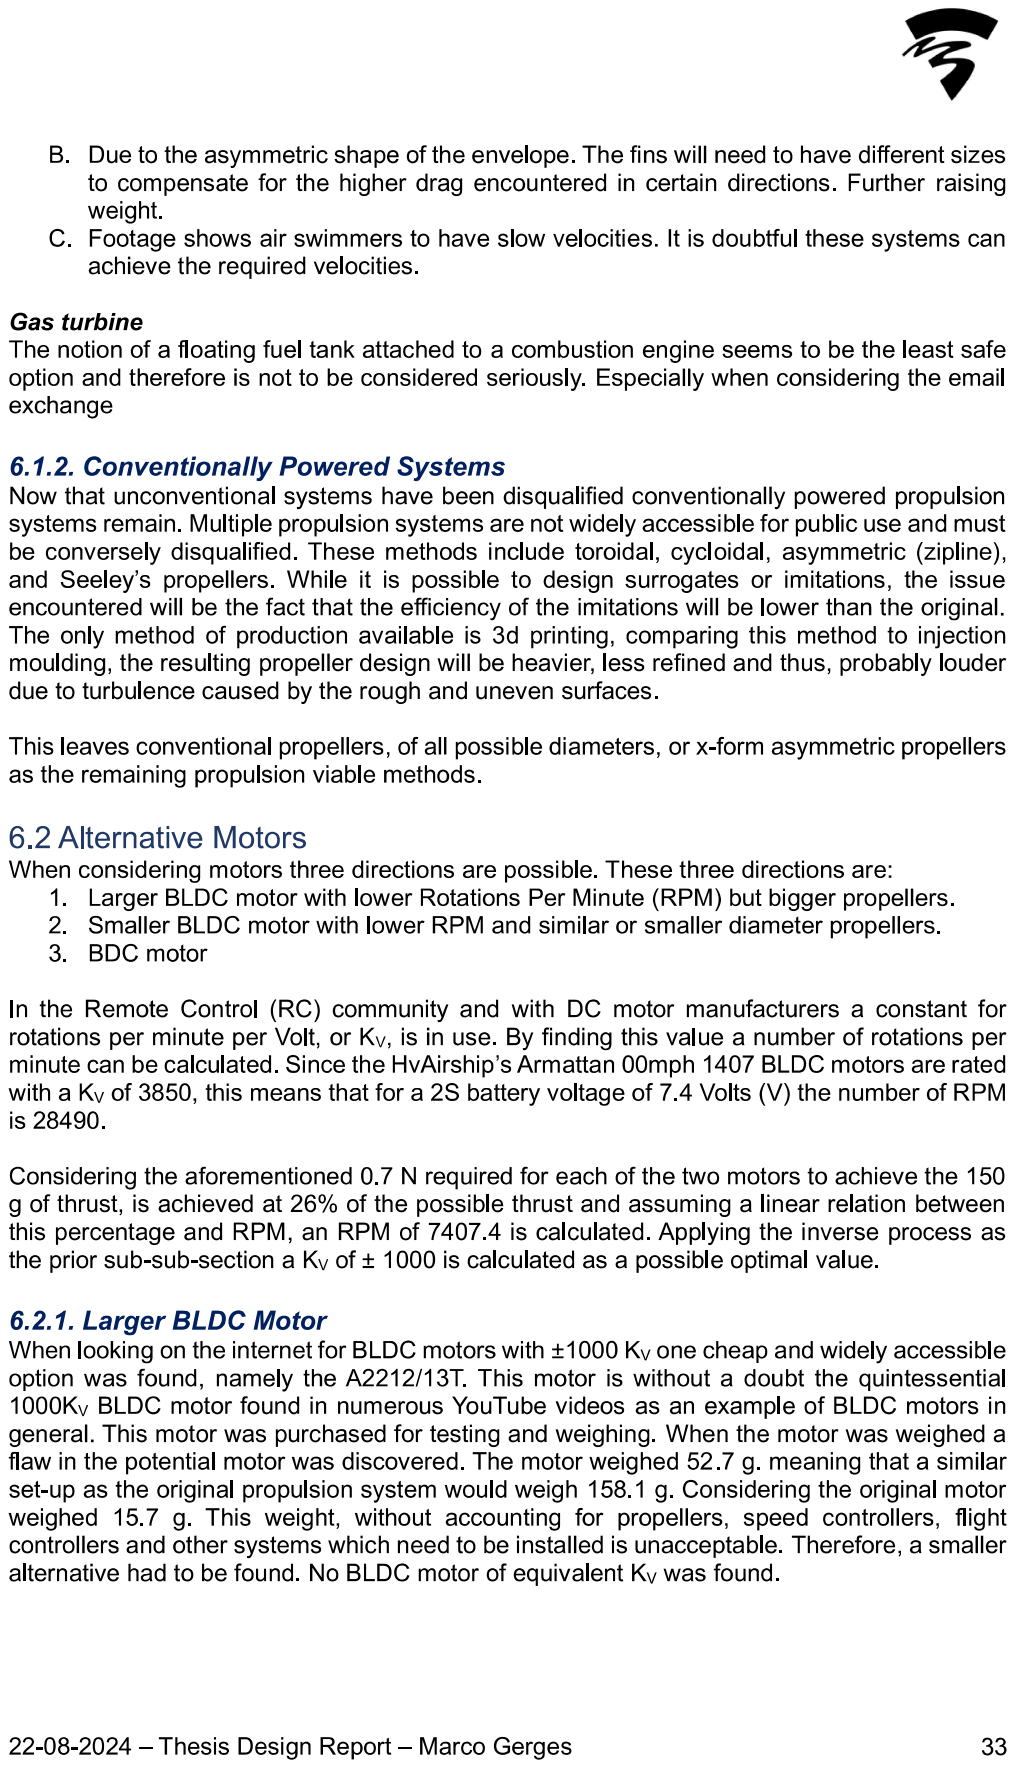
[picture p119: page 34]

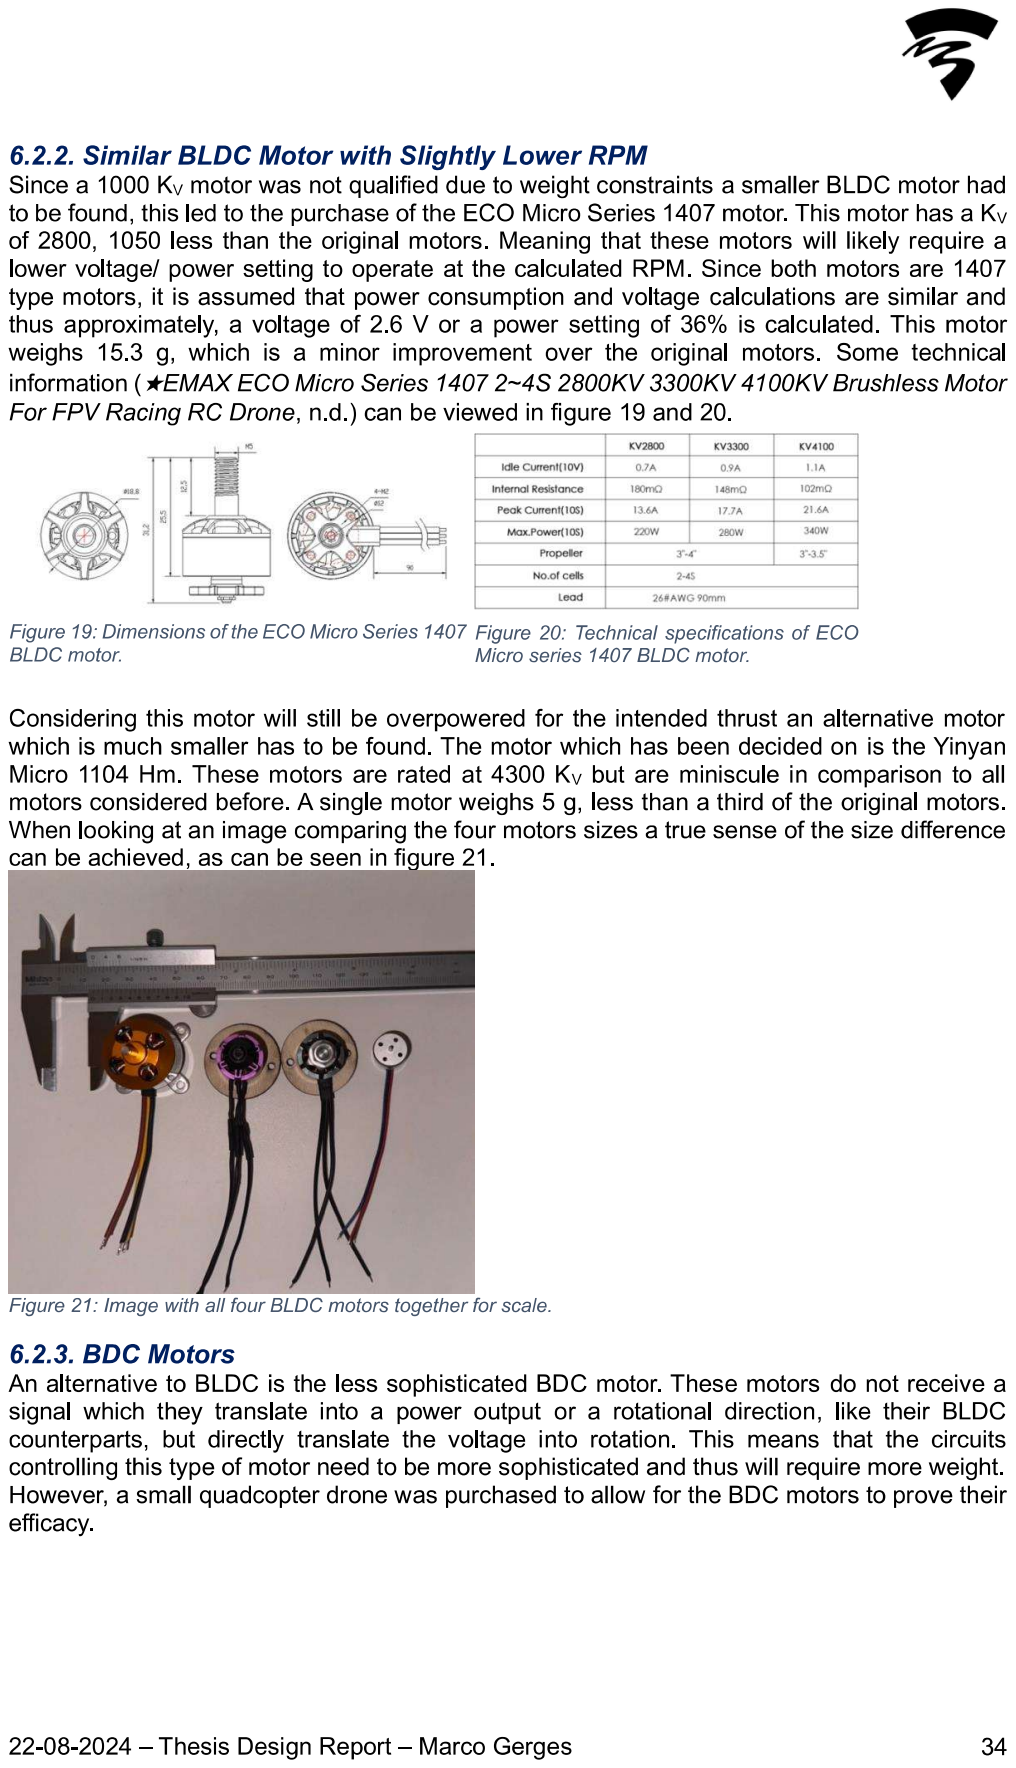
[picture p120: page 35]

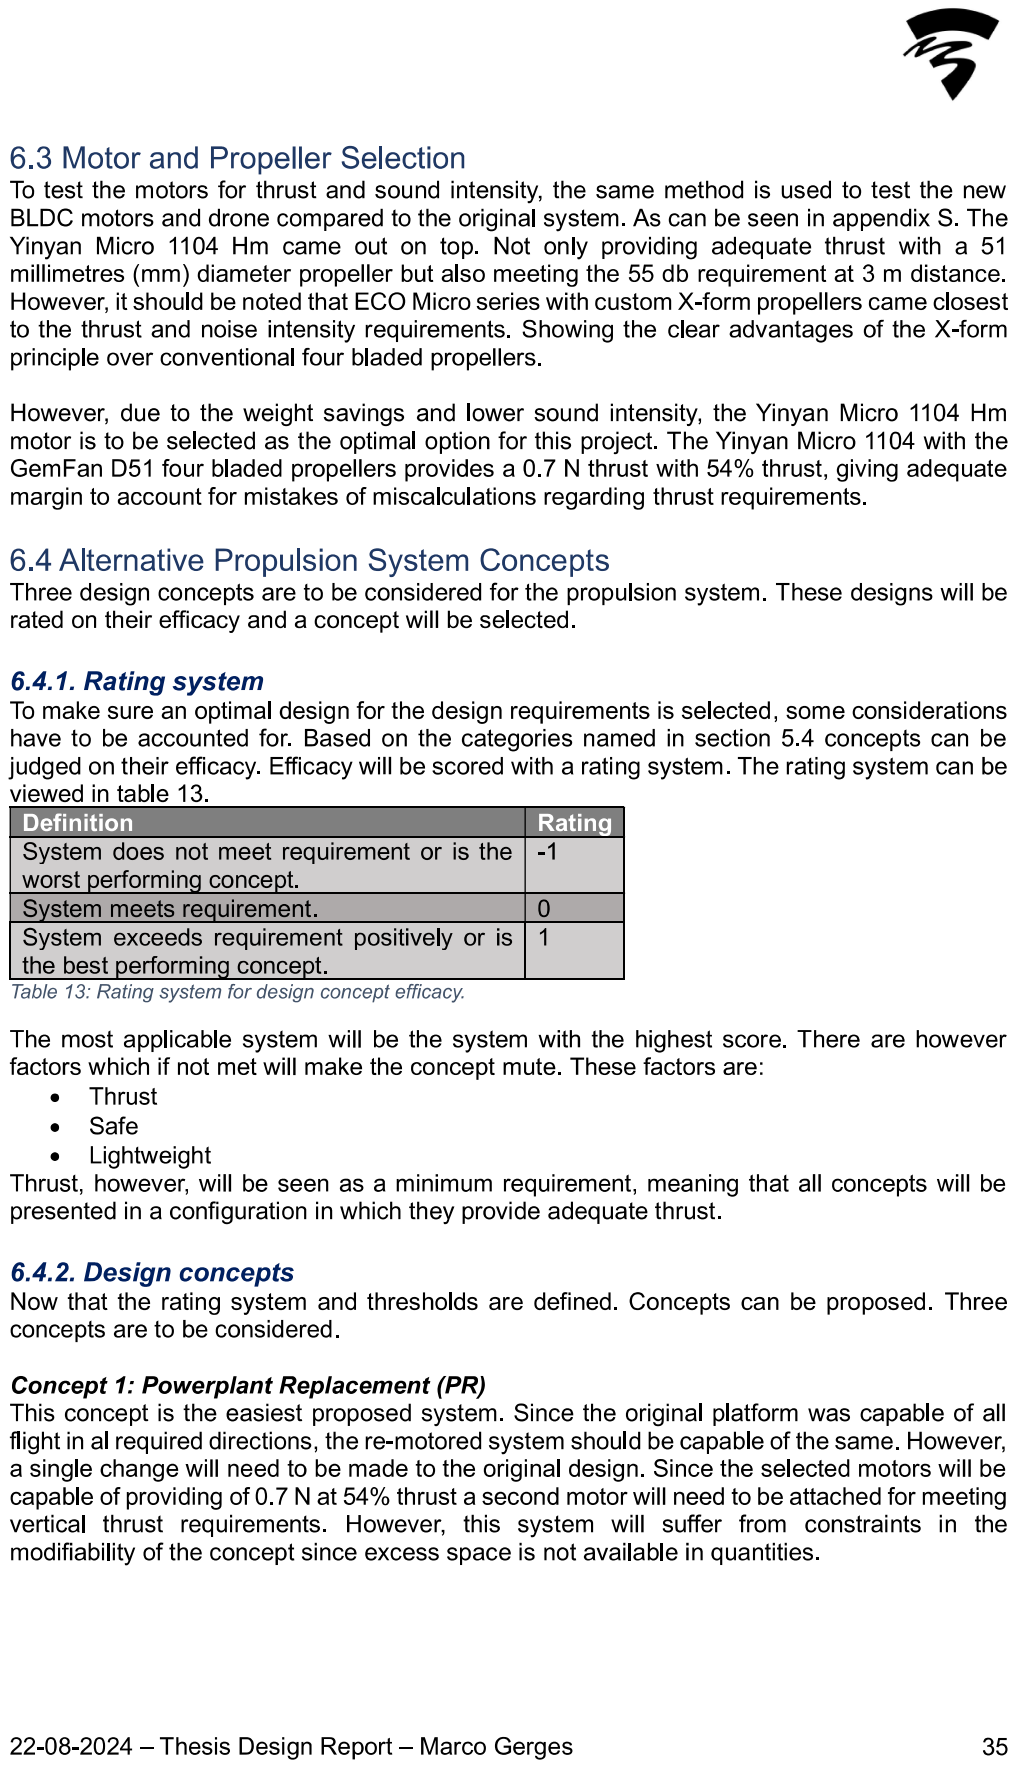
[picture p121: page 36]

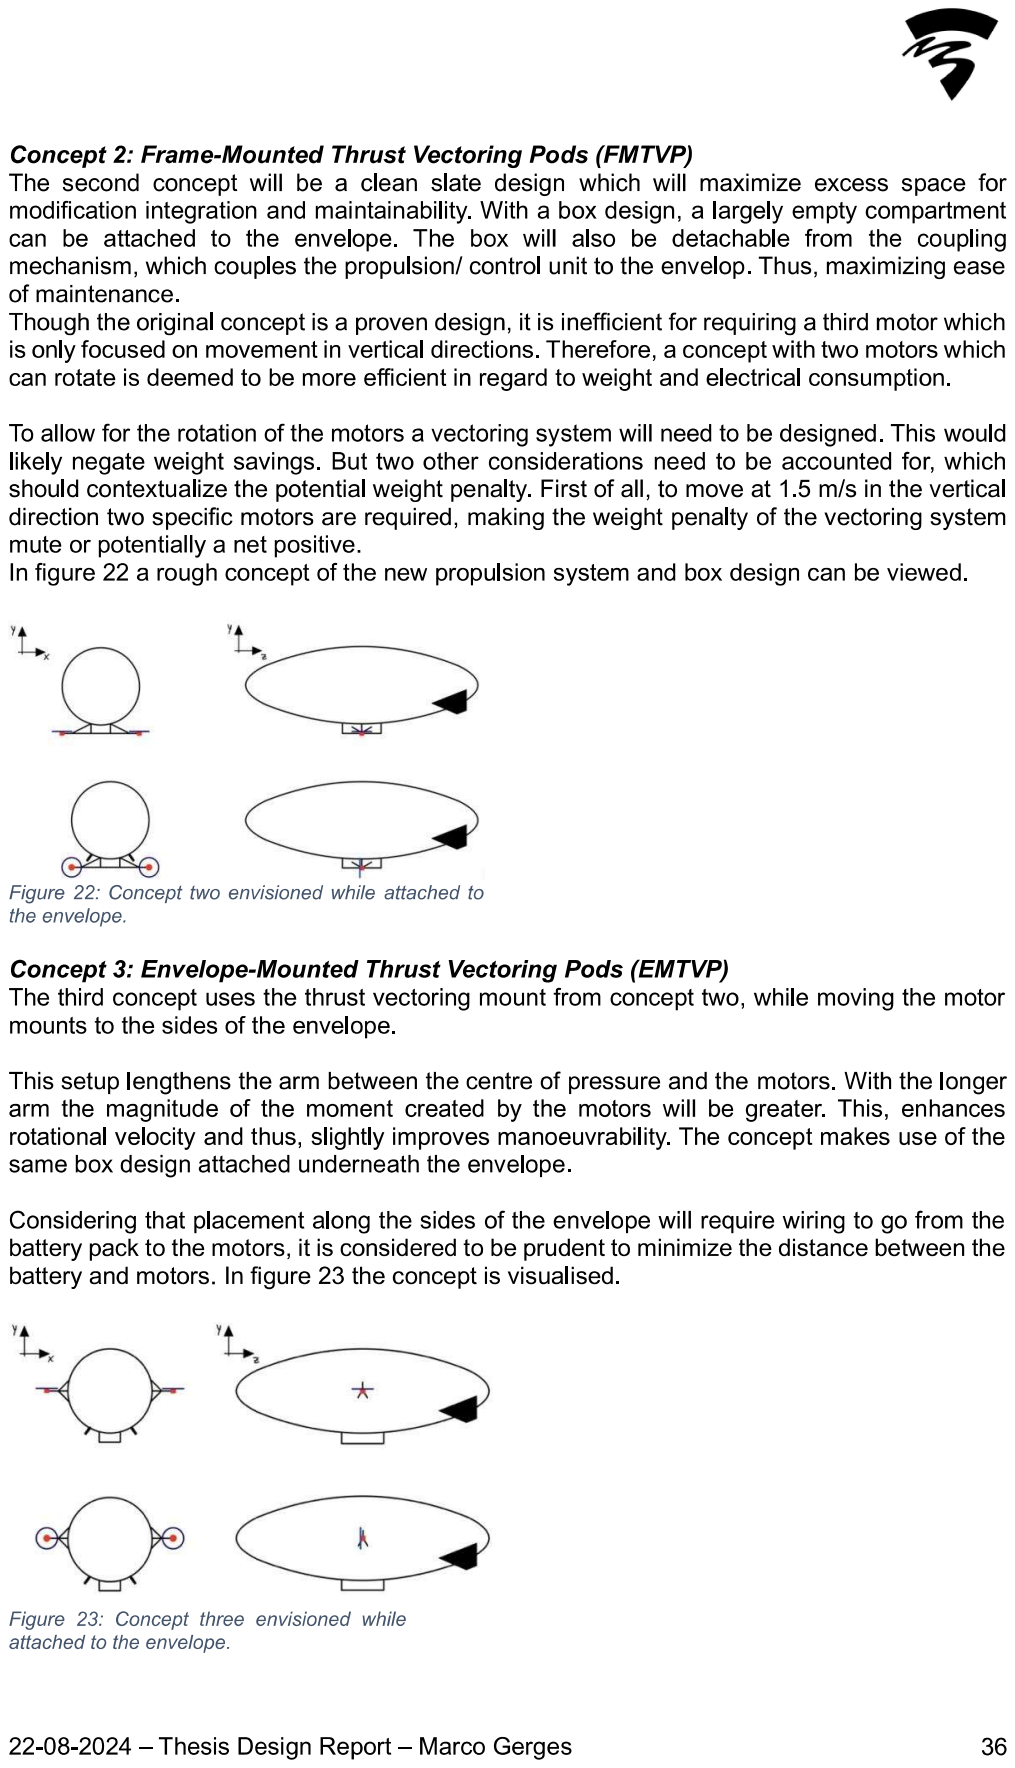
[picture p122: page 37]

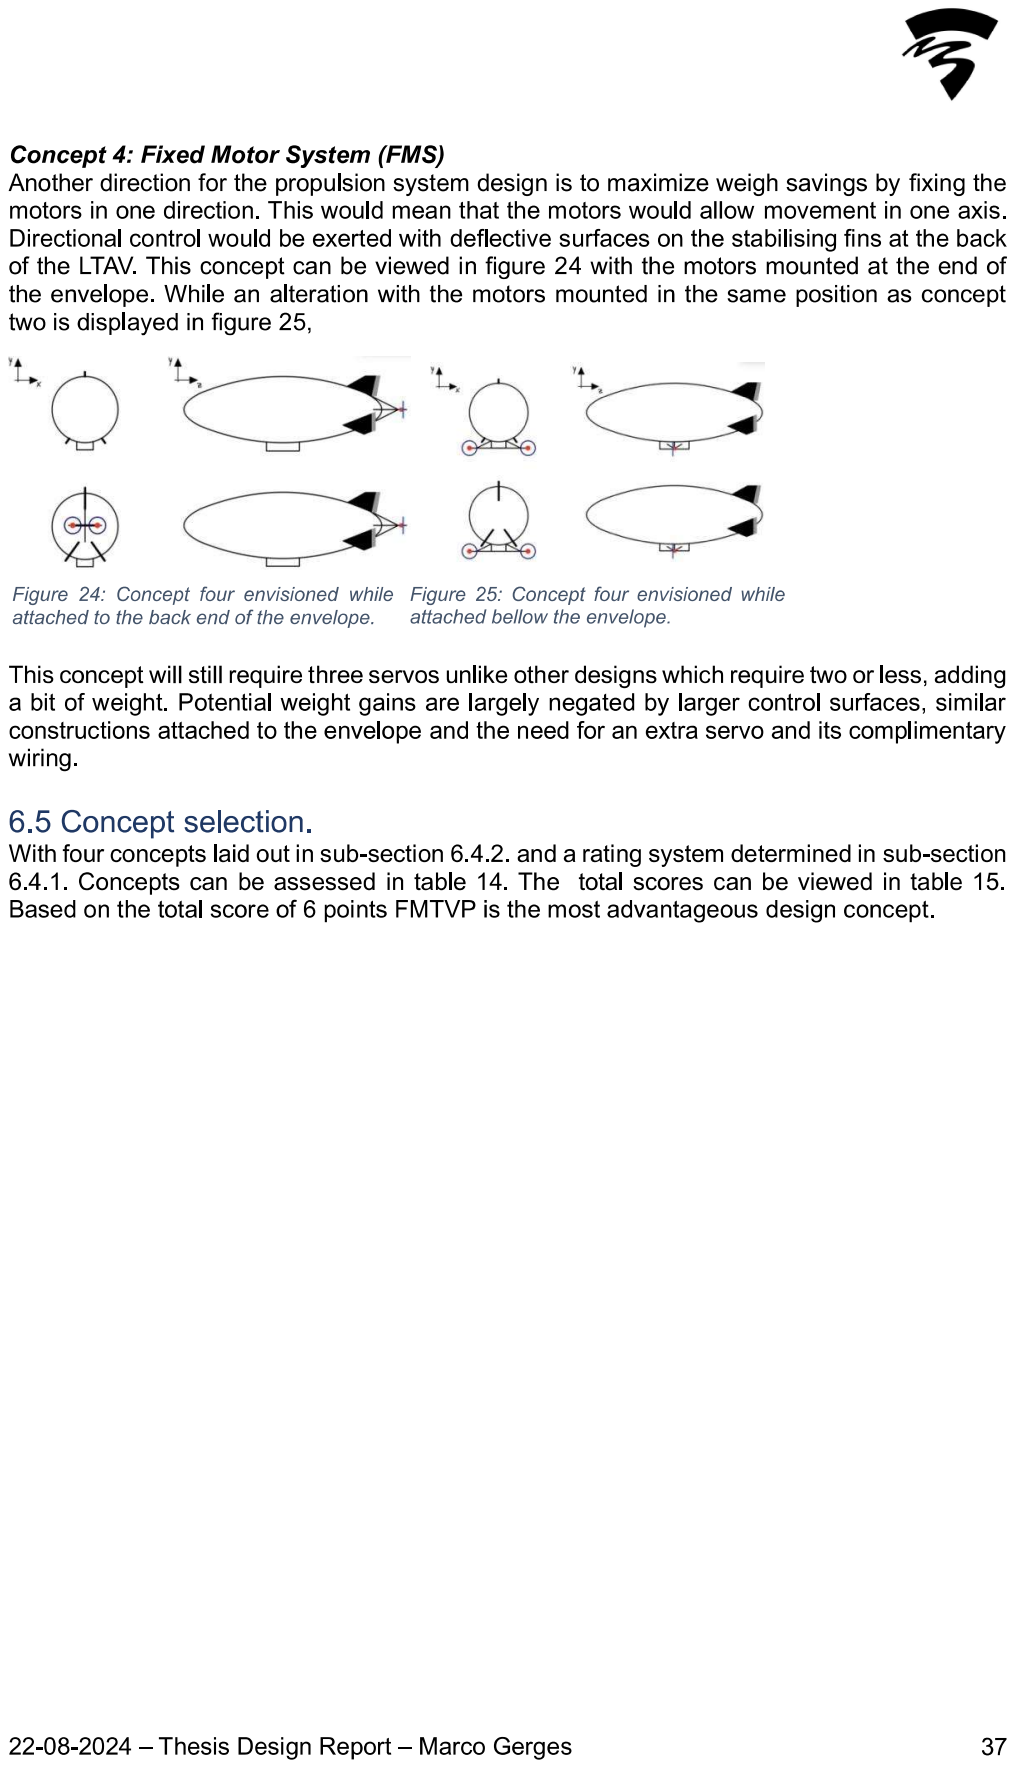
[picture p123: page 38]

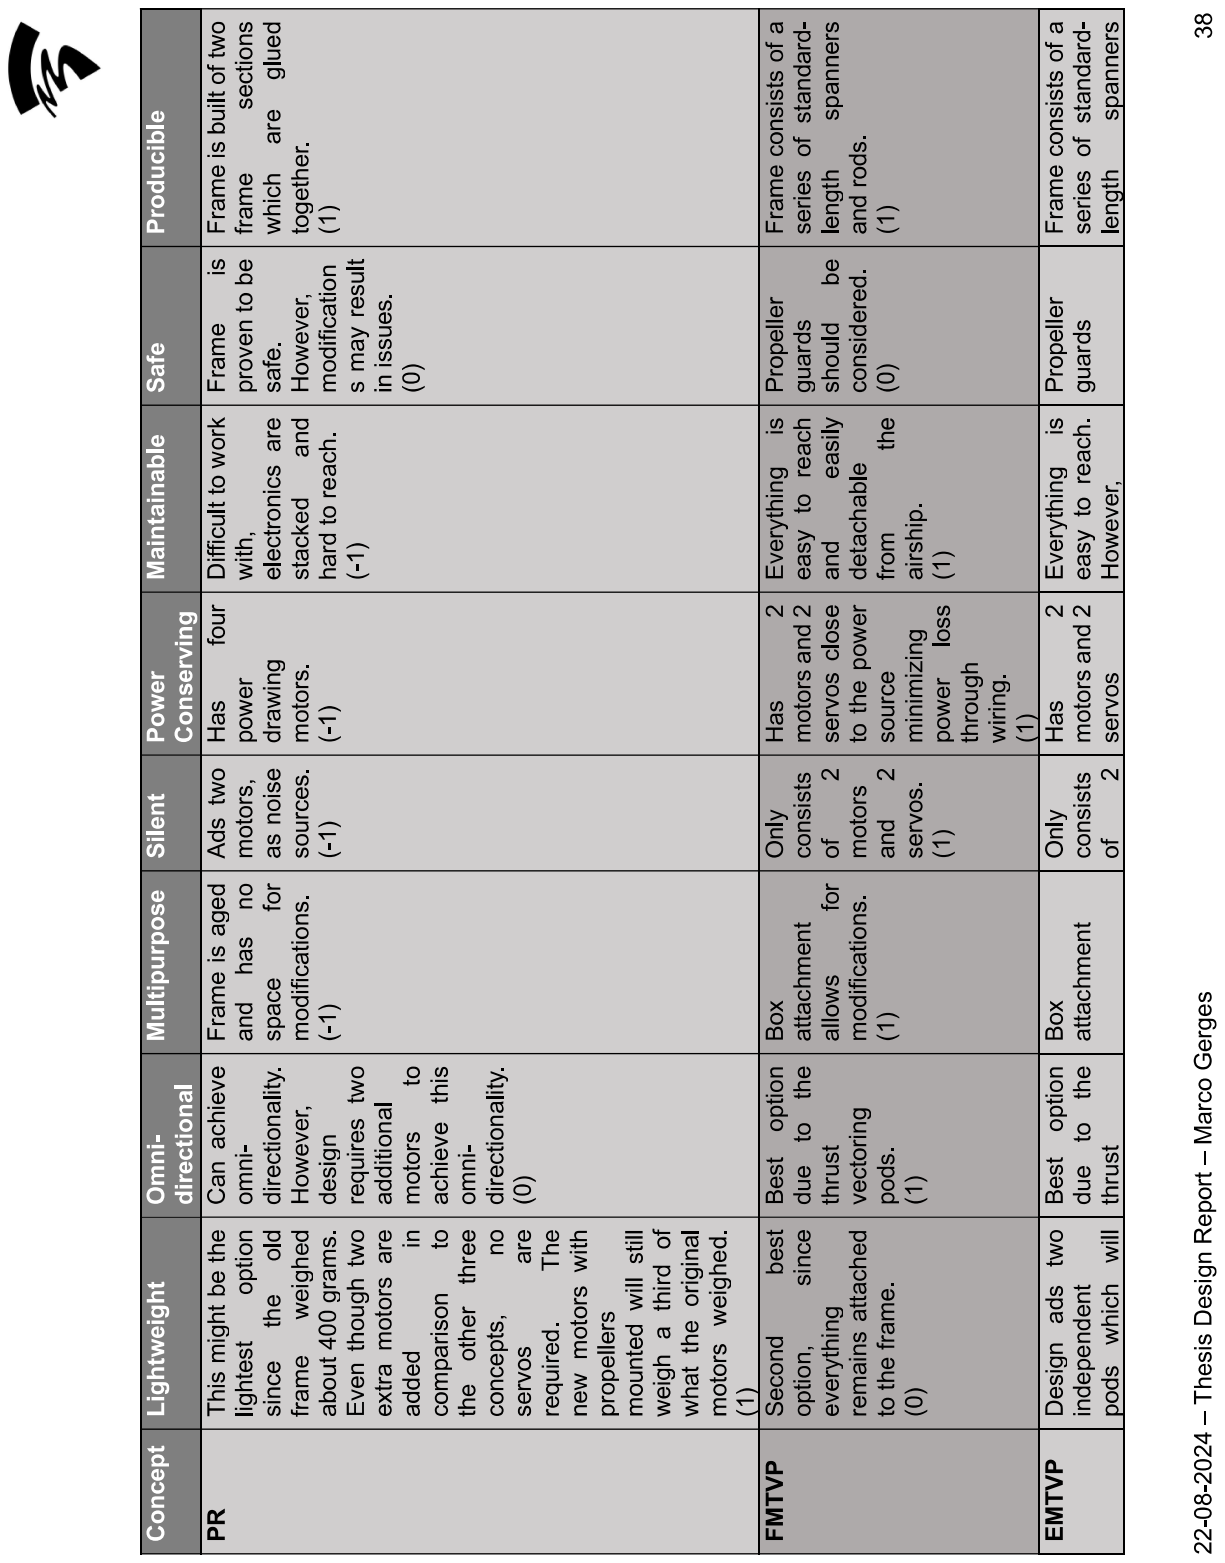
[picture p124: page 39]

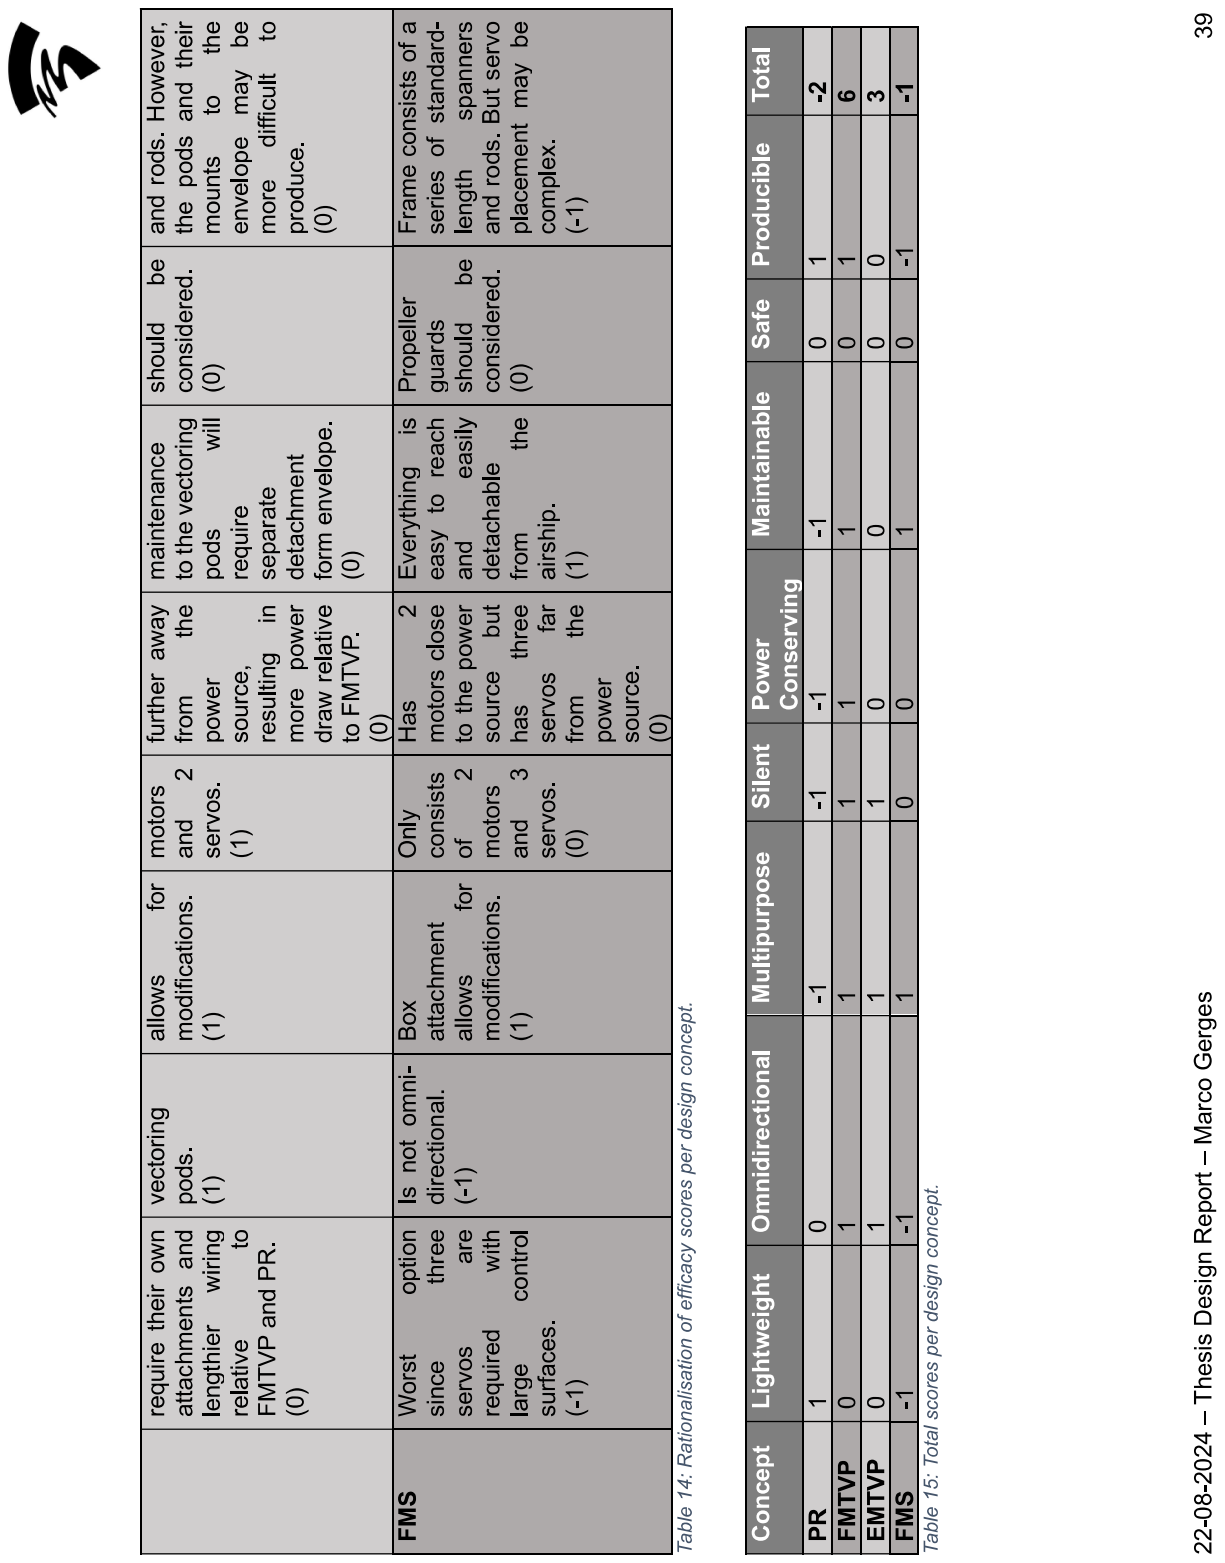
[picture p125: page 40]

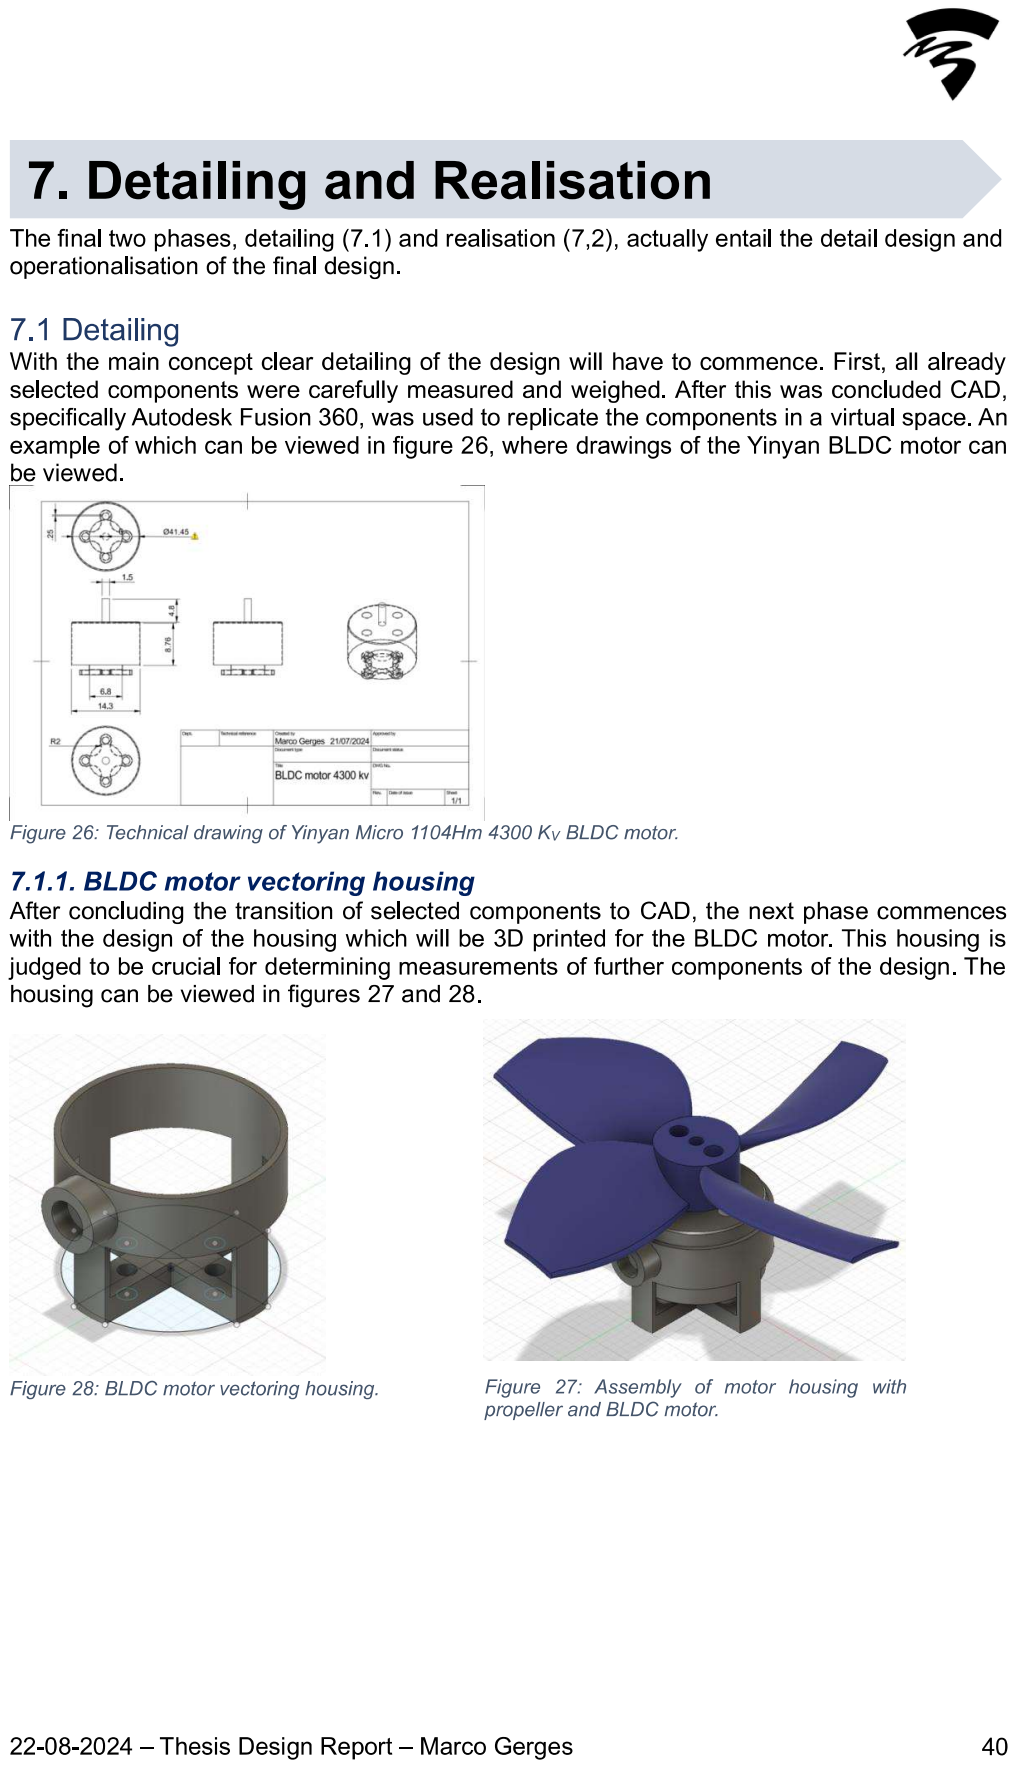
[picture p126: page 41]

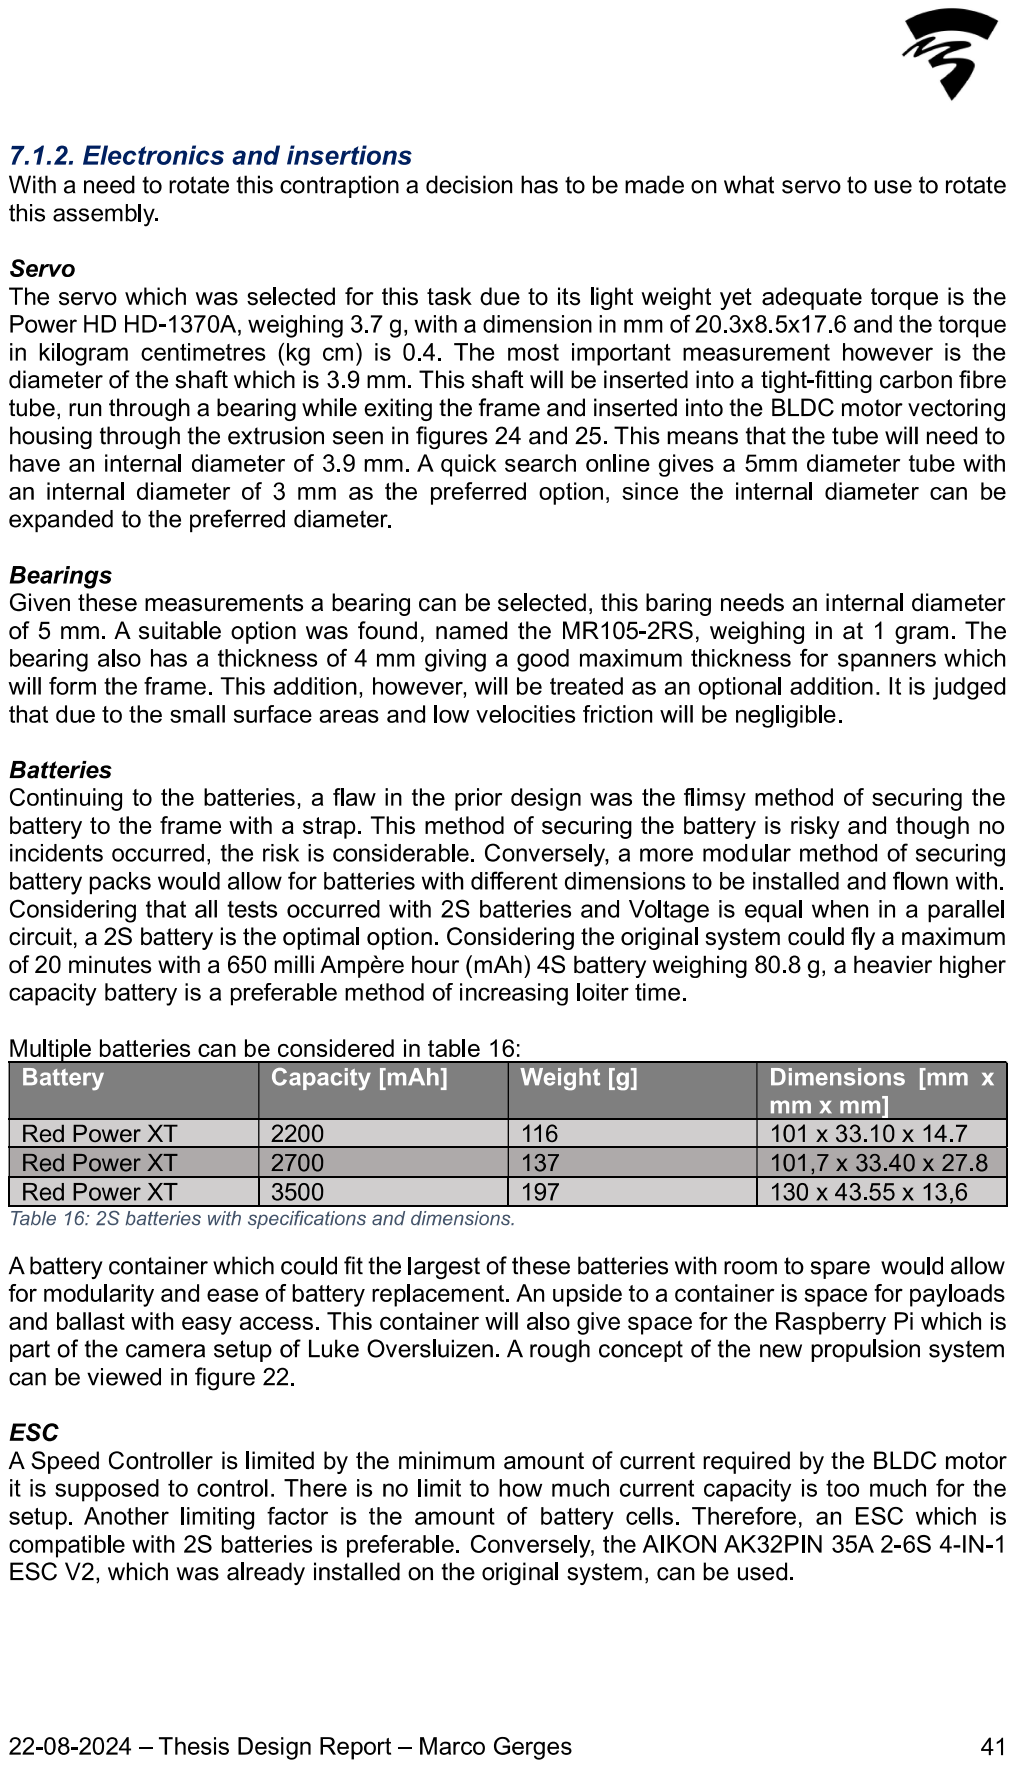
[picture p127: page 42]

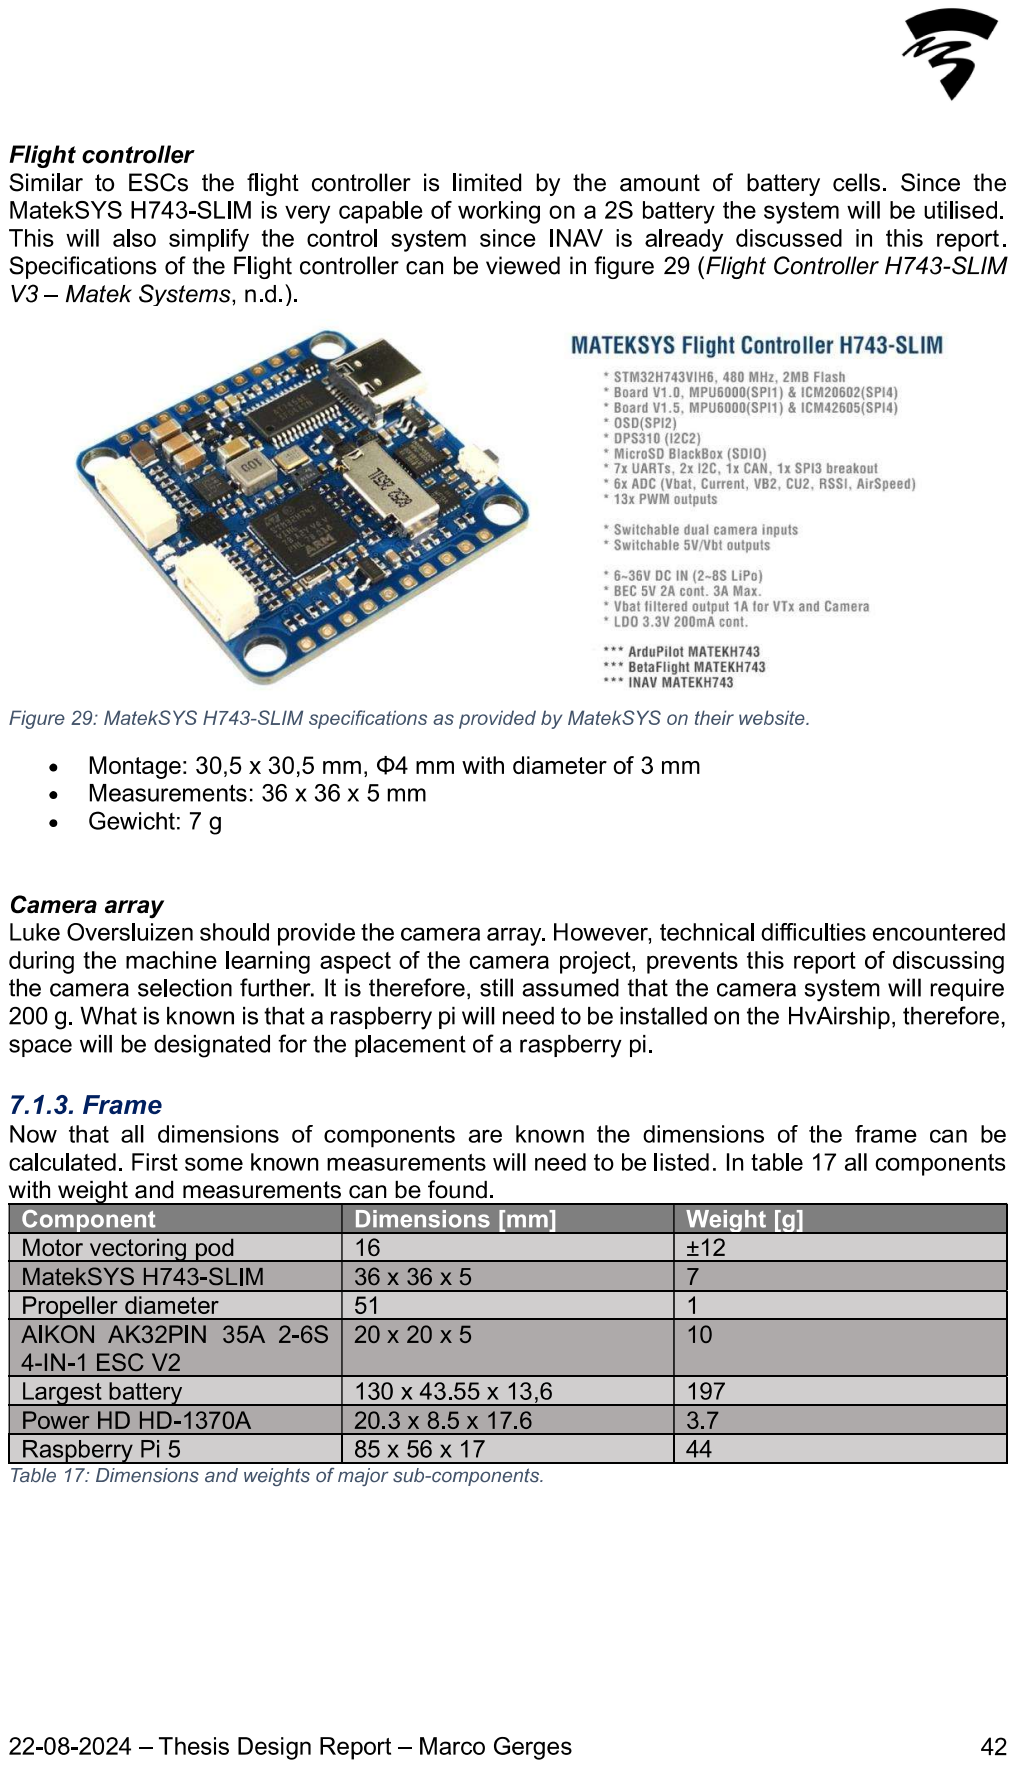
[picture p128: page 43]

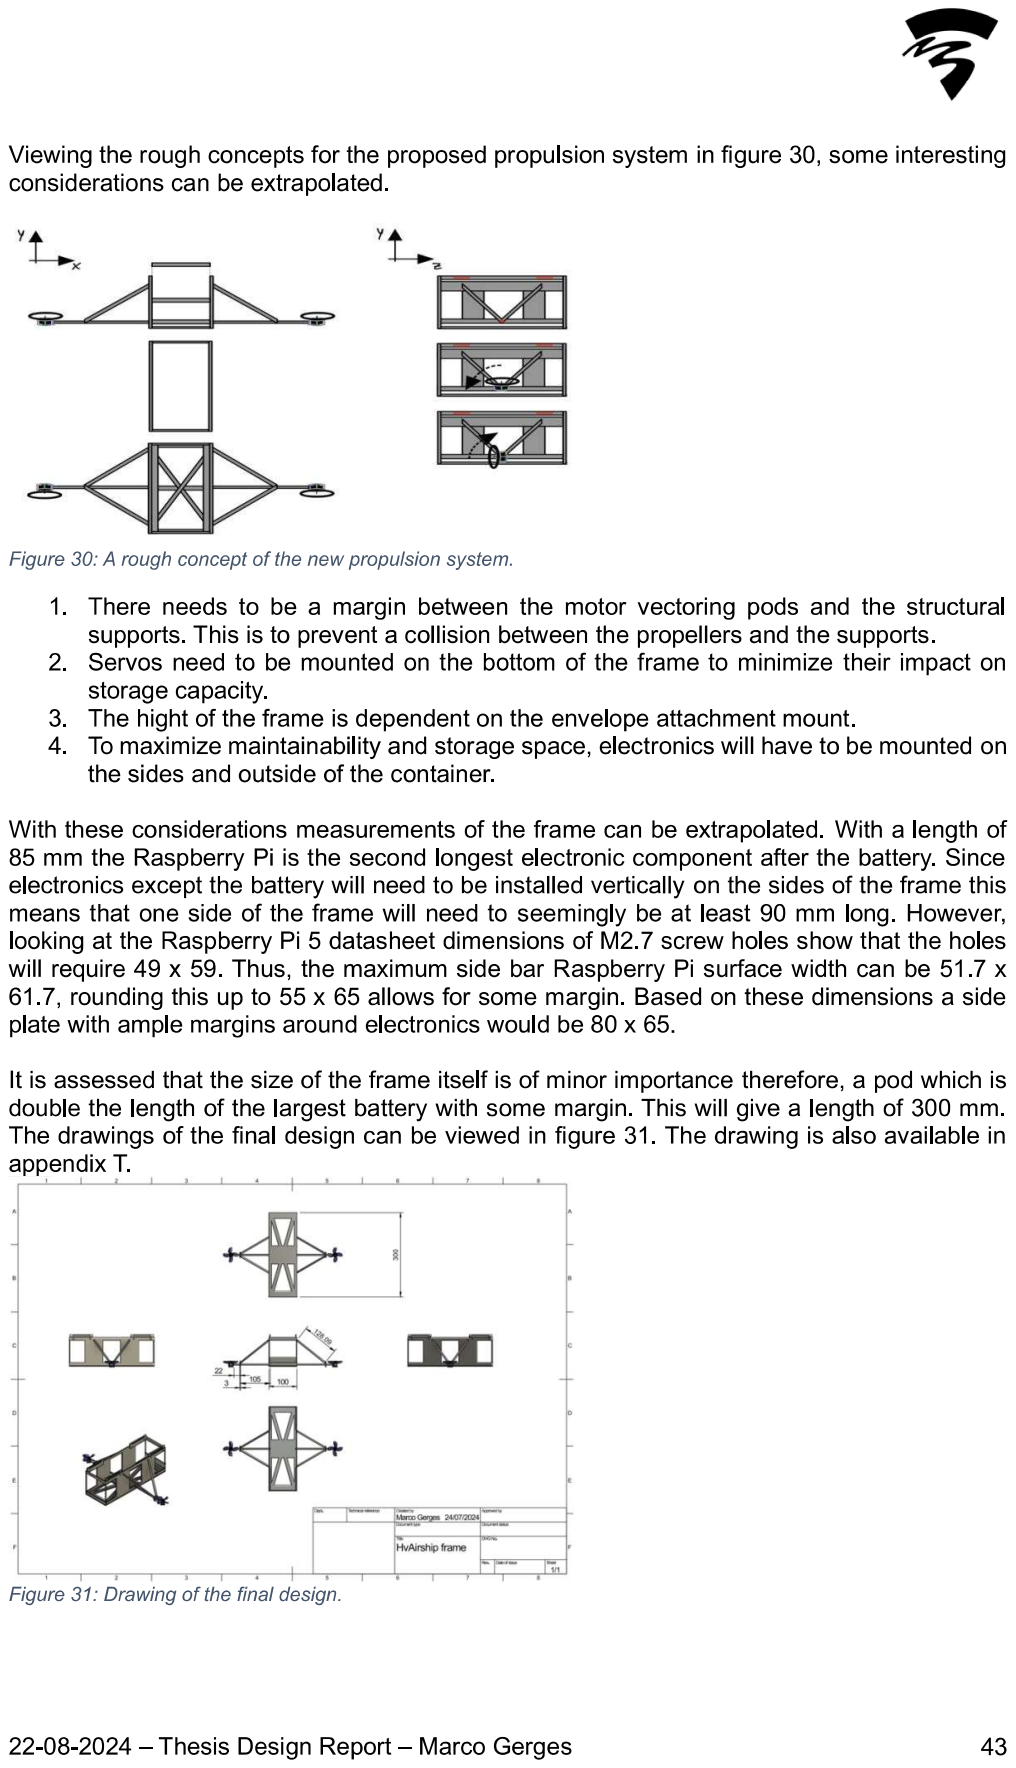
[picture p129: page 44]

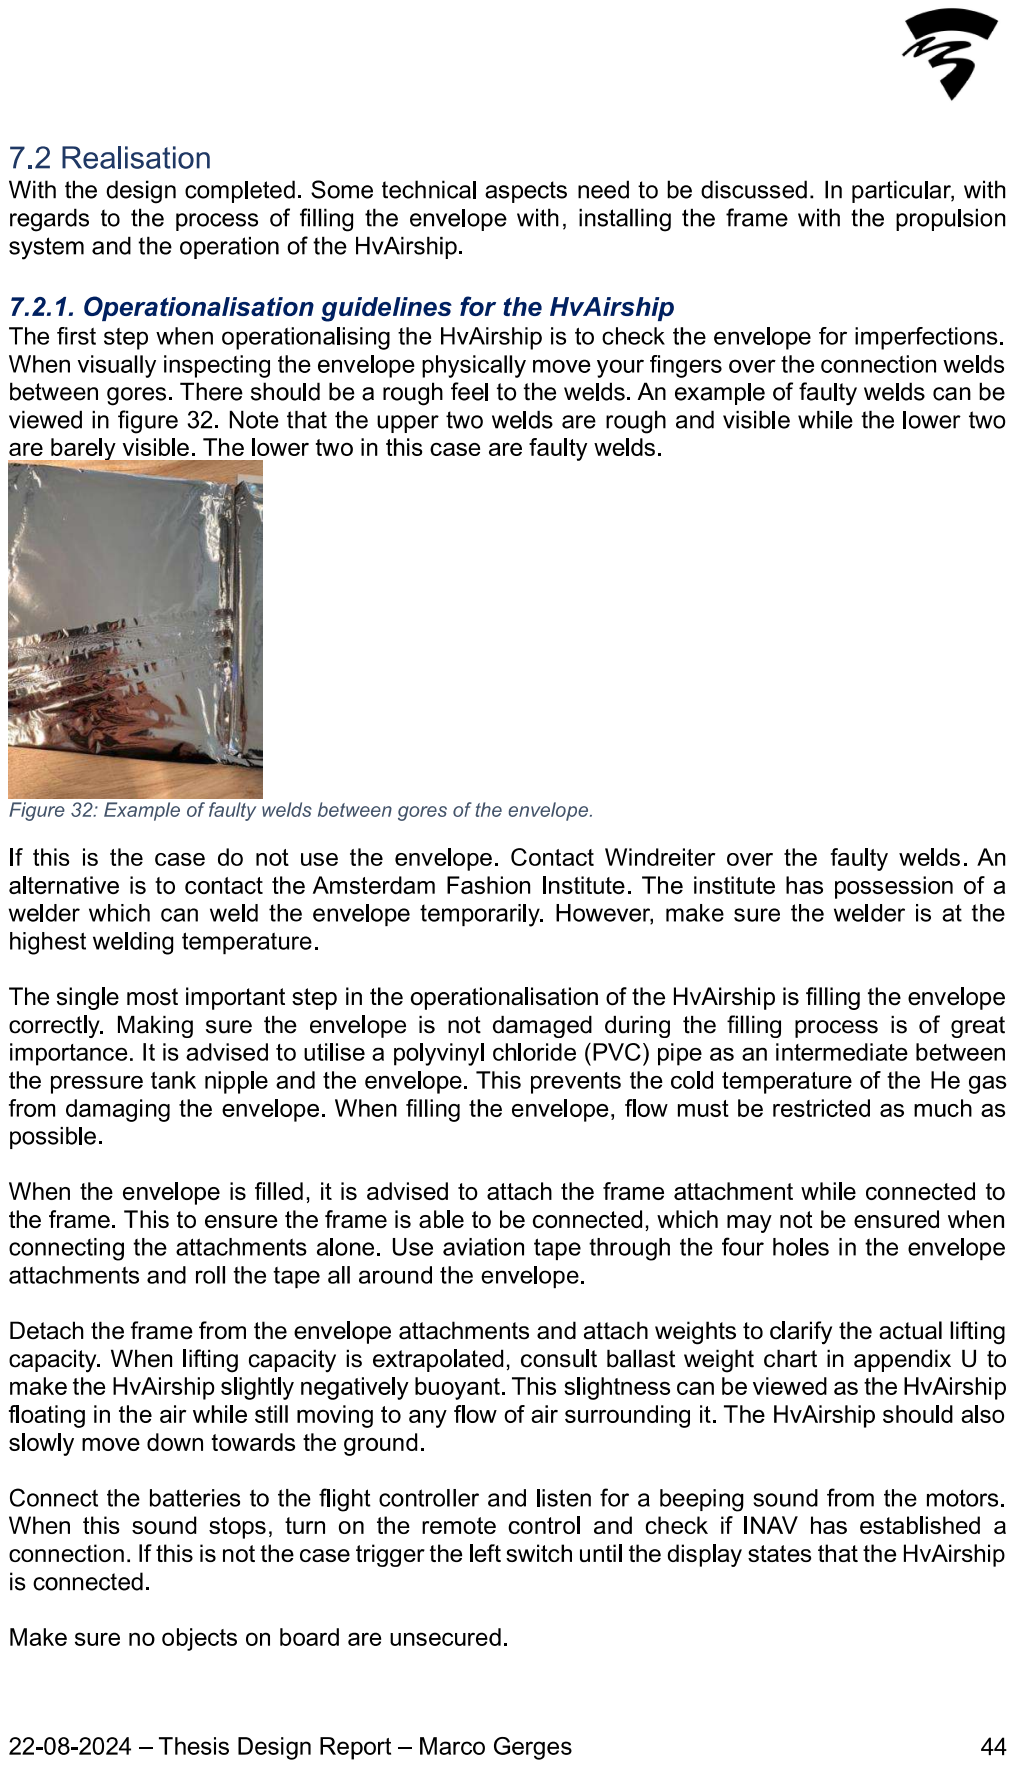
[picture p130: page 45]

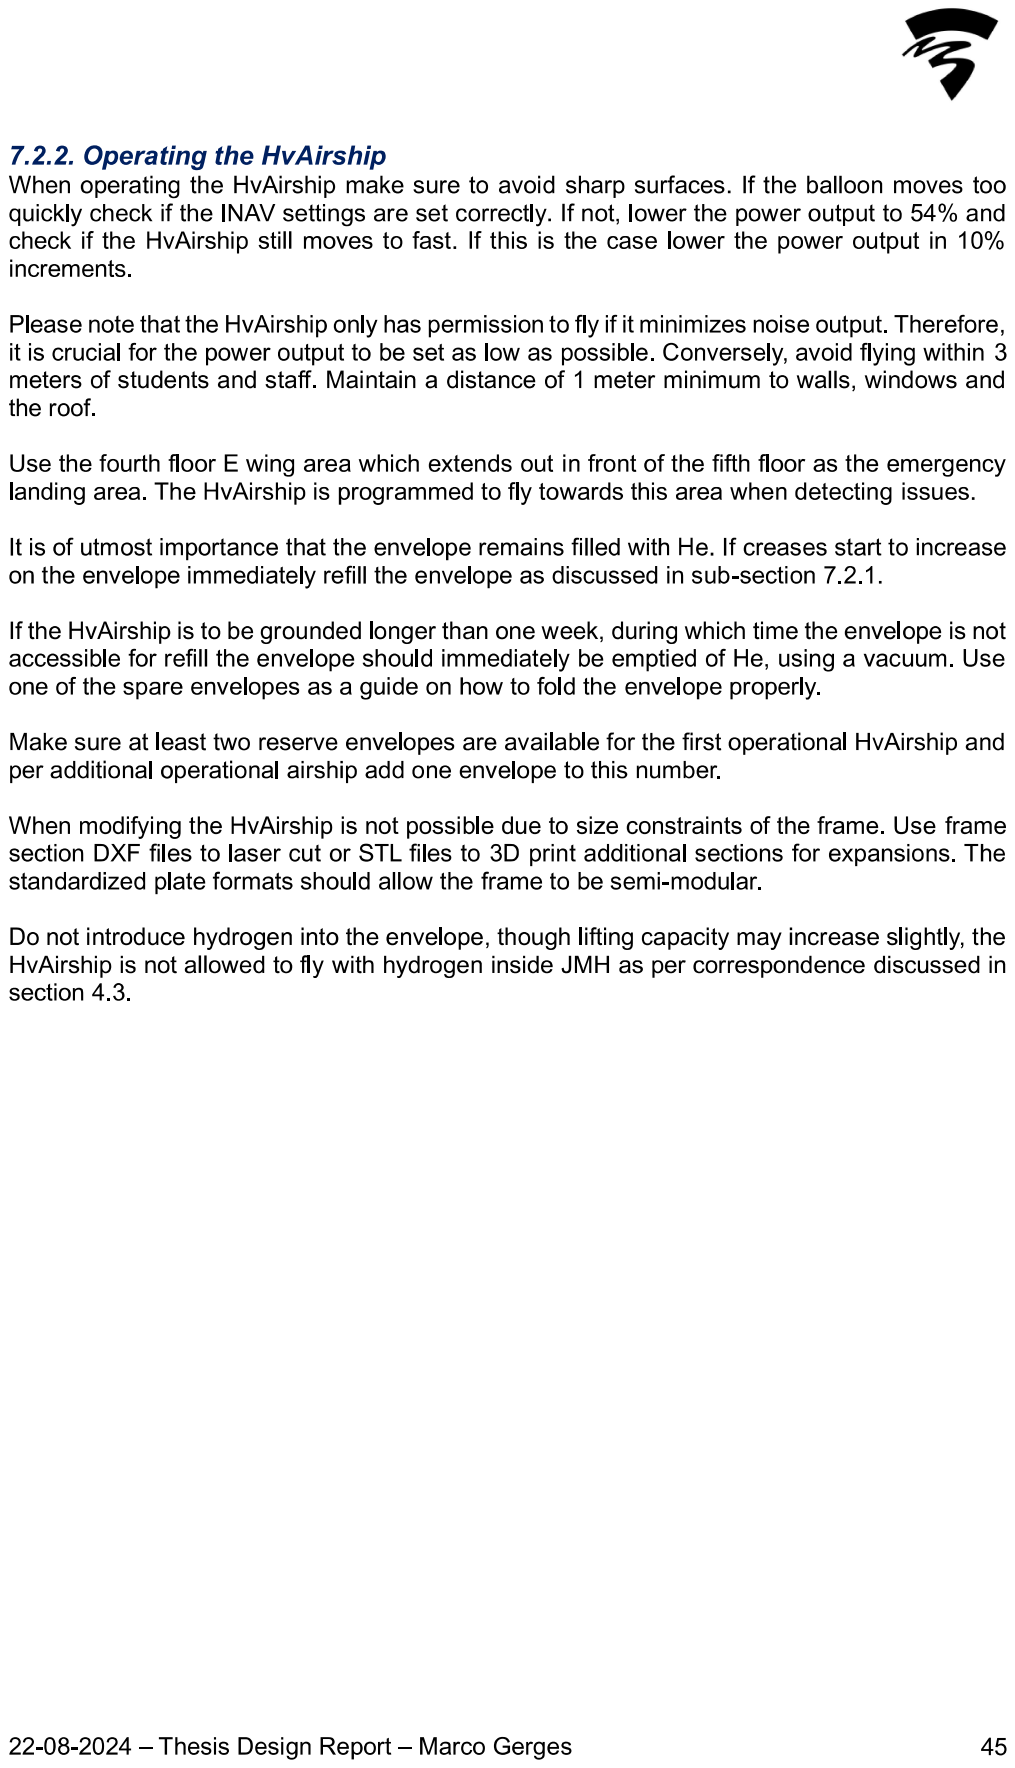
[picture p131: page 46]

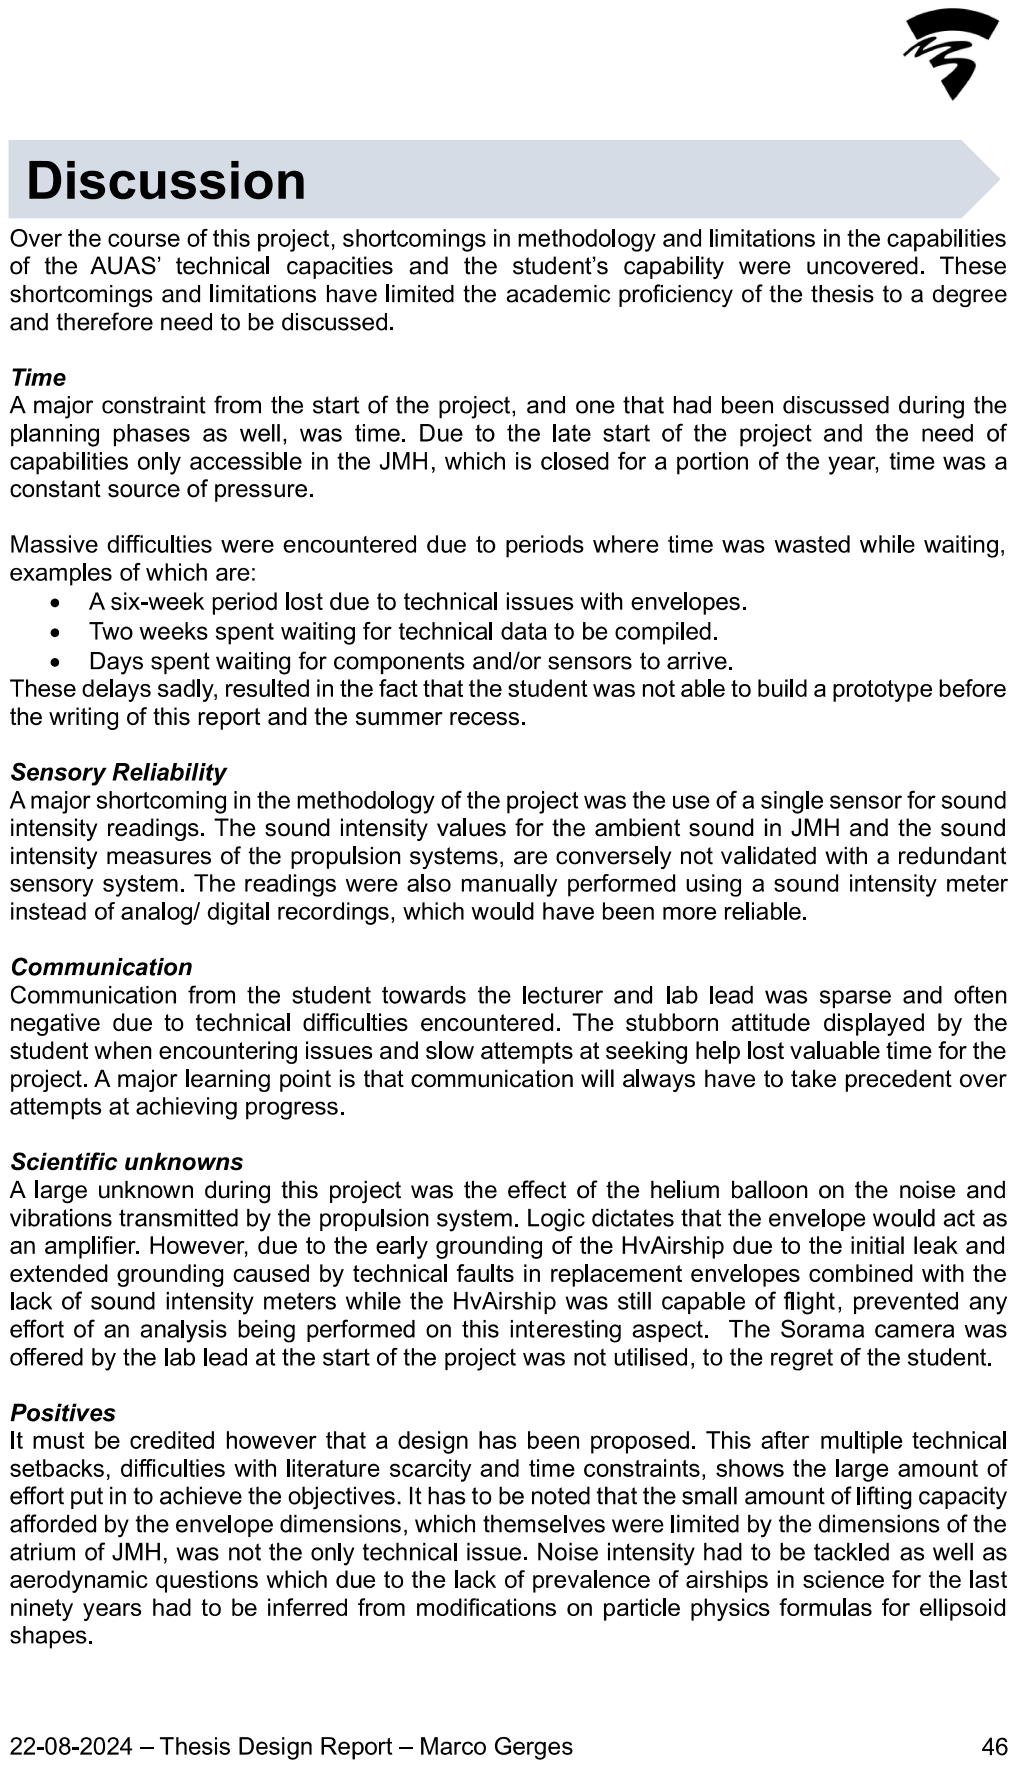
[picture p132: page 47]

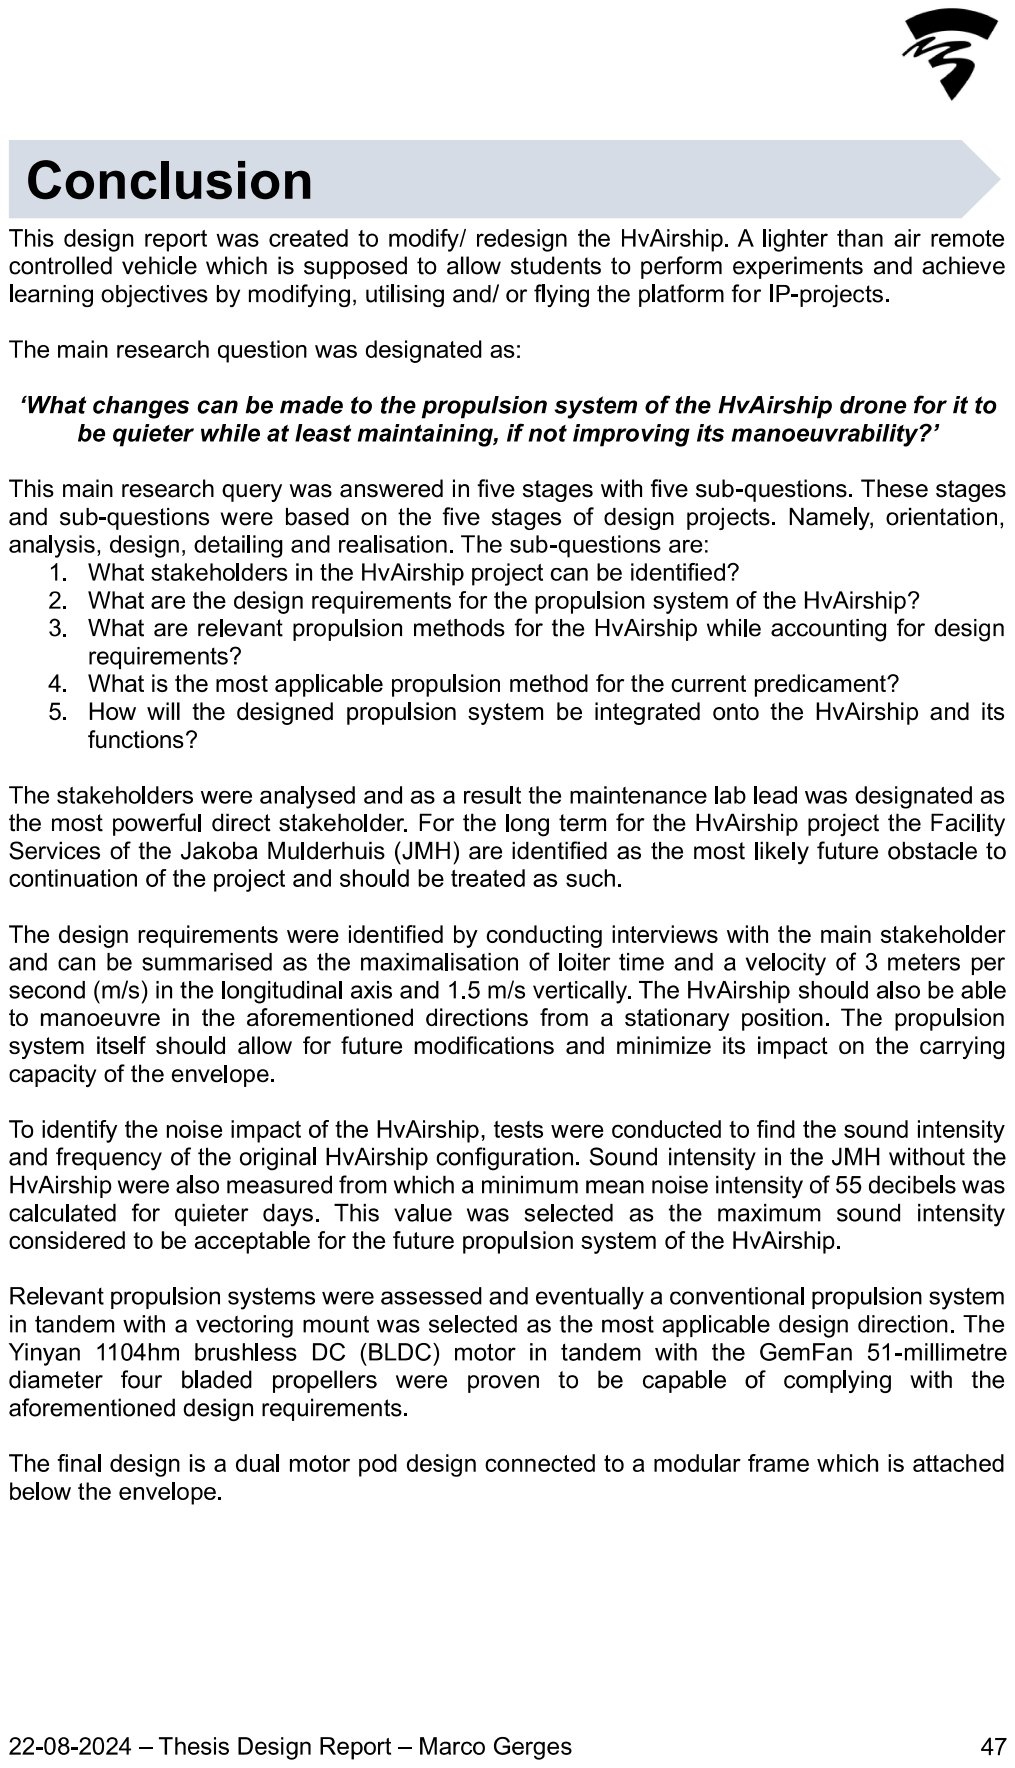
[picture p133: page 48]

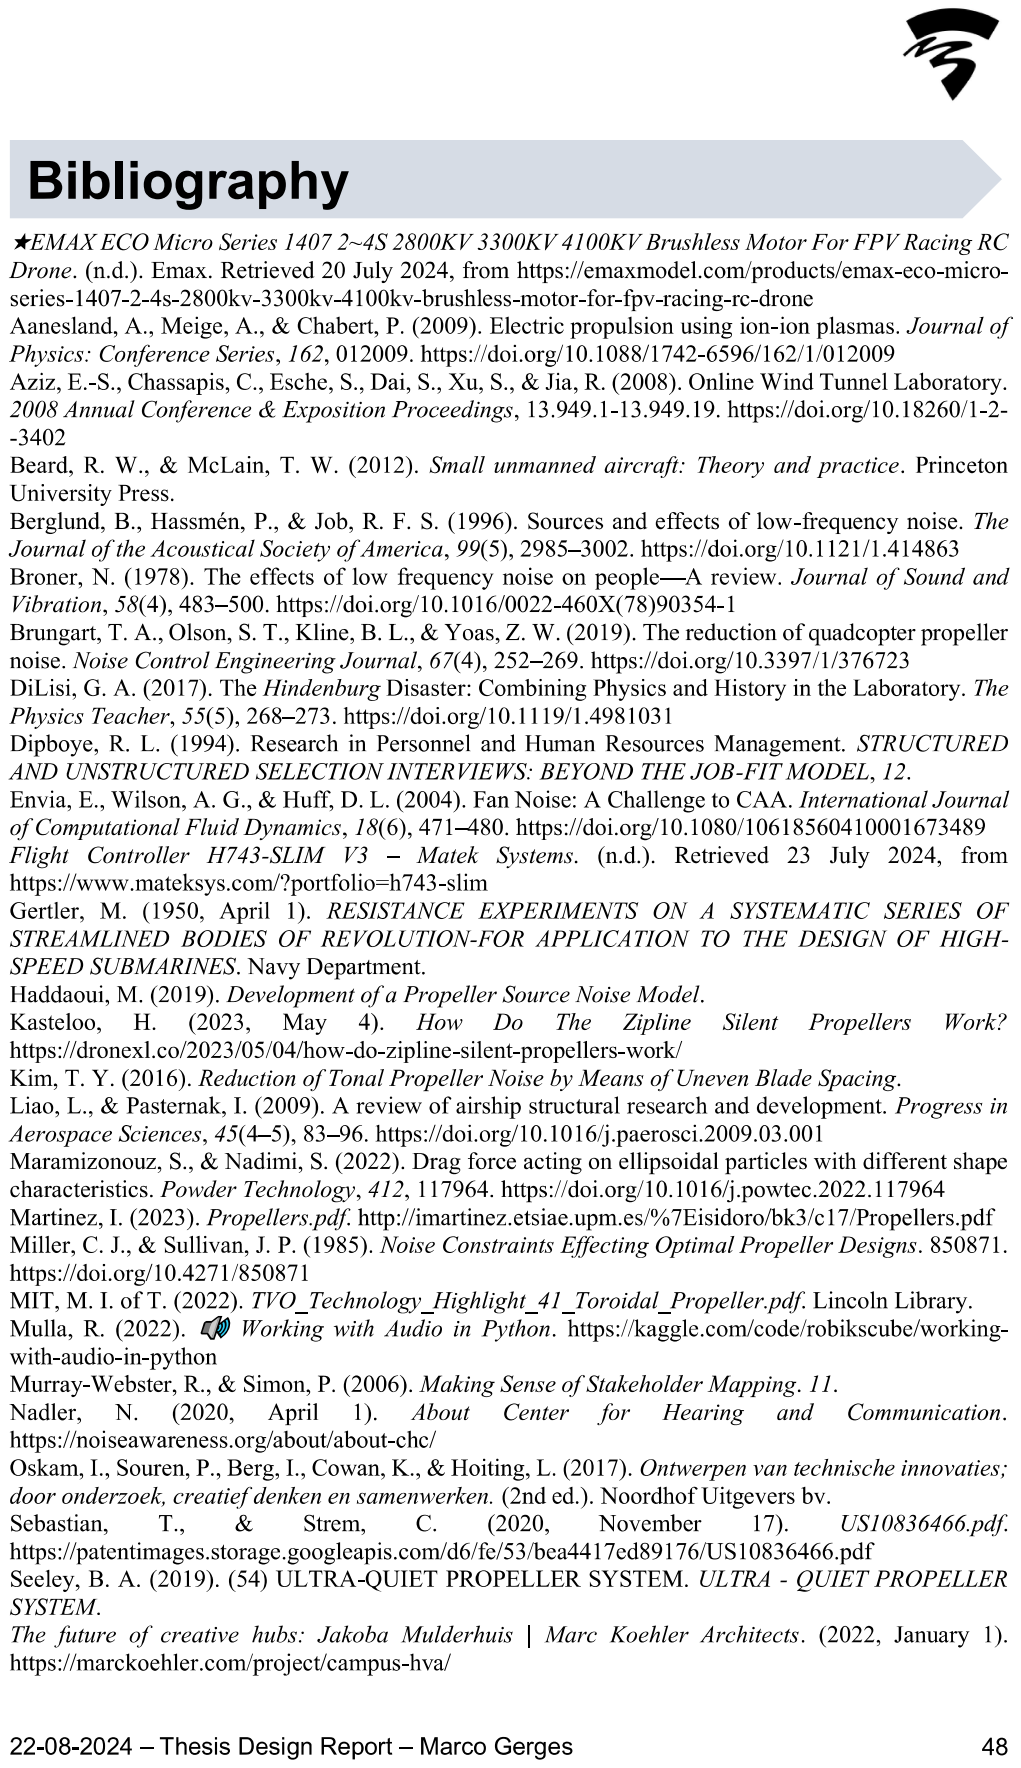
[picture p134: page 49]

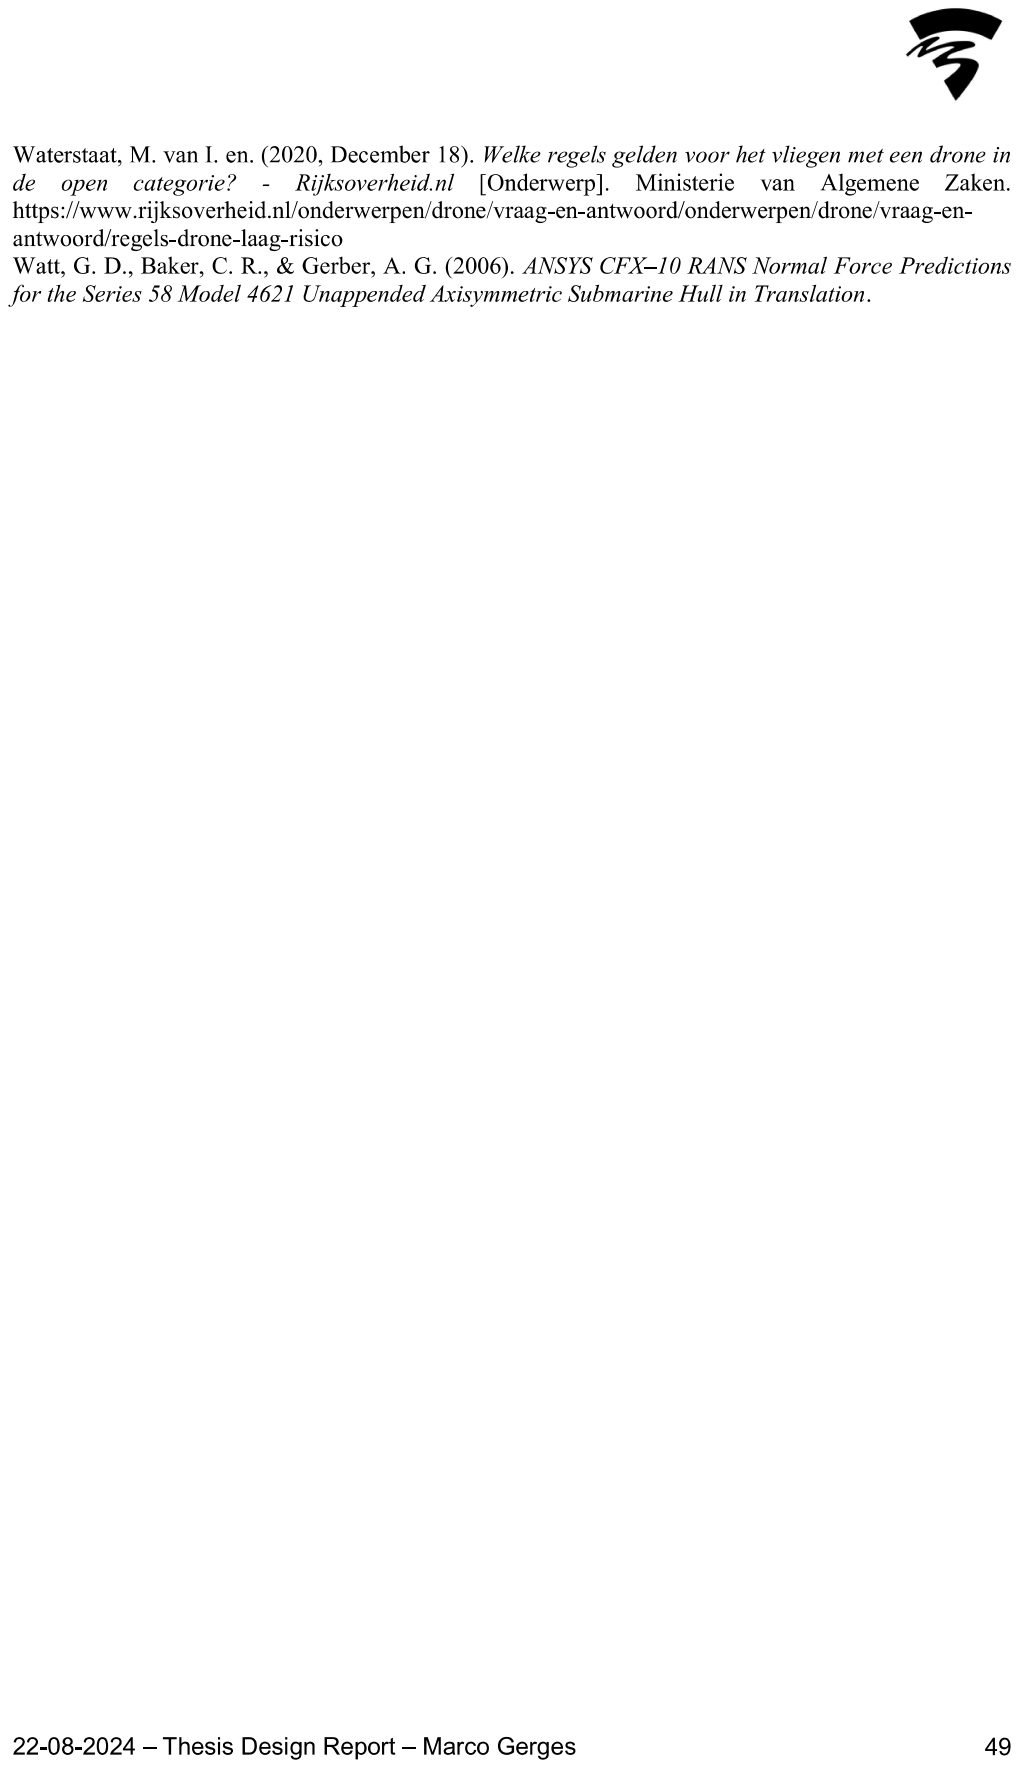
[picture p135: page 50]

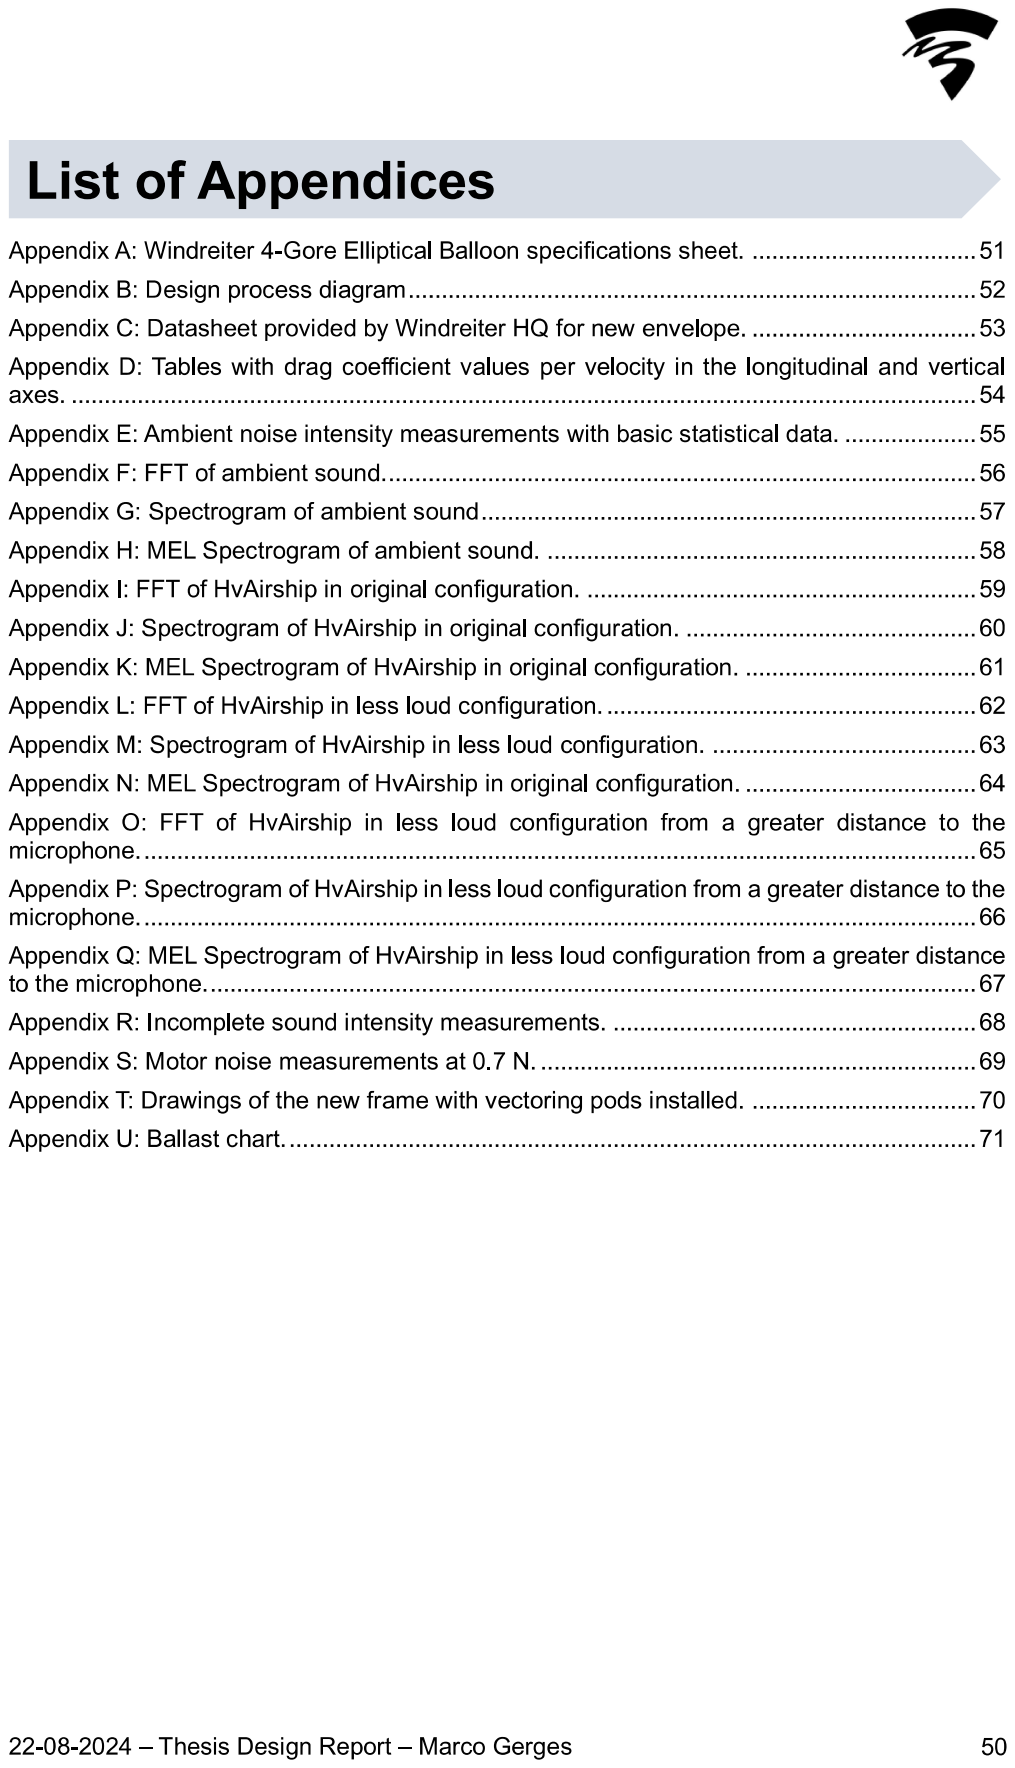
[picture p136: page 51]

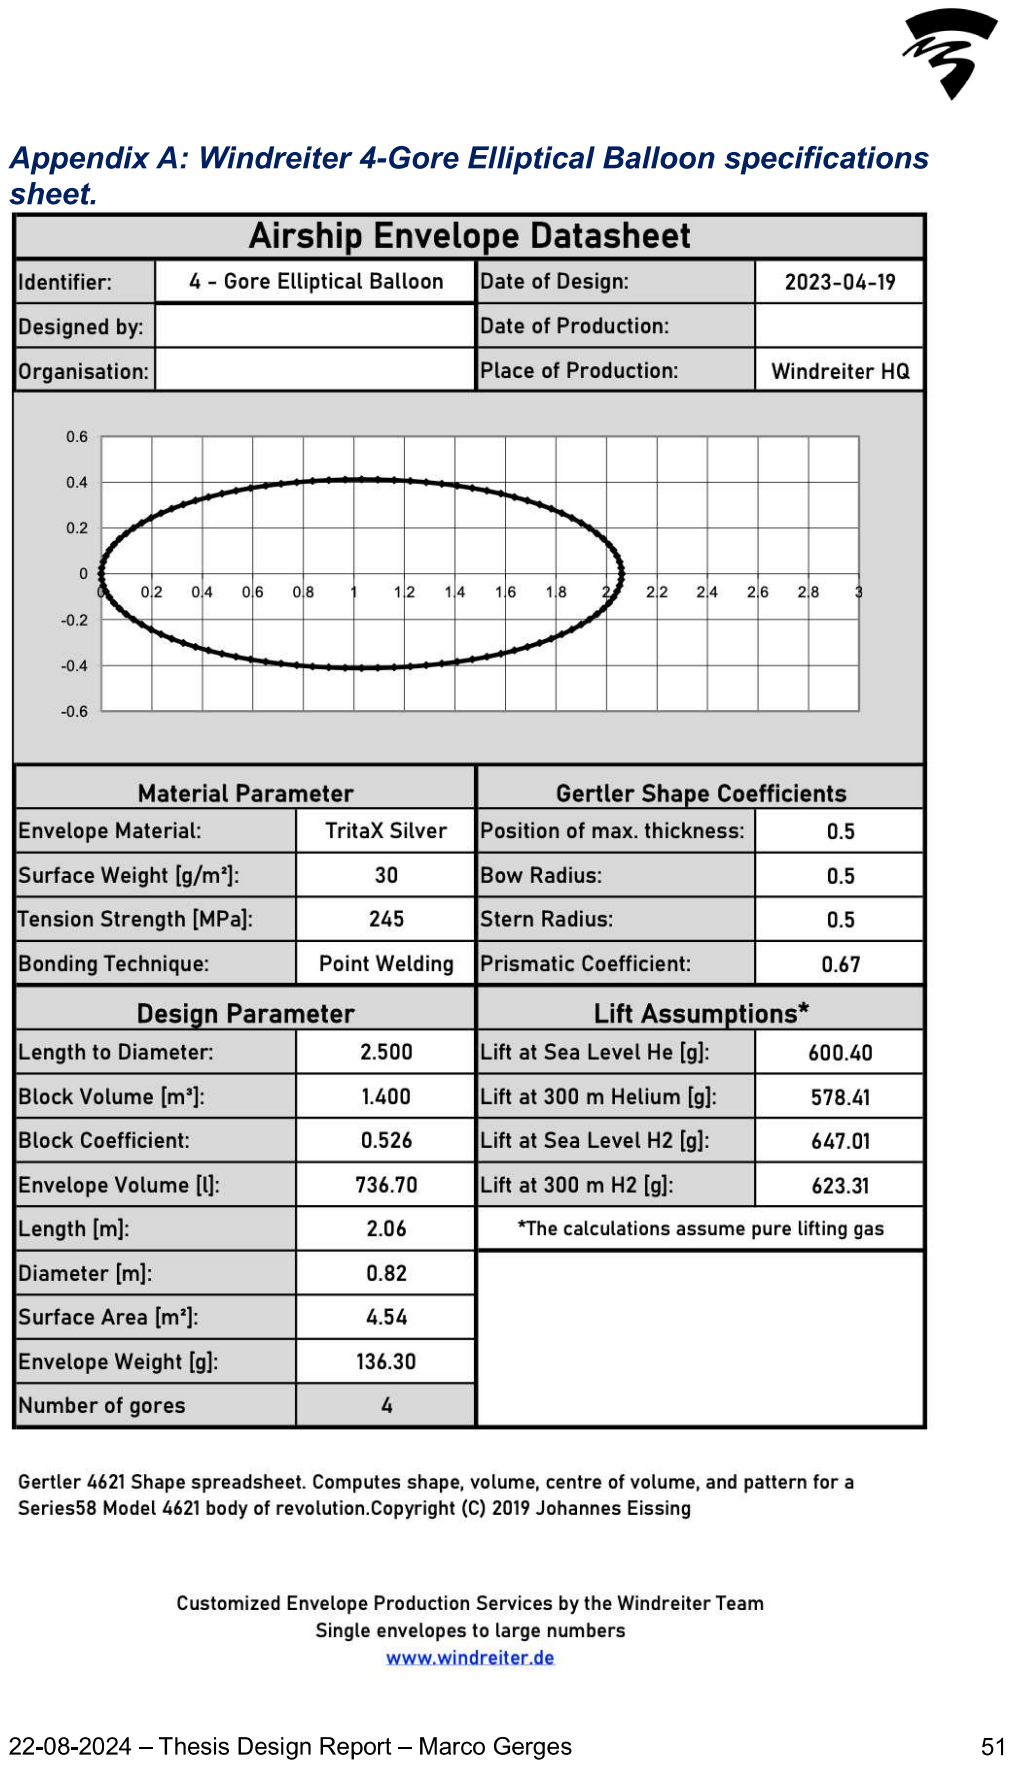
[picture p137: page 52]

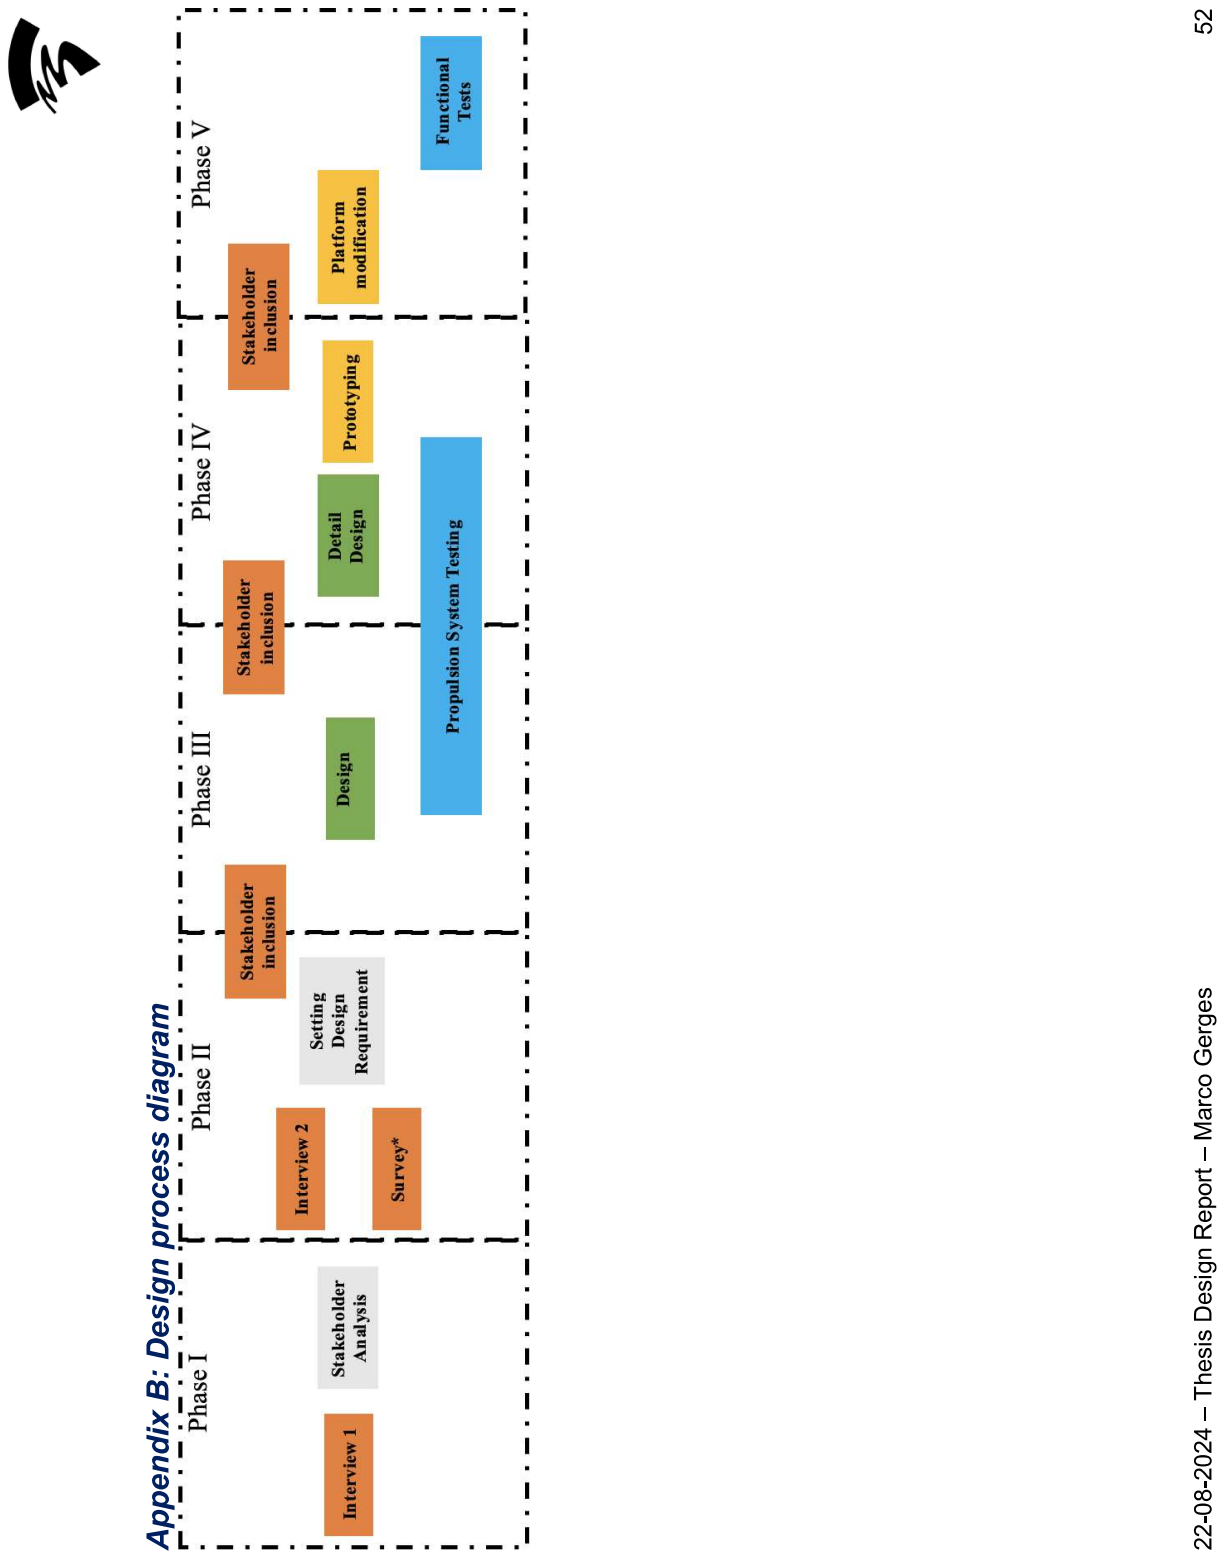
[picture p138: page 53]

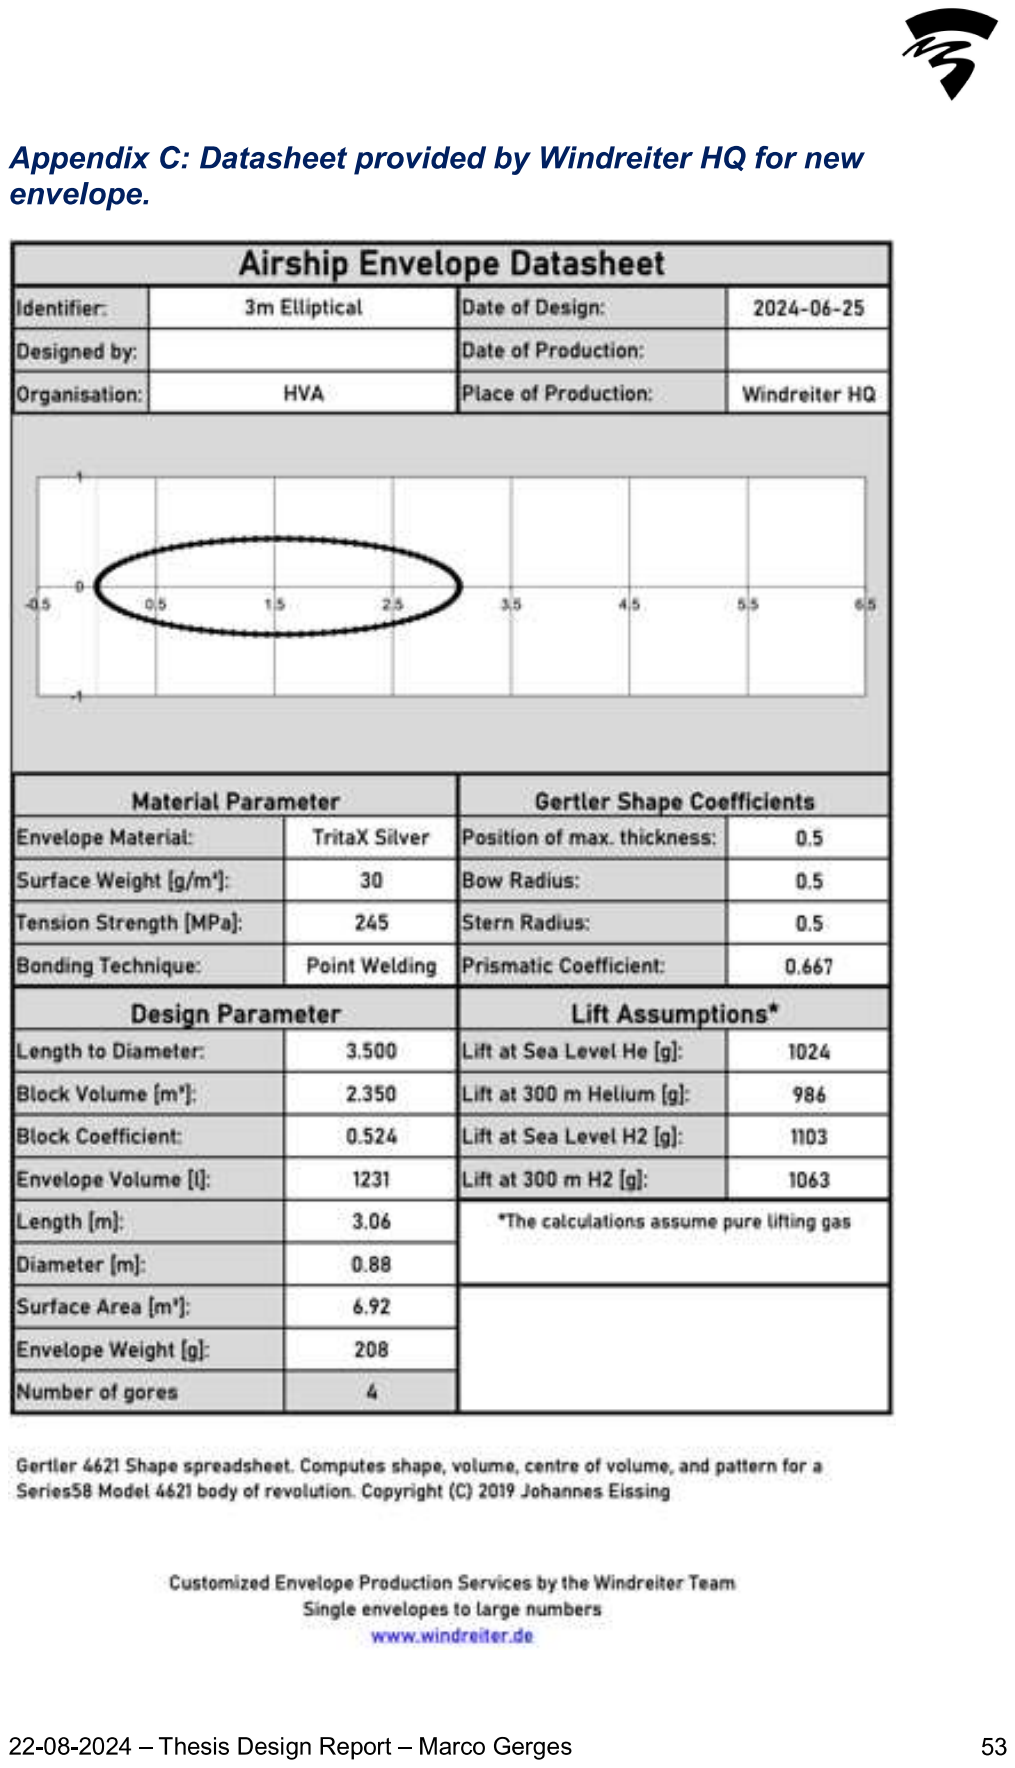
[picture p139: page 54]

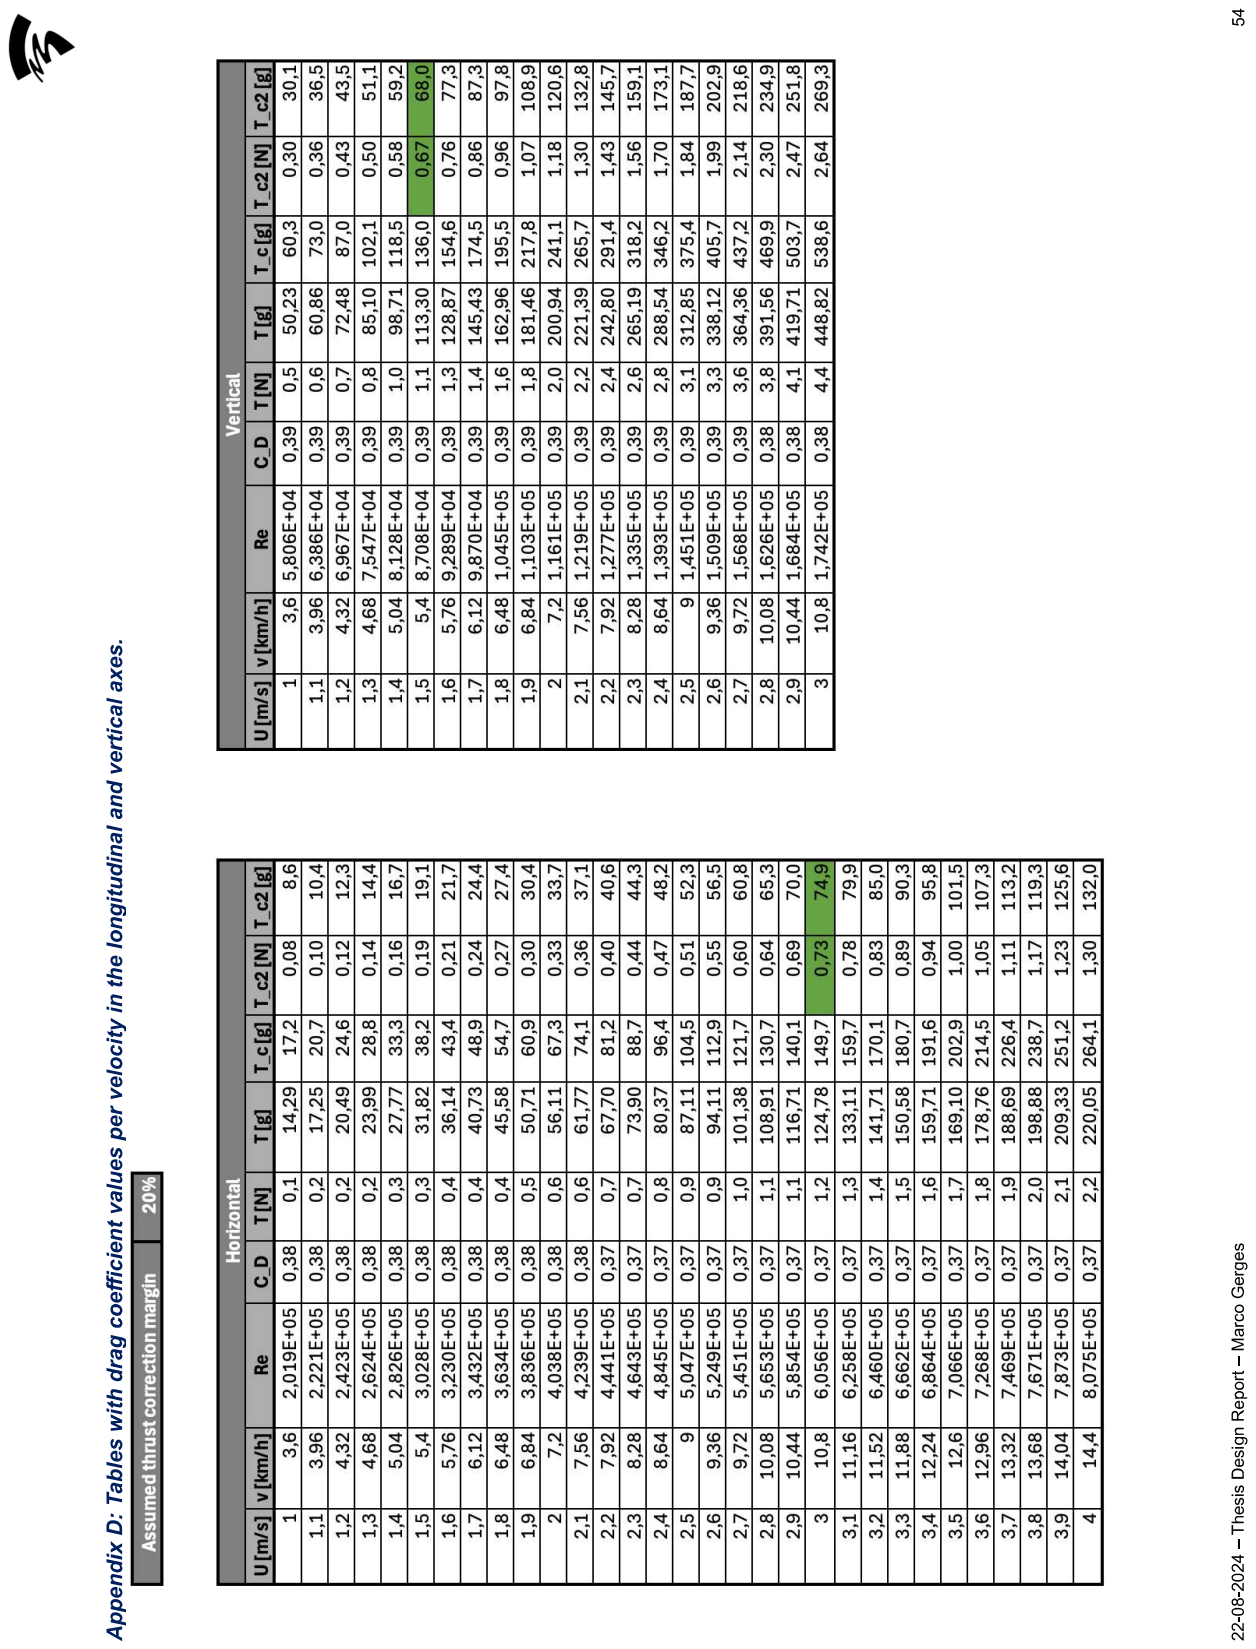
[picture p140: page 55]

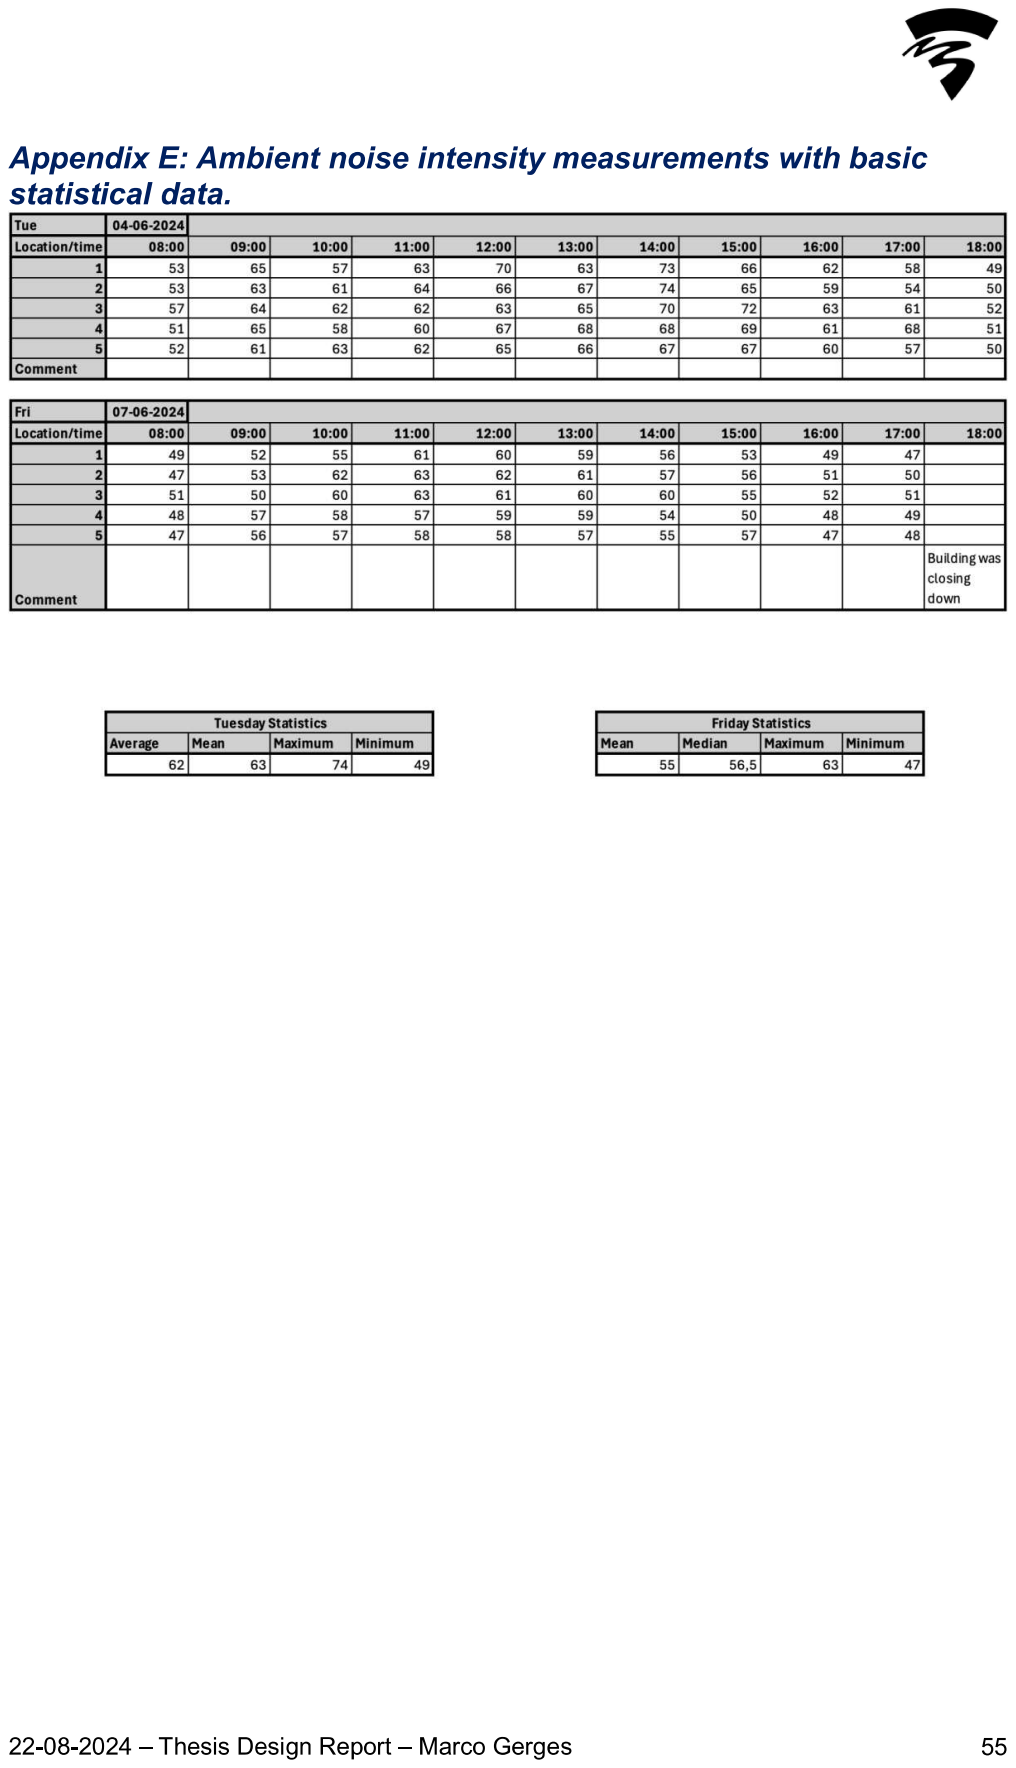
[picture p141: page 56]

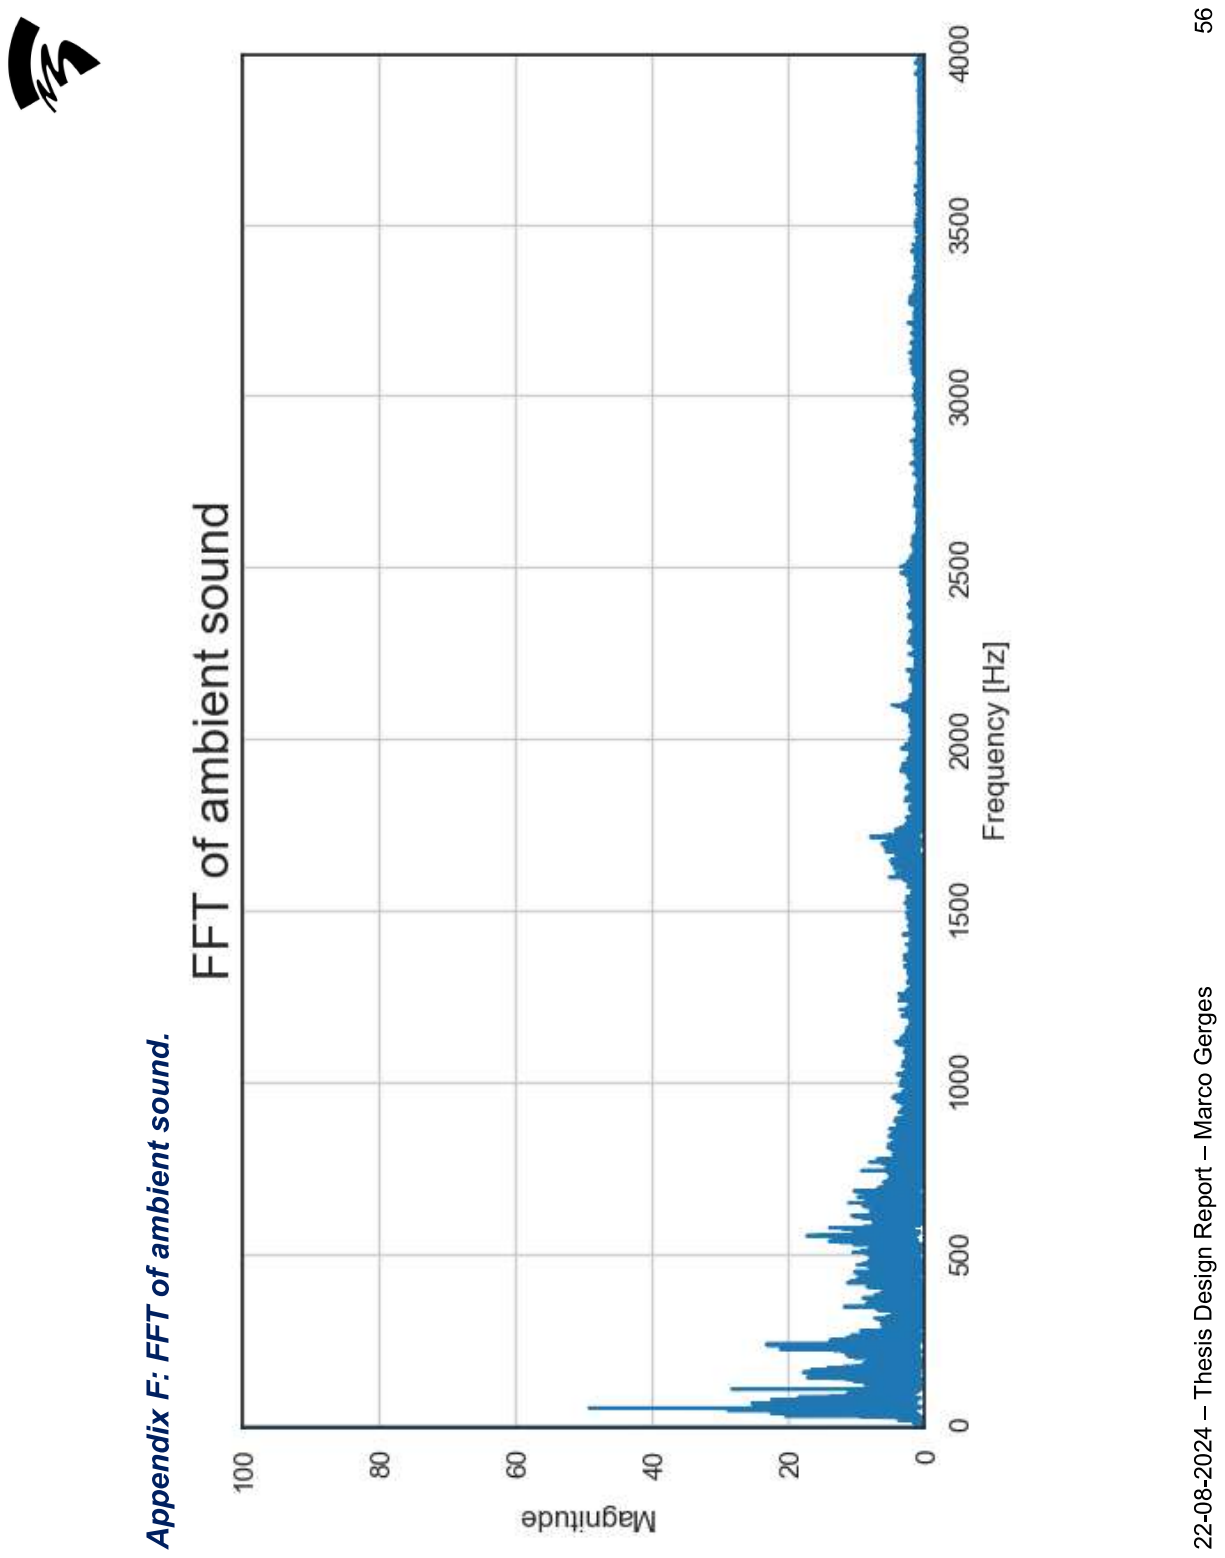
[picture p142: page 57]

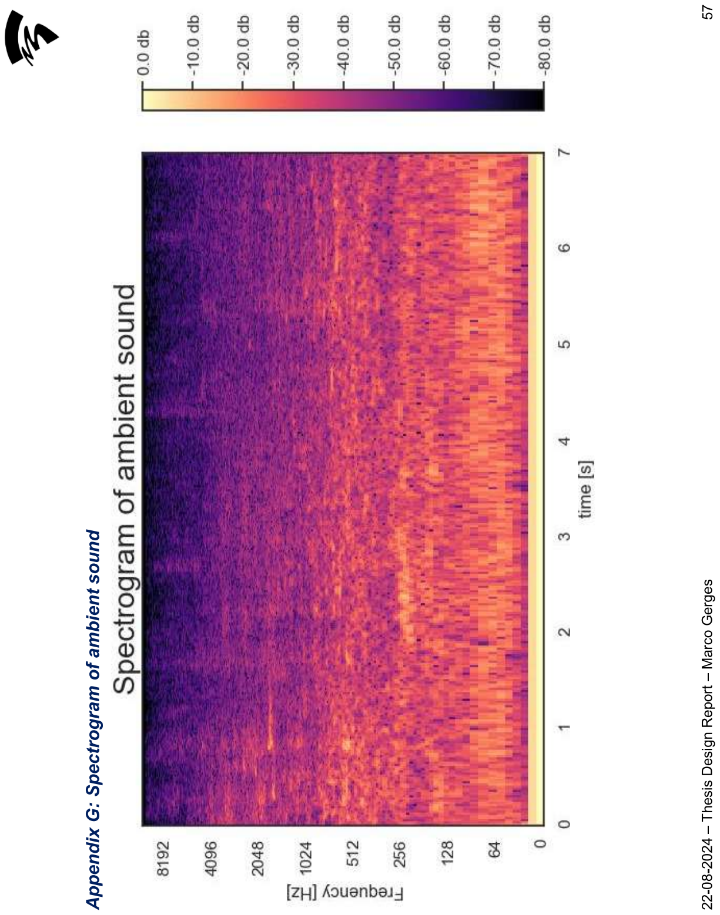
[picture p143: page 58]

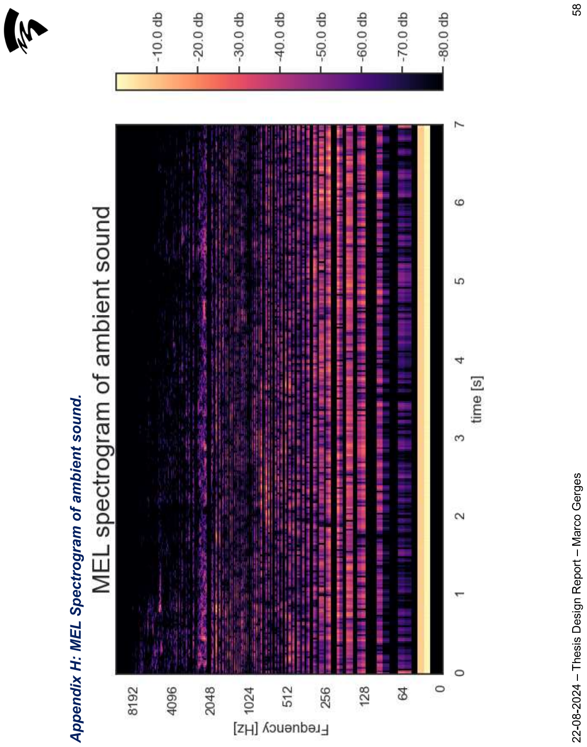
[picture p144: page 59]

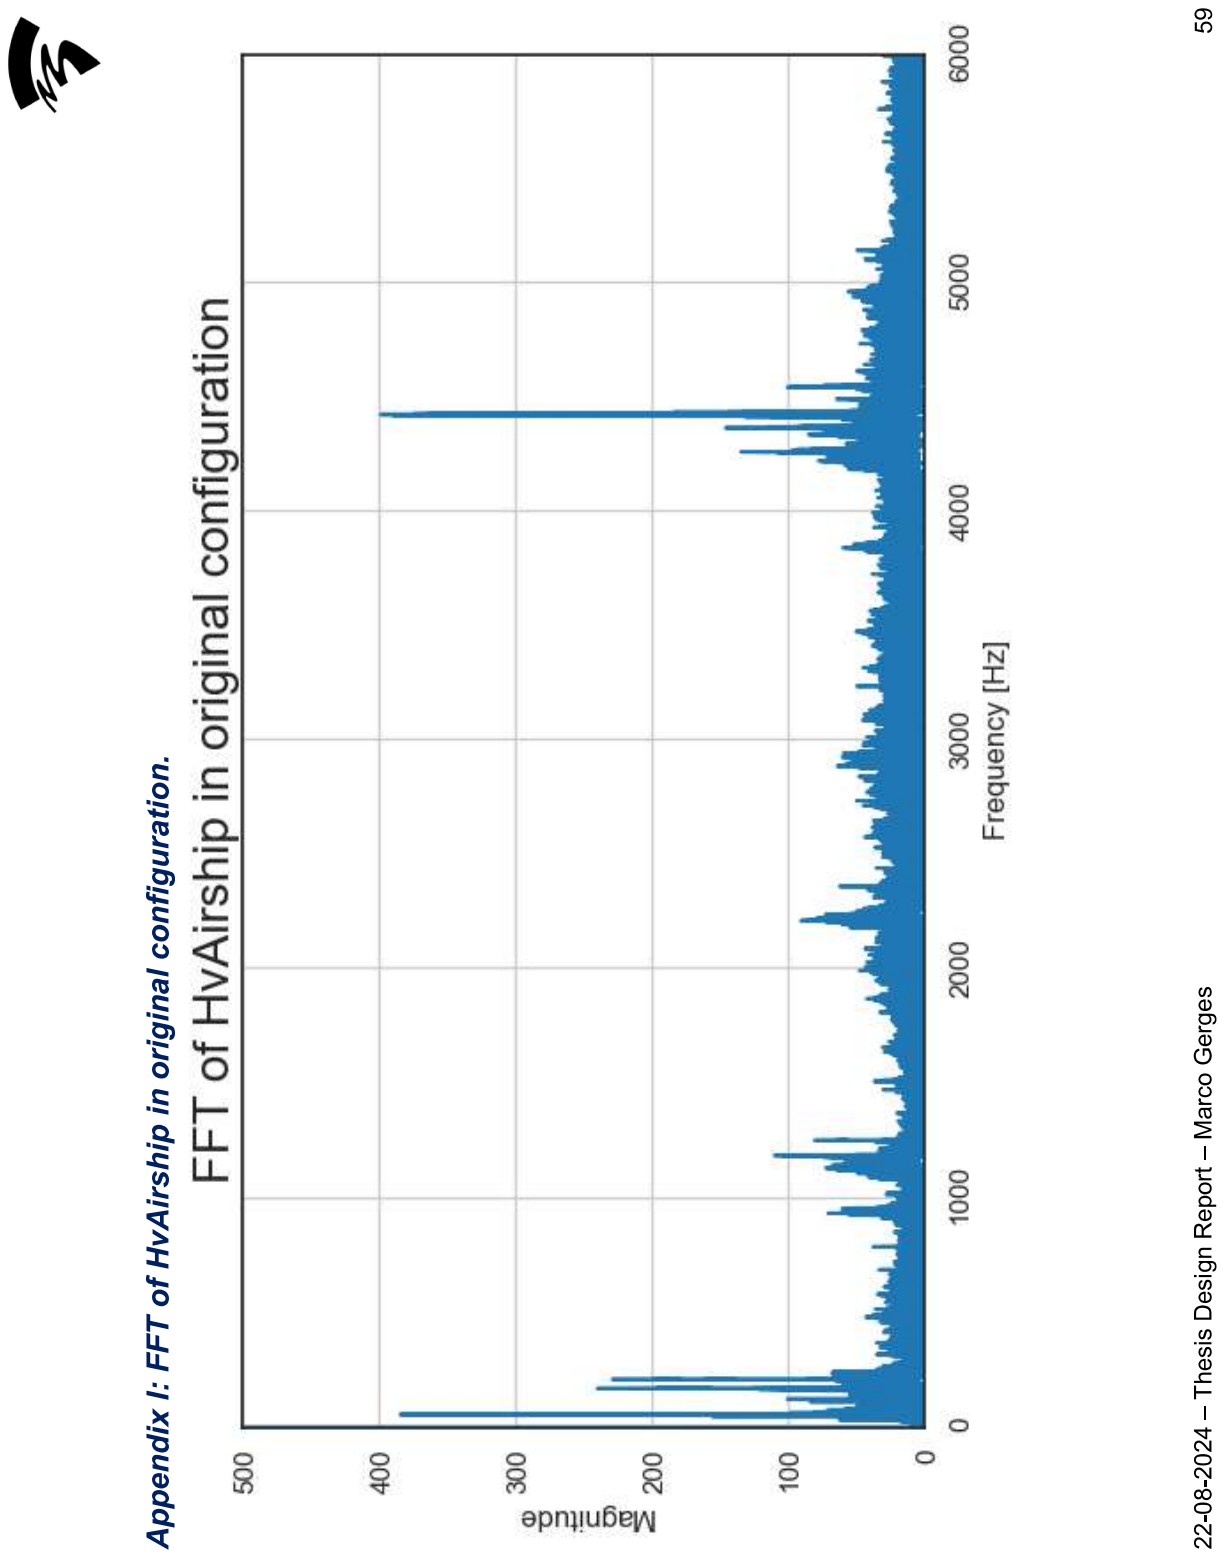
[picture p145: page 60]

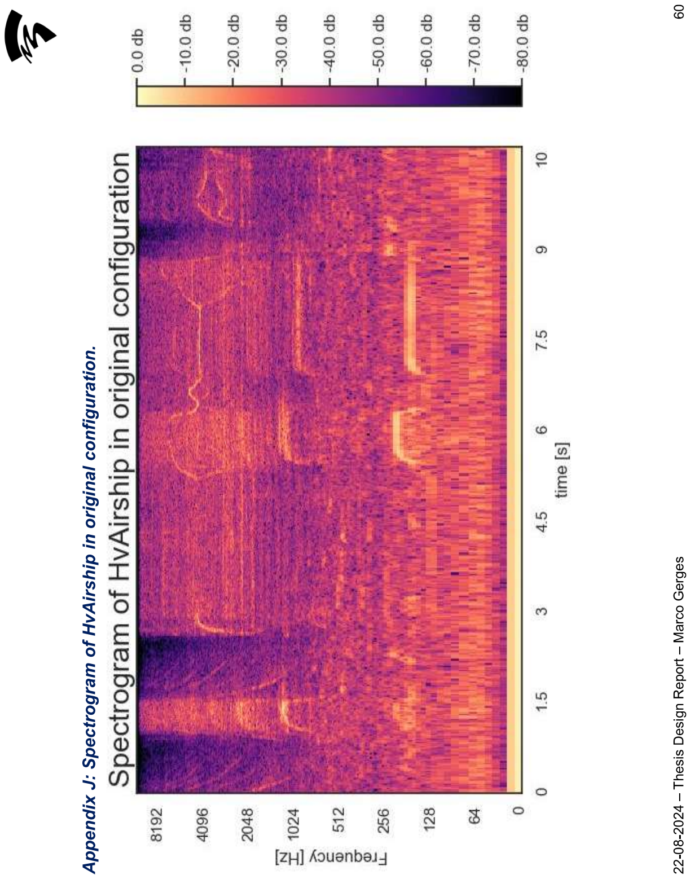
[picture p146: page 61]

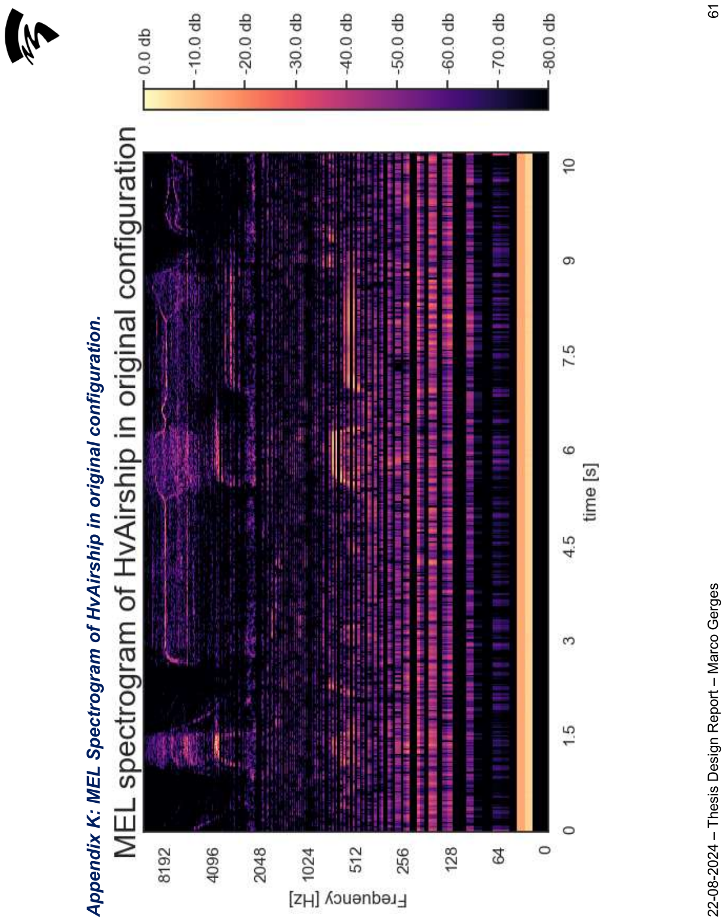
[picture p147: page 62]
