timopieters6-spec/Autonome-zepplin-BLIMP-/(commit log)

2026-09-20 Add files via upload
    Import archive 3d print files
    [BEAR_GEAR_HOUSING_SPACER_V1_2025-2-21 - Copy.3mf, BEAR_GEAR_HOUSING_SPACER_V1_2025-2-21.stl, BEAR_HOUSING_CAP_V1_2025-2-21.stl, BLIMP_FULL_V2_3MF.3mf, BOX_FRONT_REAR_V4_CF_LESS_2025-2-20.stl, BOX_SIDE_V3_2025-2-1.STL, BOX_SIDE_V4_CF_LESS_2025-2-20.stl, BOX_TOT_v1_2025-02-01.3mf]
2026-09-20 CAD upload
    [Zepplin Frame v3.stl]
2026-09-20 commit rearange
    [Zepplin Frame v3.stl]
